Appiko/sense_snap_hw/README.md

This repository contains all the KiCad based PCB design and related documentation for all the circuit boards developed at Appiko. 

All the design files are licensed using [CERN Open Hardware Licence v1.2](https://ohwr.org/project/licenses/wikis/cern-ohl-v1.2).
