Appiko/sense_snap_hw/SenseCam_XHP70.2_rev1/README.md

# SenseCam_XHP70.2_rev1

This repo contains the Kicad PCB design of the first revision of SenseCam LED Flash with XHP70.2 high power LEDs. This board is designed to be driven by SenseCam_STCS2A_rev1 LED driver board, and work with SenseCam_rev1 to make night photography in pitch dark possible without motion blur.

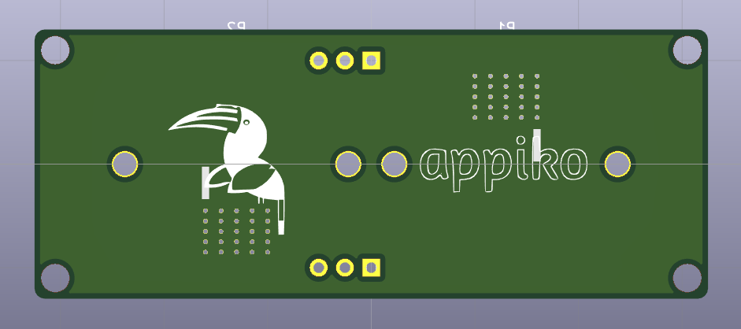
[picture p1: SenseCam_XHP70.2_rev1/Images/SenseCam_XHP70.2_rev1_back.png]
SenseCam_XHP70.2_rev1 back

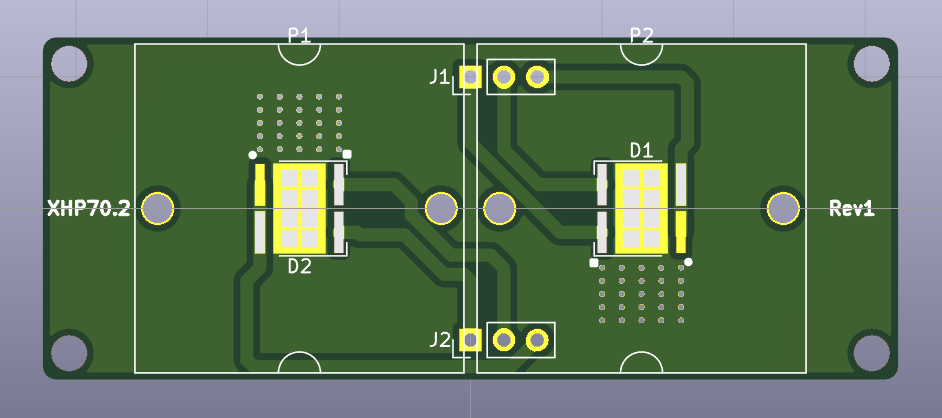
[picture p2: SenseCam_XHP70.2_rev1/Images/SenseCam_XHP70.2_rev1_front.png]
SenseCam_XHP70.2_rev1 front
