Appiko/sense_snap_hw/SenseCam_STCS2A_rev1/README.md

# SenseCam_STCS2A_rev1

This repo contains the Kicad PCB design of the first revision of SenseCam LED Flash driver board containing the STCS2A constant current LED driver IC. This board is designed to be driven by SenseCam_rev1 to provide enough current to drive the LEDs for a powerful flash.

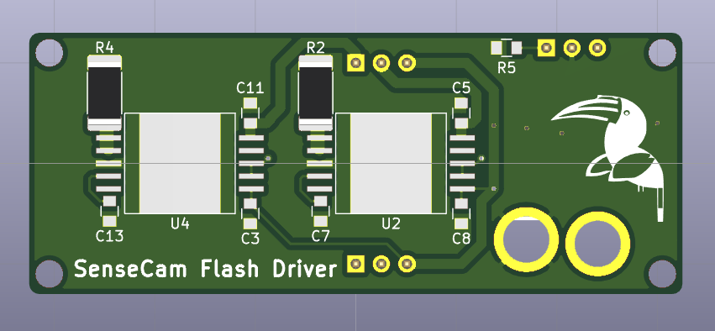
[picture p3: SenseCam_STCS2A_rev1/Images/SenseCam_STCS2A_rev1_back.png]
SenseCam_STCS2A_rev1 back

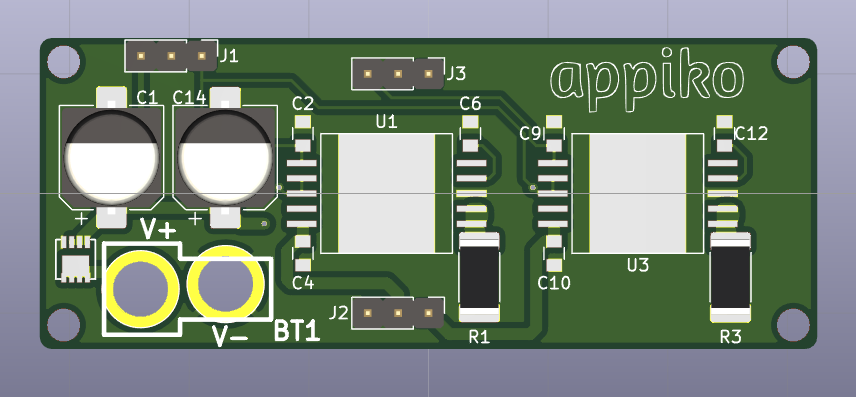
[picture p4: SenseCam_STCS2A_rev1/Images/SenseCam_STCS2A_rev1_front.png]
SenseCam_STCS2A_rev1 front
