Appiko/sense_snap_hw/detect_rev1/output/detect_rev1_back3D.png

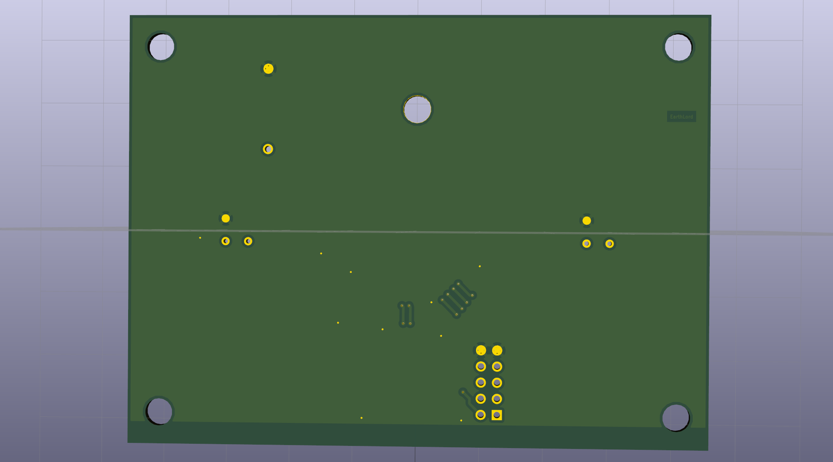
detect_rev1/output/detect_rev1_back3D.png
