Appiko/sense_snap_hw/detect_rev1/output/detect_rev1_front3D.png

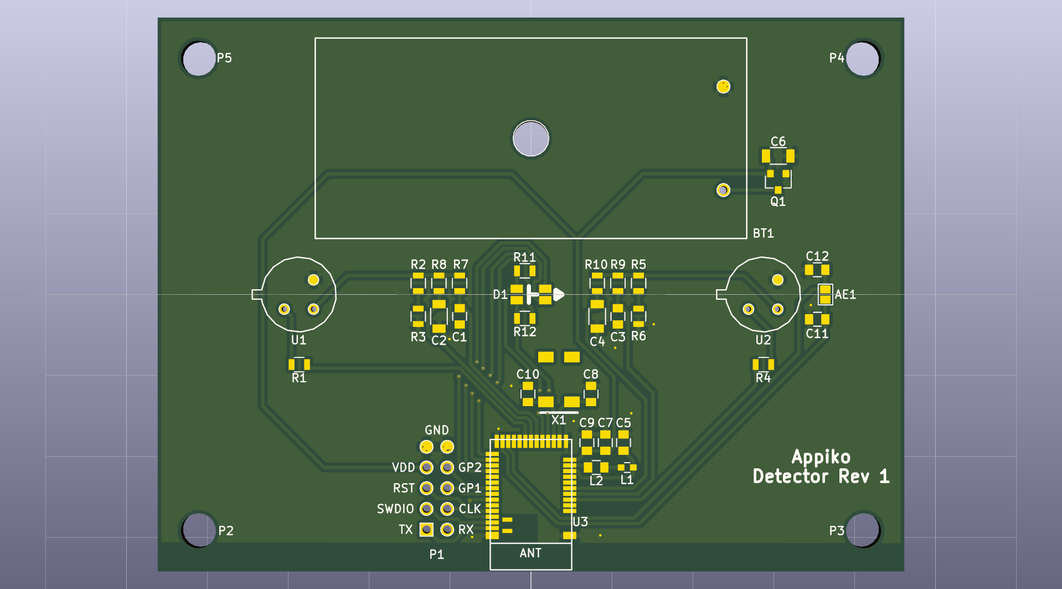
detect_rev1/output/detect_rev1_front3D.png
