Appiko/sense_snap_hw/senseBeRx_rev3/Images/SenseBeRx_rev3_2.png

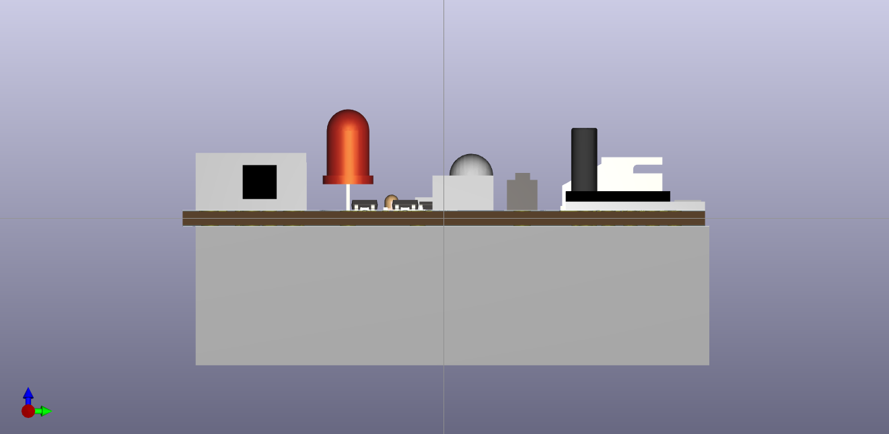
senseBeRx_rev3/Images/SenseBeRx_rev3_2.png
