Appiko/sense_snap_hw/snap_rev3/datasheets/LED_5mm_dimensions.jpg

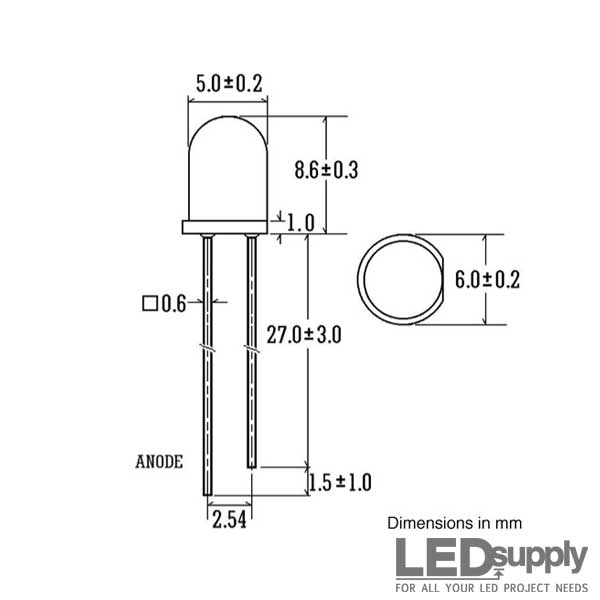
snap_rev3/datasheets/LED_5mm_dimensions.jpg
