Appiko/sense_snap_hw/snap_rev3/images/snap_rev3_02.png

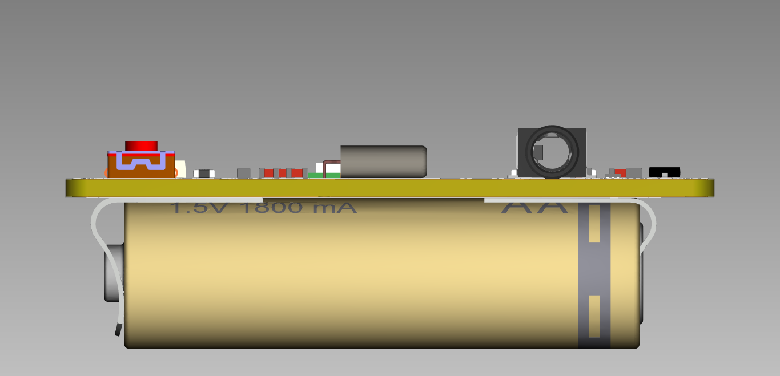
snap_rev3/images/snap_rev3_02.png
