Appiko/sense_snap_hw/AR0135_OpenMV_adapter_rev1/AR0135_OpenMV_adapter_rev1_3D Files/DF12(3.5)-36DP-0.5V.stp

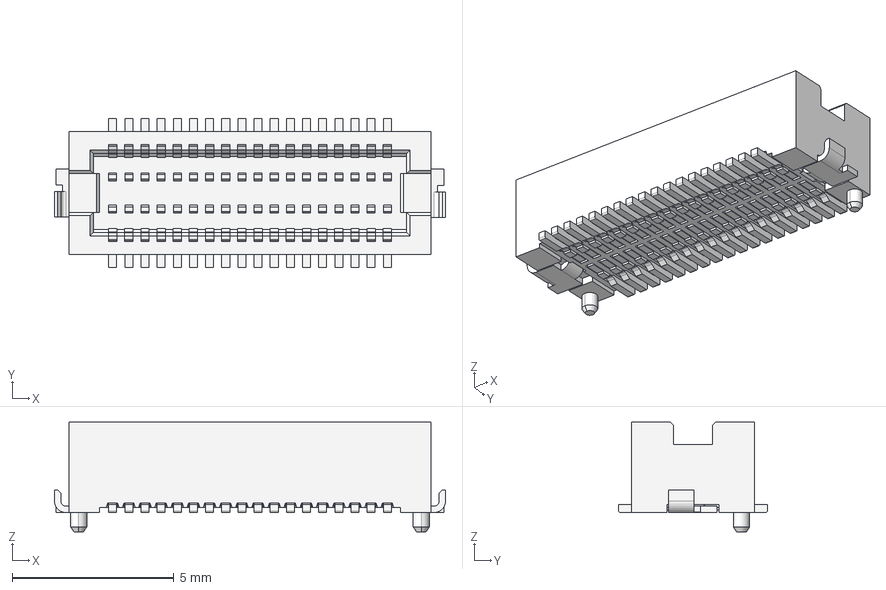
[picture p26: CAD file, 2019-07-17]
AR0135_OpenMV_adapter_rev1/AR0135_OpenMV_adapter_rev1_3D Files/DF12(3.5)-36DP-0.5V.stp
12.1 x 4.60 x 3.40 mm
