Appiko/sense_snap_hw/sense_rev5/SensePi_rev5_main/Datasheets/MDBT42Q_MDBT42Q-P Footprint_Design Guide-20171016/2D & 3D Drawing/MDBT42Q-P/MDBT42Q-P 2D Drawing-20170503.dxf

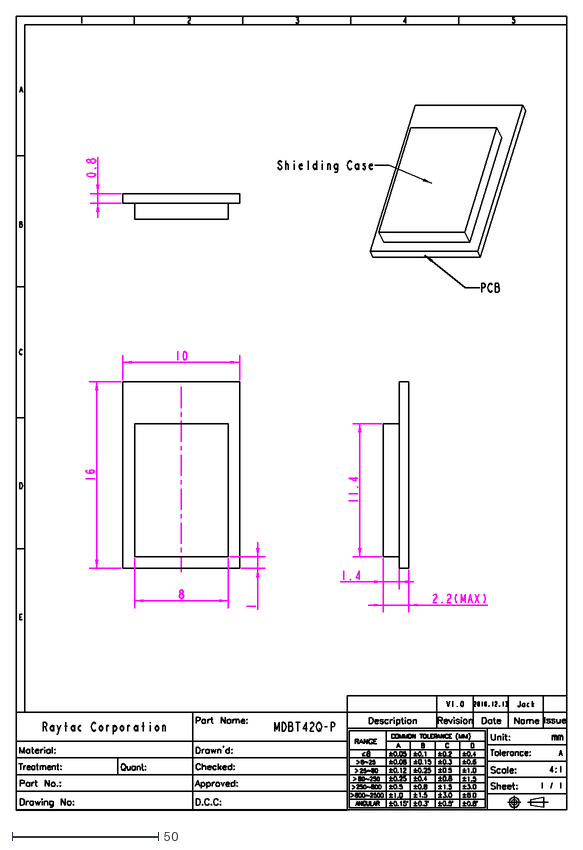
[picture p27: CAD file, 2018-01-06]
sense_rev5/SensePi_rev5_main/Datasheets/MDBT42Q_MDBT42Q-P Footprint_Design Guide-20171016/2D & 3D Drawing/MDBT42Q-P/MDBT42Q-P 2D Drawing-20170503.dxf
188.5 x 271.9
