Appiko/sense_snap_hw/senseBeRx_rev3/senseBeRx_rev3_3D_Files/SenseBeRx_3DModel.fcstd

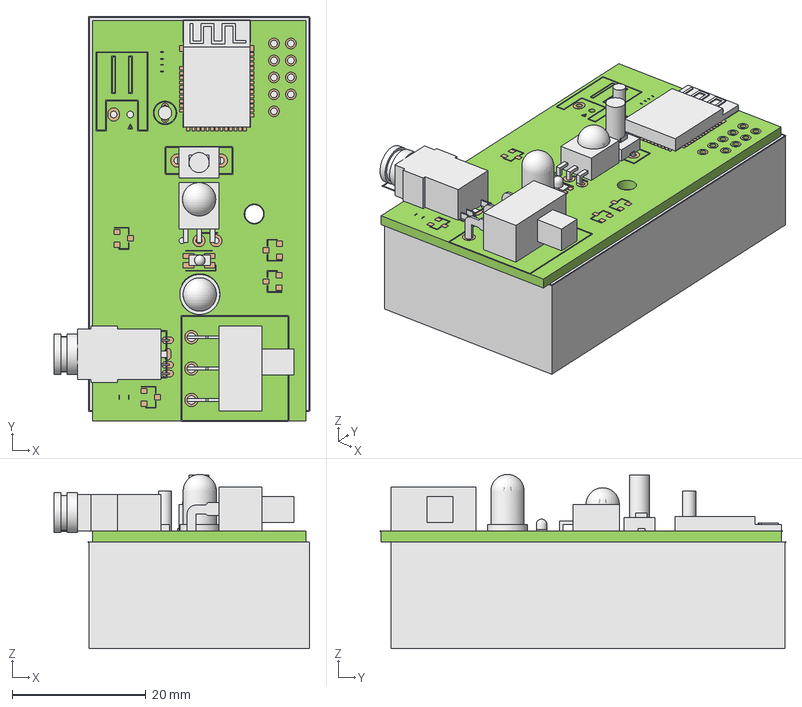
[picture p29: CAD file, 2019-01-24]
senseBeRx_rev3/senseBeRx_rev3_3D_Files/SenseBeRx_3DModel.fcstd
38.3 x 60.6 x 26.1 mm
PJ-32434_3-5mm_AudioJack
C5404_AAx2_Battery_Holder
Button_TC-1101T-C-A-B
nRF-MDBT42Q
RX_TSSP4056
LED
Crystal_THP001
Light_Sensor
Board
bPad_
tPad_
B_SilkS_
F_SilkS_
SlideSwitch_1P2T_RightAngle
Button
