Appiko/sense_snap_hw/snap_rev2_anool/fabricate/snap_rev2.fcstd

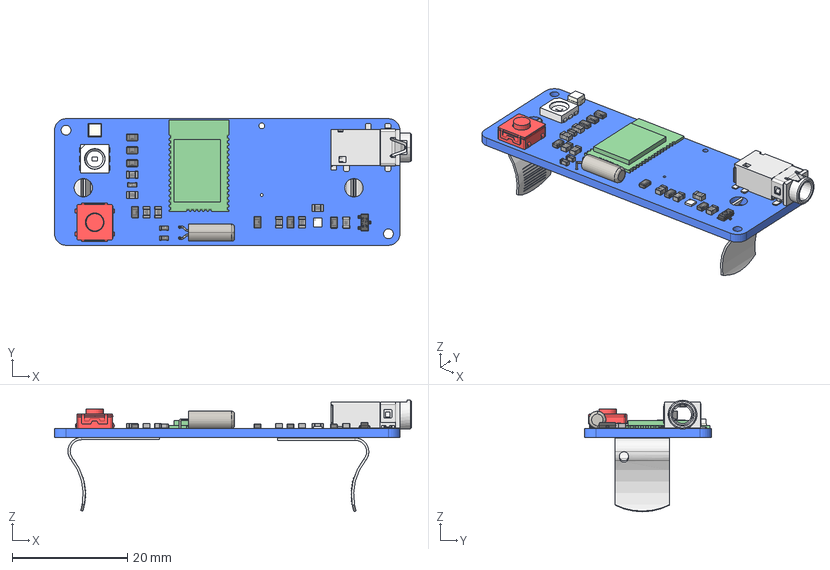
[picture p30: CAD file, 2017-11-04]
snap_rev2_anool/fabricate/snap_rev2.fcstd
62.0 x 22.0 x 19.4 mm
Pcb
TL3304_
IR26_
SW3dPS-0805_SMD_Resistor_
MDBT42Q_
WSON6_
SW3dPS-0805_SMD_Resistor_001
SW3dPS-0805_SMD_Resistor_002
SW3dPS-0805_SMD_Resistor_003
SW3dPS-0805_SMD_Resistor_004
SW3dPS-0805_SMD_Resistor_005
SW3dPS-0805_SMD_Resistor_006
Tr_SOT23_
CapCeramic_080_
CapCeramic_080_001
CapCeramic_0603_
CapCeramic_080_002
CapCeramic_0603_001
CapCeramic_080_003
CapCeramic_0603_002
CapCeramic_080_004
CapCeramic_080_005
CapCeramic_080_006
CapCeramic_080_007
sj2-35894b-smt-tr002_
xtal-AB308_
keystone_208_
