Appiko/sense_snap_hw/snap_rev3/3d_modules/keystone_206.step

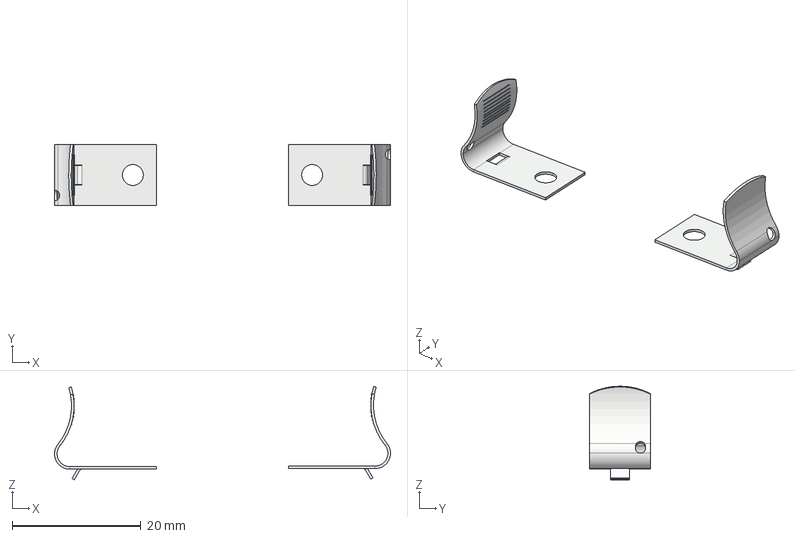
[picture p31: CAD file, 2017-11-07]
snap_rev3/3d_modules/keystone_206.step
52.3 x 9.53 x 14.6 mm
