Appiko/sense_snap_hw/snap_rev3/fabricate/case_rev1/case_bot.stl

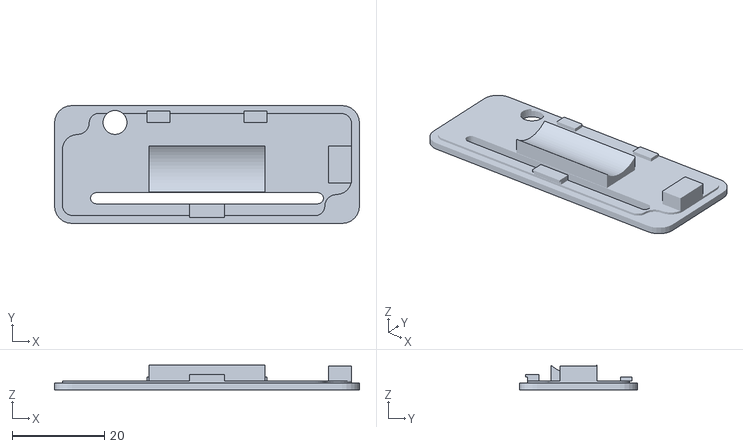
[picture p32: CAD file, 2017-11-12]
snap_rev3/fabricate/case_rev1/case_bot.stl
66.0 x 25.5 x 5.41
