Appiko/sense_snap_hw/snap_rev3/fabricate/snap_case_rev2_mid.stl

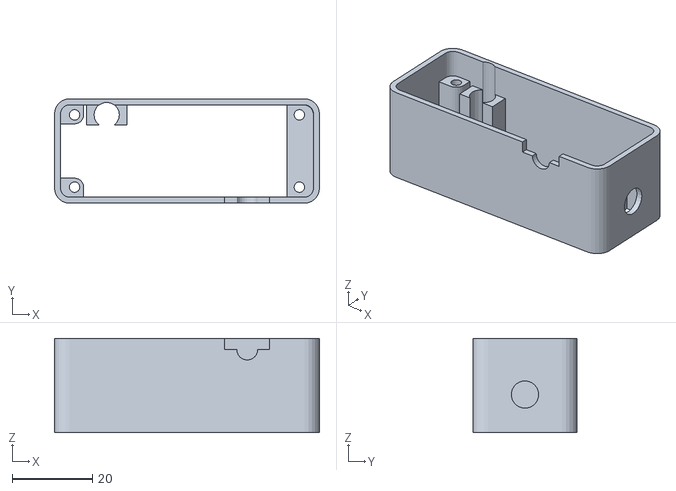
[picture p33: CAD file, 2018-01-18]
snap_rev3/fabricate/snap_case_rev2_mid.stl
66.0 x 26.0 x 23.5
