Appiko/sense_snap_hw/snap_rev3/3d_modules/LED-5-mm.step

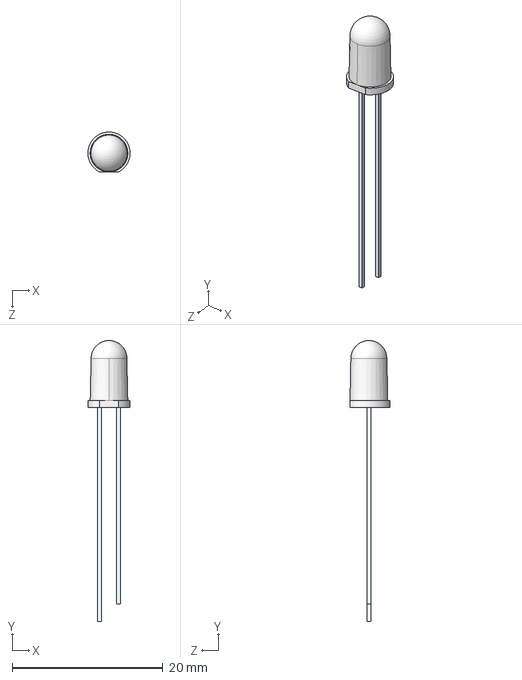
[picture p34: CAD file, 2017-11-06]
snap_rev3/3d_modules/LED-5-mm.step
5.60 x 37.2 x 5.30 mm
User Library-LED 5 mm Full_lED Leg
User Library-LED 5 mm Full_LED F
