Appiko/sense_snap_hw/snap_rev3/fabricate/case_rev1/case_button.stl

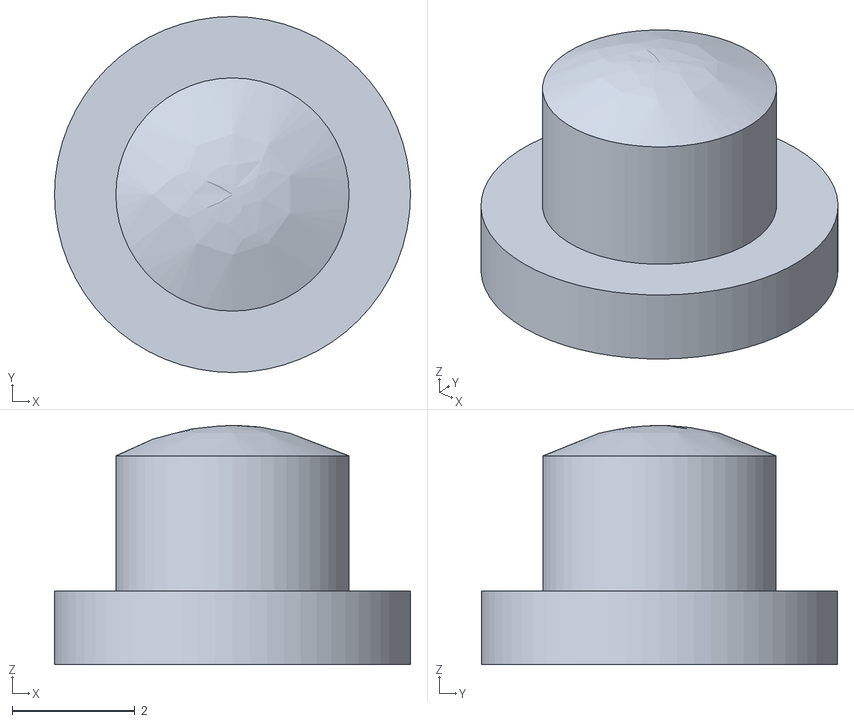
[picture p35: CAD file, 2017-11-12]
snap_rev3/fabricate/case_rev1/case_button.stl
5.80 x 5.80 x 3.89
