Appiko/sense_snap_hw/snap_rev3/3d_modules/sw_TL3304AFxxxQJ.stp

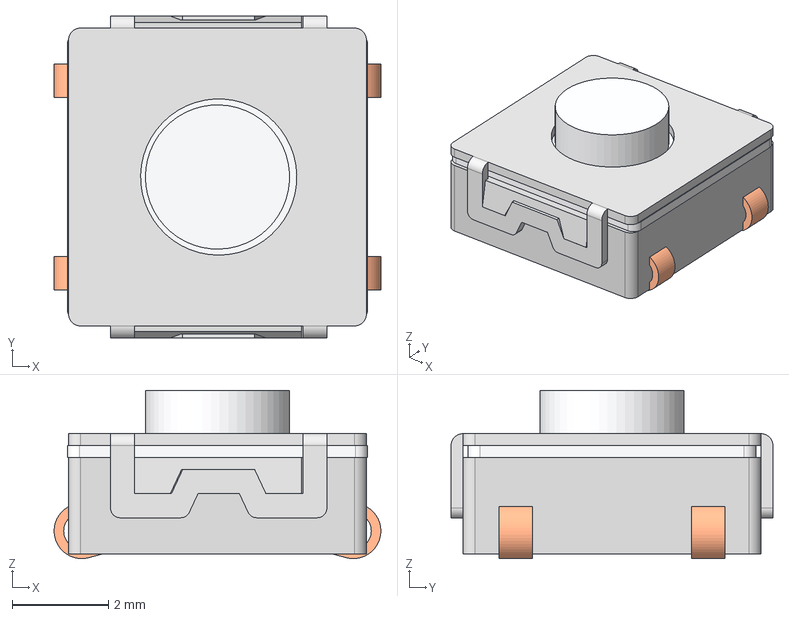
[picture p36: CAD file, 2017-11-04]
snap_rev3/3d_modules/sw_TL3304AFxxxQJ.stp
6.80 x 6.70 x 3.50 mm
TL3304BODY
TL3304 BRACKET
TL3304ASEAL
TL3304-Terminals J-LEAD
