Appiko/sense_snap_hw/snap_rev3/fabricate/snap_case_rev2_top.stl

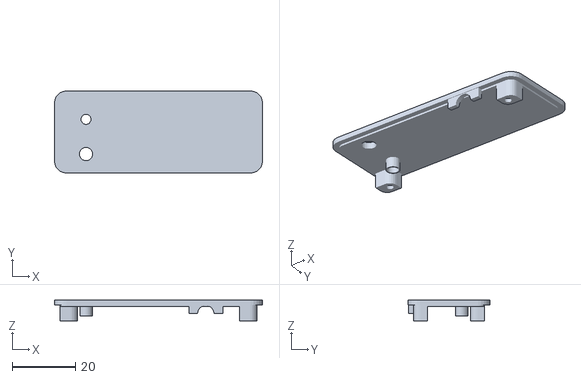
[picture p37: CAD file, 2018-01-18]
snap_rev3/fabricate/snap_case_rev2_top.stl
66.0 x 26.0 x 6.60
