Appiko/sense_snap_hw/snap_rev3/3d_modules/TL3304.step

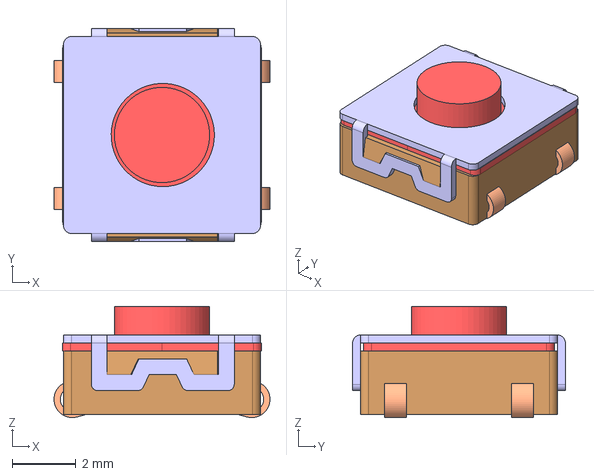
[picture p38: CAD file, 2017-11-04]
snap_rev3/3d_modules/TL3304.step
6.80 x 6.70 x 3.50 mm
