Appiko/sense_snap_hw/snap_rev3/fabricate/snap_case_rev2_bot.stl

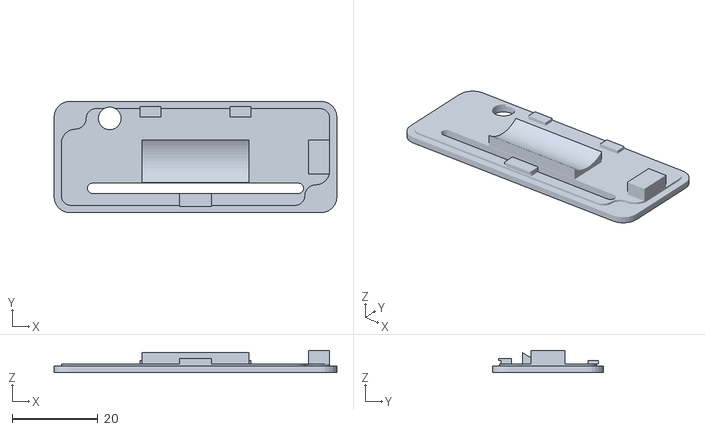
[picture p39: CAD file, 2018-01-18]
snap_rev3/fabricate/snap_case_rev2_bot.stl
66.0 x 26.0 x 5.20
