Appiko/sense_snap_hw/snap_rev3/3d_modules/sj2-35894b-smt.step

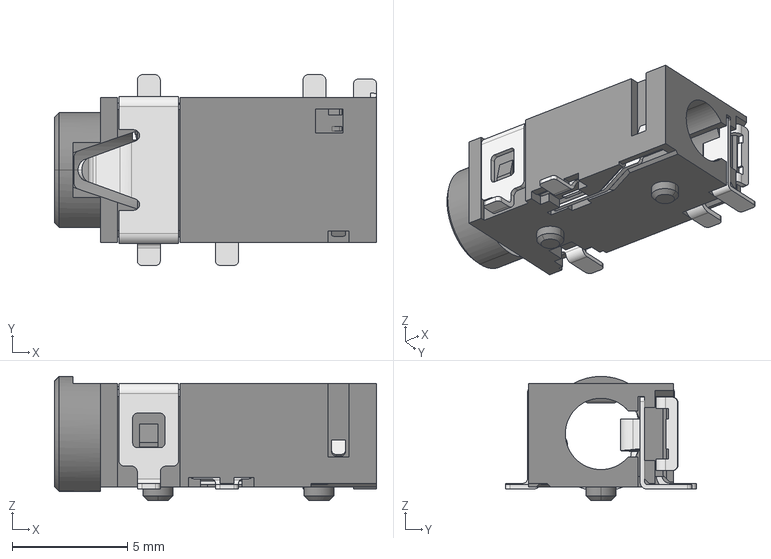
[picture p40: CAD file, 2017-11-03]
snap_rev3/3d_modules/sj2-35894b-smt.step
14.0 x 8.30 x 5.40 mm
