Appiko/sense_snap_hw/snap_rev3/fabricate/case_rev1/case_top.stl

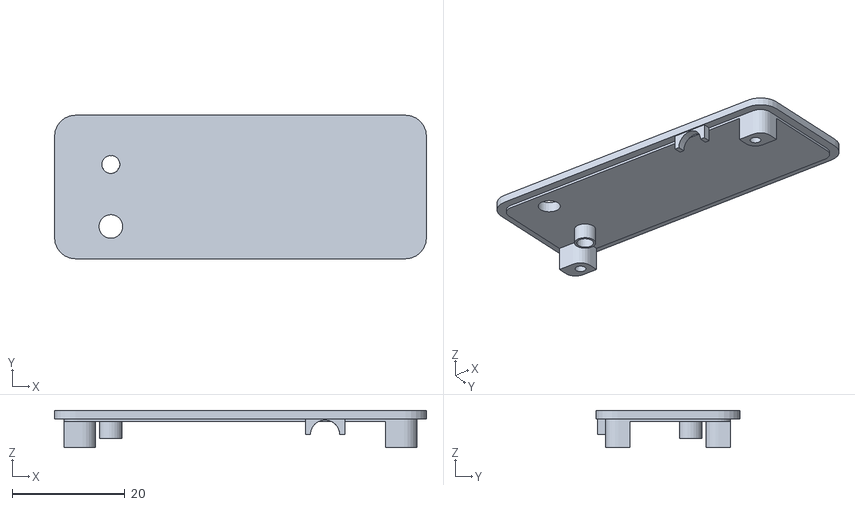
[picture p41: CAD file, 2017-11-12]
snap_rev3/fabricate/case_rev1/case_top.stl
66.0 x 25.5 x 6.60
