Appiko/sense_snap_hw/snap_rev3/3d_modules/IR26_VSMY2850RG.STEP

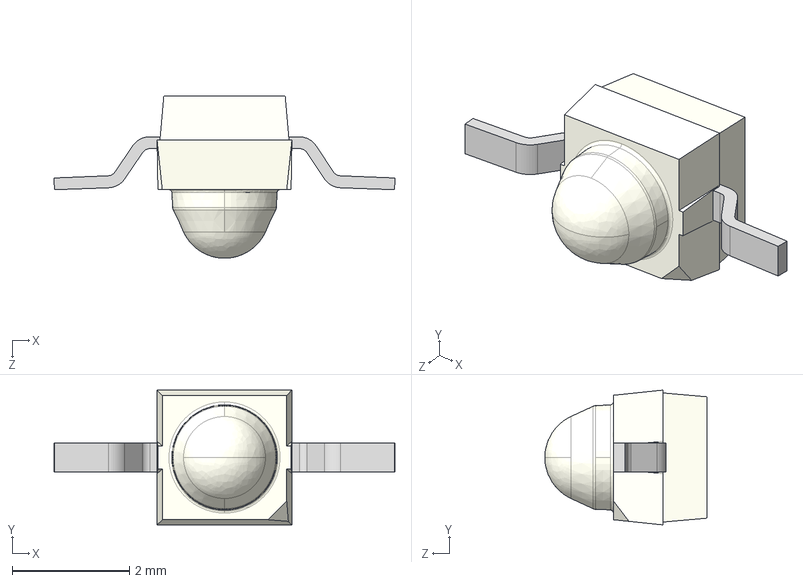
[picture p42: CAD file, 2017-11-03]
snap_rev3/3d_modules/IR26_VSMY2850RG.STEP
5.81 x 2.30 x 2.77 mm
User Library-VSMY2850RG_Free-Models
User Library-VSMY2850RG_Fillet001
