Appiko/sense_snap_hw/snap_rev3/fabricate/BATTERY_AA.step

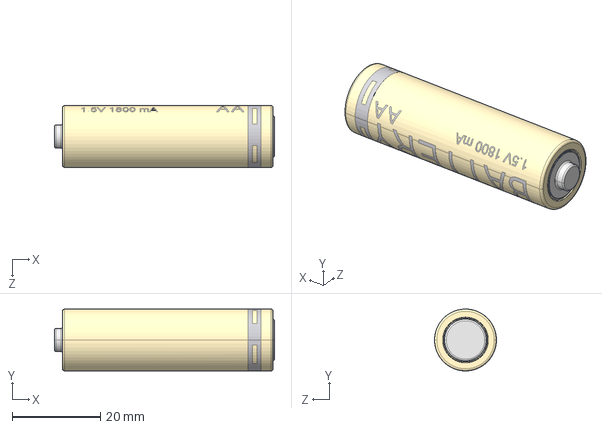
[picture p43: CAD file, 2017-11-04]
snap_rev3/fabricate/BATTERY_AA.step
49.8 x 14.0 x 14.0 mm
