Appiko/sense_snap_hw/snap_rev3/fabricate/case_rev1/snap_rev3.FCStd

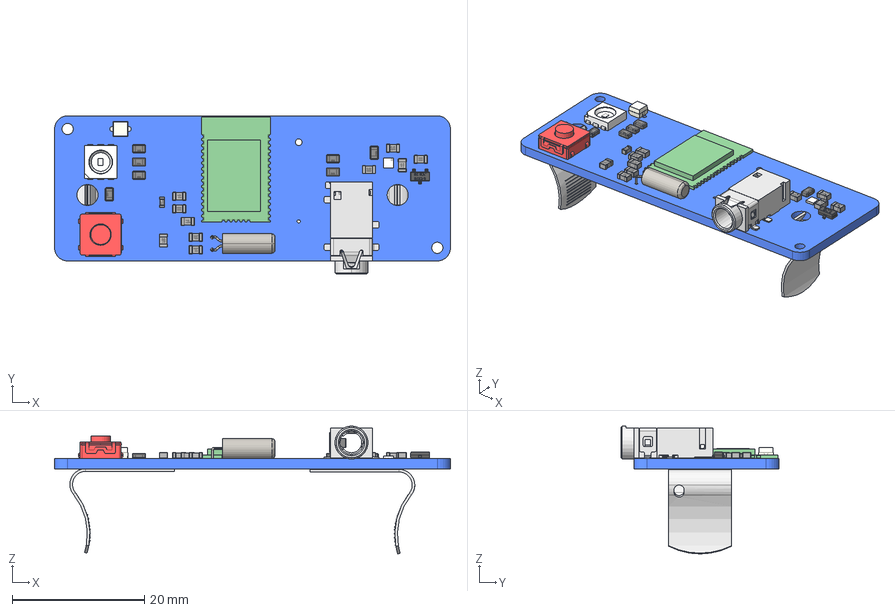
[picture p44: CAD file, 2017-11-07]
snap_rev3/fabricate/case_rev1/snap_rev3.FCStd
60.0 x 24.0 x 19.4 mm
Pcb
xtal-AB308_
CapCeramic_080_
CapCeramic_080_001
IR26_
keystone_208_
TL3304_
SW3dPS-0805_SMD_Resistor_
MDBT42Q_
WSON6_
SW3dPS-0805_SMD_Resistor_001
SW3dPS-0805_SMD_Resistor_002
SW3dPS-0805_SMD_Resistor_003
SW3dPS-0805_SMD_Resistor_004
SW3dPS-0805_SMD_Resistor_005
SW3dPS-0805_SMD_Resistor_006
Tr_SOT23_
CapCeramic_080_002
CapCeramic_080_003
CapCeramic_0603_
CapCeramic_080_004
CapCeramic_080_005
CapCeramic_080_006
CapCeramic_080_007
CapCeramic_080_008
CapCeramic_080_009
sj2-35894b-smt-tr002_
