Appiko/sense_snap_hw/snap_rev3/3d_modules/nrf52.step

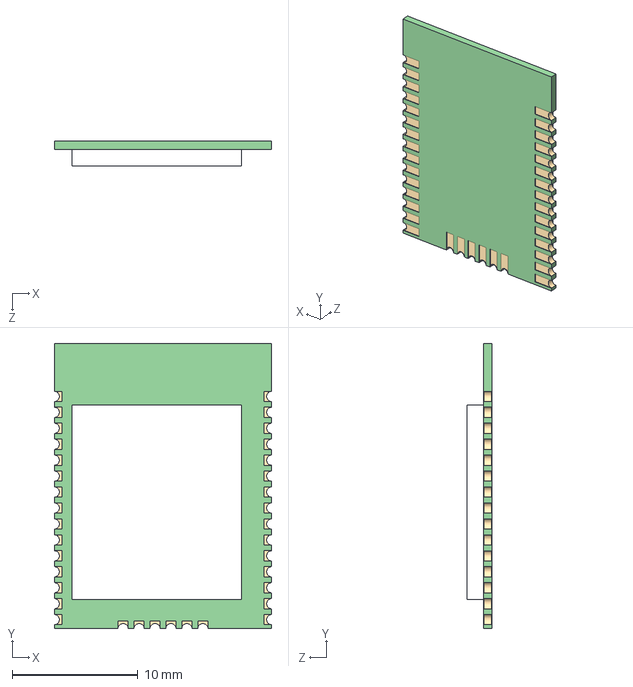
[picture p45: CAD file, 2017-11-03]
snap_rev3/3d_modules/nrf52.step
17.3 x 22.7 x 2.00 mm
