Appiko/sense_snap_hw/snap_rev3/3d_modules/IR26.step

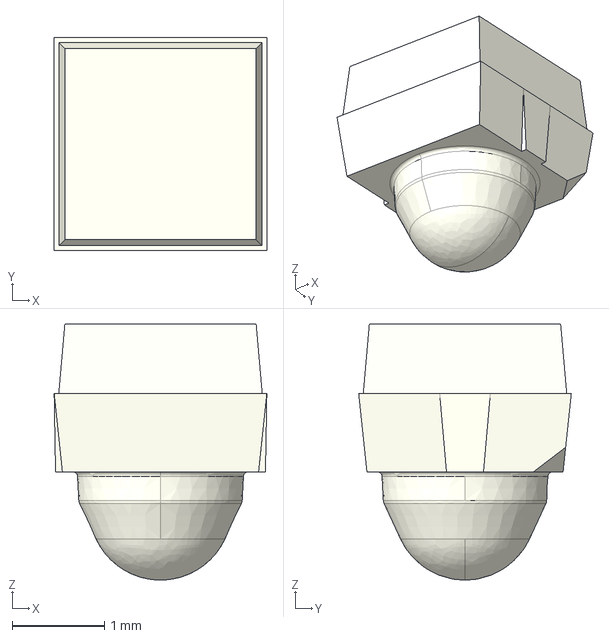
[picture p46: CAD file, 2017-11-03]
snap_rev3/3d_modules/IR26.step
2.30 x 2.30 x 2.77 mm
