Appiko/sense_snap_hw/snap_rev3/3d_modules/WSON6.step

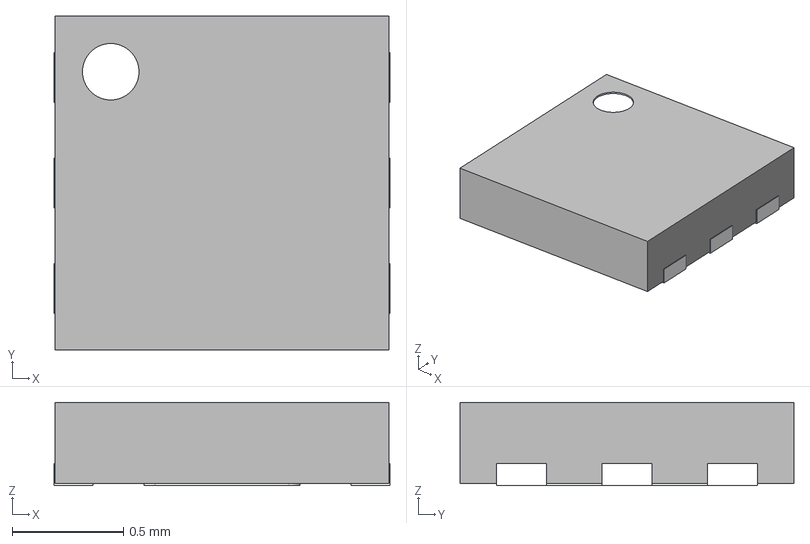
[picture p47: CAD file, 2017-11-03]
snap_rev3/3d_modules/WSON6.step
1.51 x 1.50 x 0.375 mm
