Appiko/sense_snap_hw/snap_rev3/3d_modules/xtal-AB308.step

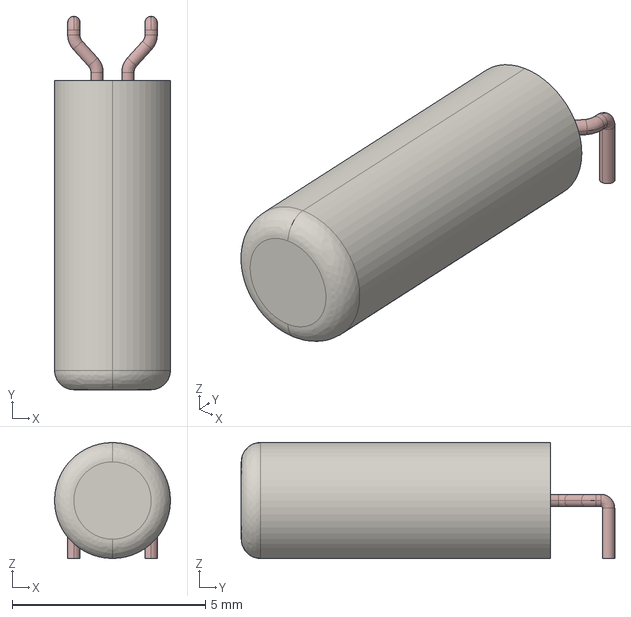
[picture p48: CAD file, 2017-11-03]
snap_rev3/3d_modules/xtal-AB308.step
3.00 x 9.66 x 3.00 mm
