Appiko/sense_snap_hw/snap_rev3/3d_modules/SW_smd.step

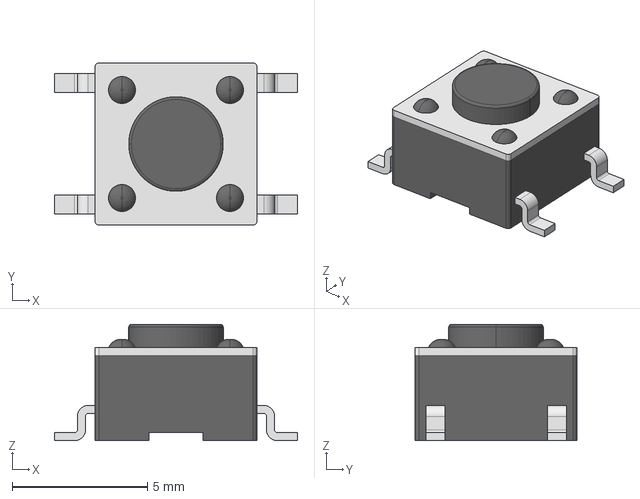
[picture p49: CAD file, 2017-11-03]
snap_rev3/3d_modules/SW_smd.step
9.00 x 6.00 x 4.30 mm
