Appiko/sense_snap_hw/snap_rev3/3d_modules/LED_SMD_APA102.step

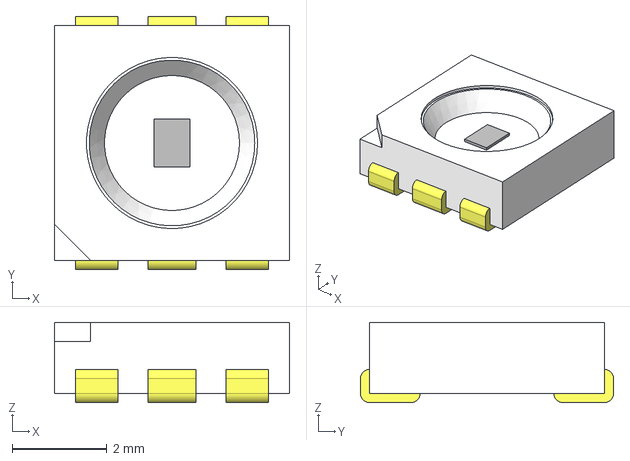
[picture p50: CAD file, 2017-11-03]
snap_rev3/3d_modules/LED_SMD_APA102.step
4.95 x 5.33 x 1.69 mm
