Appiko/sense_snap_hw/snap_rev3/3d_modules/MDBT42Q.step

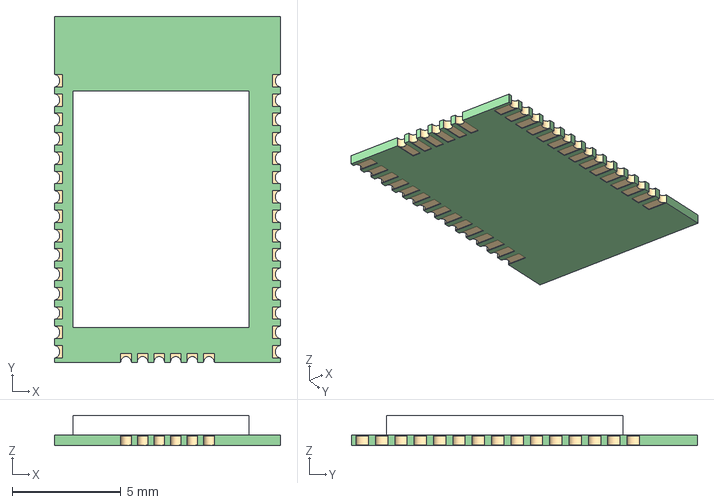
[picture p51: CAD file, 2017-11-03]
snap_rev3/3d_modules/MDBT42Q.step
10.4 x 15.9 x 1.40 mm
