Appiko/sense_snap_hw/snap_rev3/3d_modules/IR26_VSMB2020X01.step

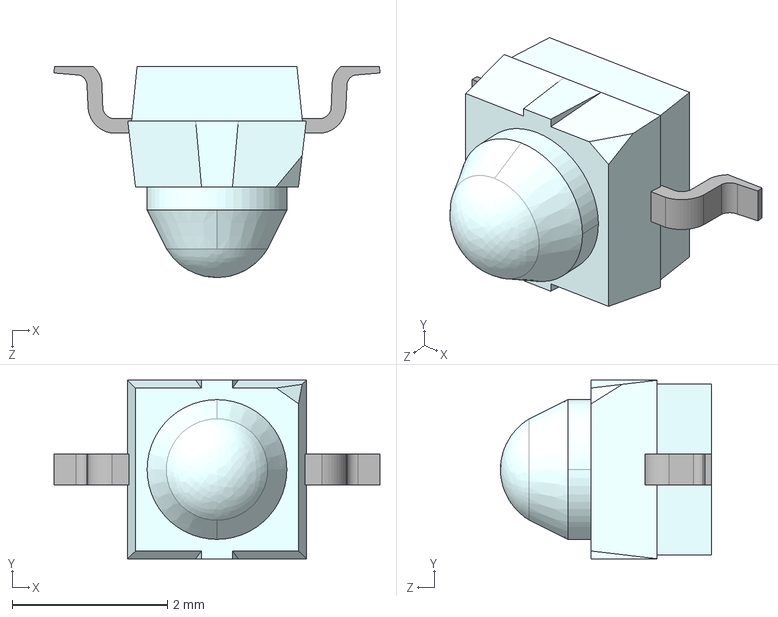
[picture p52: CAD file, 2017-11-03]
snap_rev3/3d_modules/IR26_VSMB2020X01.step
4.20 x 2.30 x 2.72 mm
