Appiko/sense_snap_hw/snap_rev3/3d_modules/PLCC_6_LED.step

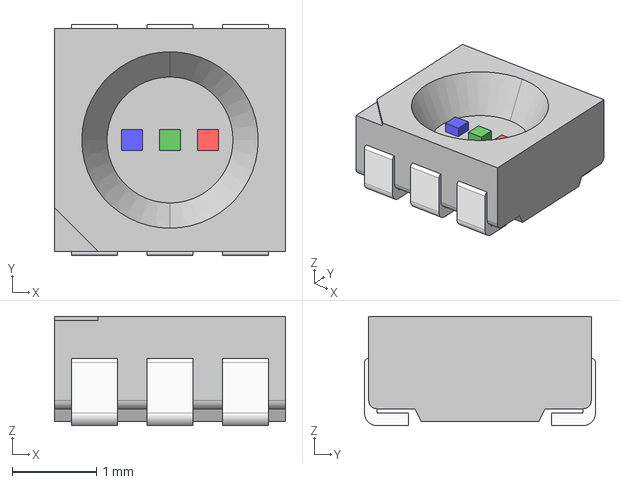
[picture p53: CAD file, 2017-11-03]
snap_rev3/3d_modules/PLCC_6_LED.step
2.75 x 2.75 x 1.30 mm
