Appiko/sense_snap_hw/snap_rev3/3d_modules/SMD_Resistor_0805.step

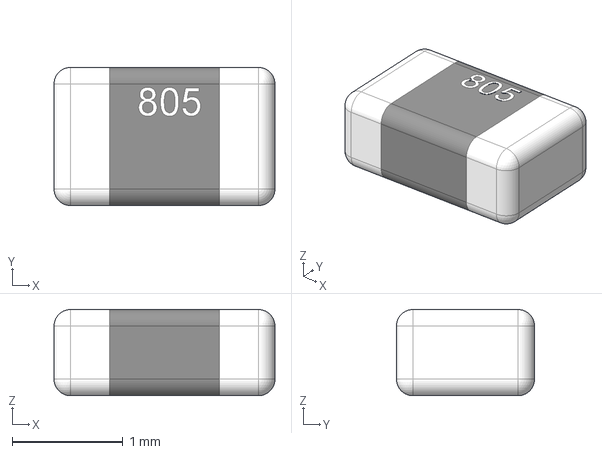
[picture p54: CAD file, 2017-11-03]
snap_rev3/3d_modules/SMD_Resistor_0805.step
2.00 x 1.25 x 0.782 mm
