Appiko/sense_snap_hw/snap_rev3/3d_modules/CapCeramic_0603.step

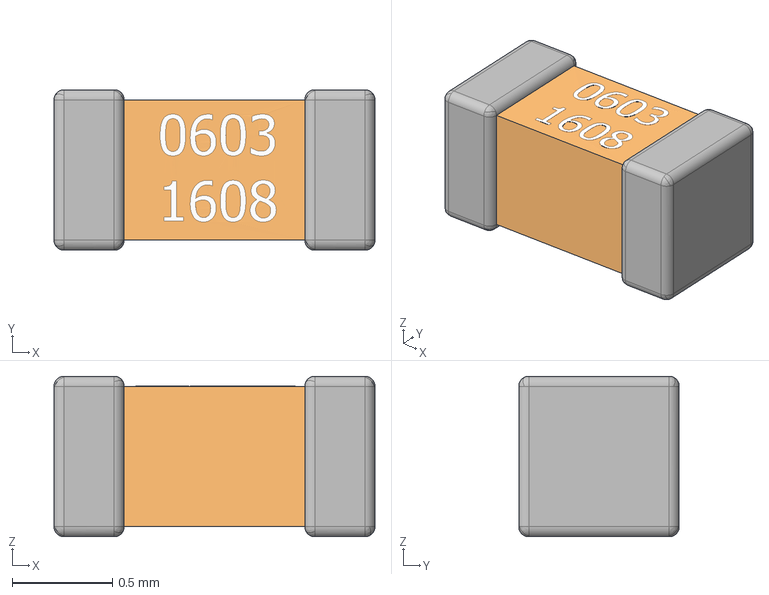
[picture p55: CAD file, 2017-11-03]
snap_rev3/3d_modules/CapCeramic_0603.step
1.60 x 0.8 x 0.8 mm
