Appiko/sense_snap_hw/snap_rev3/3d_modules/keystone-PN206.step

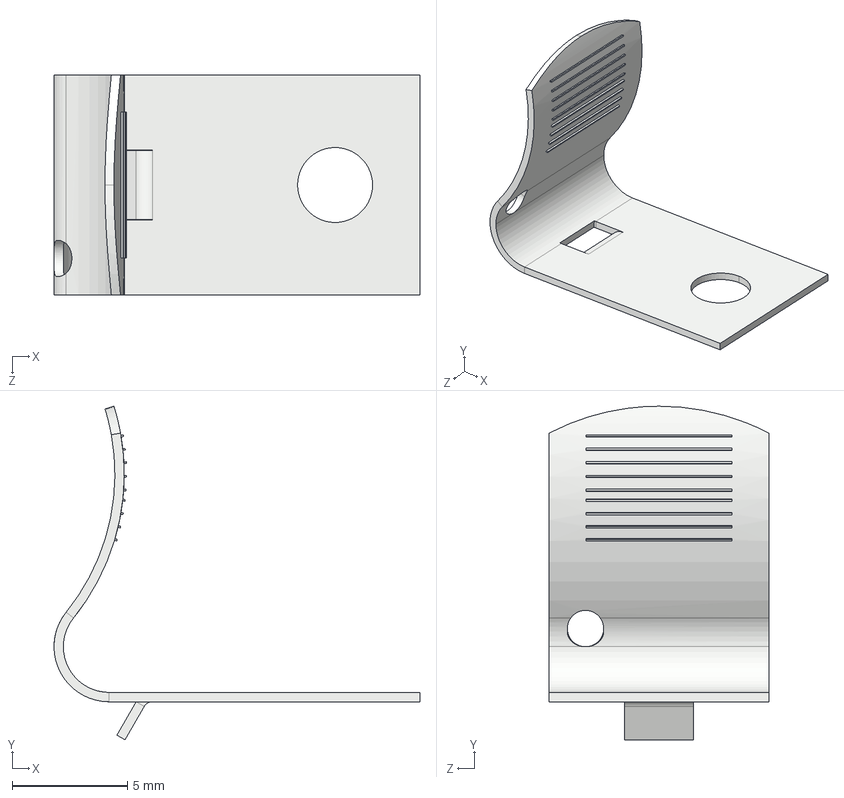
[picture p56: CAD file, 2017-11-03]
snap_rev3/3d_modules/keystone-PN206.step
15.9 x 14.5 x 9.53 mm
