Appiko/sense_snap_hw/snap_rev3/3d_modules/Tr_SOT23.step

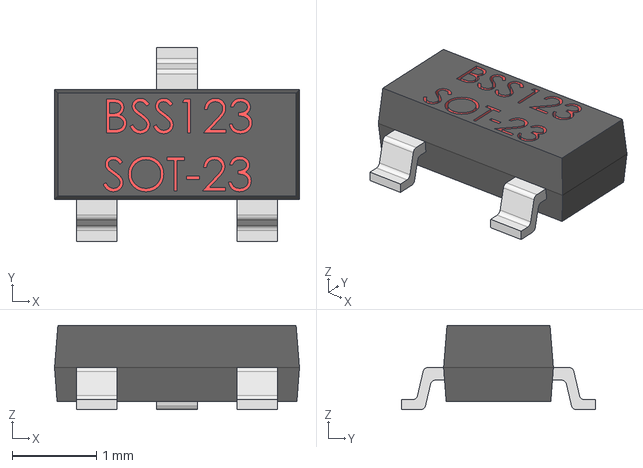
[picture p57: CAD file, 2017-11-03]
snap_rev3/3d_modules/Tr_SOT23.step
2.90 x 2.30 x 1.00 mm
