Appiko/sense_snap_hw/(list of files, cad)

Other CAD files:
snap_rev3/fabricate/snap_case_rev2.fcstd
snap_rev3/fabricate/case_rev1/case_mid.stl
snap_rev3/fabricate/case_rev1/snap_case.fcstd
snap_rev3/3d_modules/sj2-35894b-smt-tr.step
snap_rev3/3d_modules/r_0805.step
AR0135_OpenMV_adapter_rev1/AR0135_OpenMV_adapter_rev1_3D Files/541323062.stp
senseBe_rev1/senseBe_rev1_3D_Files/KPTBD-3216SURKCGKC.step
senseBe_rev2/senseBe_rev2_3D_Files/PJ-32434_3-5mmAudioJack.step
senseBe_rev3/senseBe_rev3_daughter/senseBe_rev3_daughter_3D_Files/Button_TC-1101T-C-A-B.step
senseBe_rev3/senseBe_rev3_daughter/senseBe_rev3_daughter_3D_Files/C5404_AAx2_Battery_Holder.step
senseBe_rev3/senseBe_rev3_daughter/senseBe_rev3_daughter_3D_Files/JTAG Conn 2x5.step
senseBe_rev3/senseBe_rev3_daughter/senseBe_rev3_daughter_3D_Files/RIght Angle_Tactile_Push_Button.step
senseBe_rev3/senseBe_rev3_daughter/senseBe_rev3_daughter_3D_Files/SlideSwitch_1P2T_RightAngle.step
senseBe_rev3/senseBe_rev3_daughter/senseBe_rev3_daughter_3D_Files/Stereo Socket 3.5mm SMD.step
senseBe_rev3/senseBe_rev3_main/senseBe_rev3_main_3D_Files/18-225_R6G6C-A01_3T.step
senseBe_rev3/senseBe_rev3_main/senseBe_rev3_main_3D_Files/5mm_LED.step
senseBe_rev3/senseBe_rev3_main/senseBe_rev3_main_3D_Files/C5404_AAx2_Battery_Holder.step
senseBe_rev3/senseBe_rev3_main/senseBe_rev3_main_3D_Files/JTAG Conn 2x5 F.step
senseBe_rev3/senseBe_rev3_main/senseBe_rev3_main_3D_Files/RX_TSSP4056.step
senseBe_rev3/senseBe_rev3_main/senseBe_rev3_main_3D_Files/Slide Switch 1P2T High Current Right Angle.step
senseBe_rev3/senseBe_rev3_main/senseBe_rev3_main_3D_Files/nRF-MDBT42Q.step
sense_rev5/SensePi_rev5_main/Datasheets/MDBT42Q_MDBT42Q-P Footprint_Design Guide-20171016/2D & 3D Drawing/MDBT42Q-P/MDBT42Q-P 2D Drawing-20170503.dwg
sense_rev5/SensePi_rev5_main/Datasheets/MDBT42Q_MDBT42Q-P Footprint_Design Guide-20171016/2D & 3D Drawing/MDBT42Q/MDBT42Q 2D Drawing-20170503.dwg
snap_rev3/fabricate/nut_quarter_inch.stp
