Appiko/sense_snap_hw/sense_rev5/SensePi_rev5_main/Datasheets/MDBT42Q_MDBT42Q-P Footprint_Design Guide-20171016/Footprint2017-10-16/MDBT42Q_MDBT42Q-P Protel_171016/Read Me.txt

Files are compatible with Protel 99 or Altium Design
