Appiko/sense_snap_hw/sense_rev5/SensePi_rev5_main/Datasheets/MDBT42Q_MDBT42Q-P Footprint_Design Guide-20171016/Footprint2017-10-16/MDBT42Q_MDBT42Q-P Protel_171016/MDBT42Q Protel Library-171016.jpg

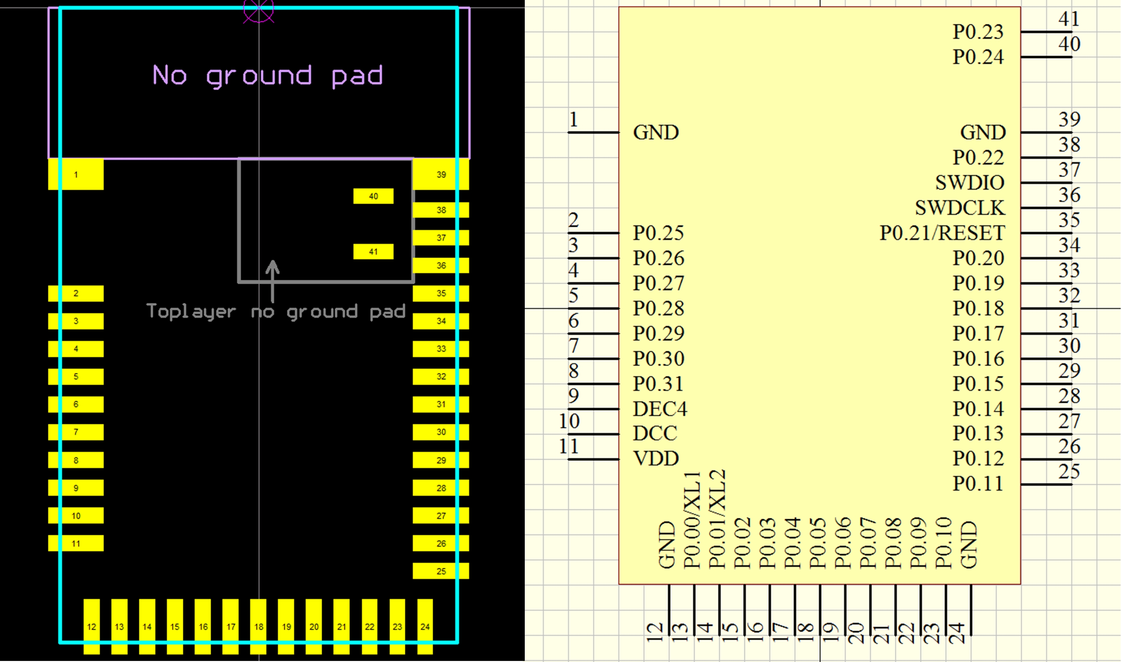
sense_rev5/SensePi_rev5_main/Datasheets/MDBT42Q_MDBT42Q-P Footprint_Design Guide-20171016/Footprint2017-10-16/MDBT42Q_MDBT42Q-P Protel_171016/MDBT42Q Protel Library-171016.jpg
