Appiko/sense_snap_hw/snap_rev3/fabricate/images/case_01.png

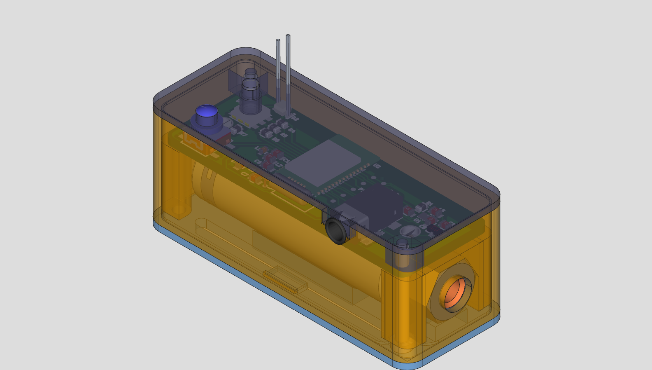
snap_rev3/fabricate/images/case_01.png
