Appiko/sense_snap_hw/snap_rev3/fabricate/images/case_05.png

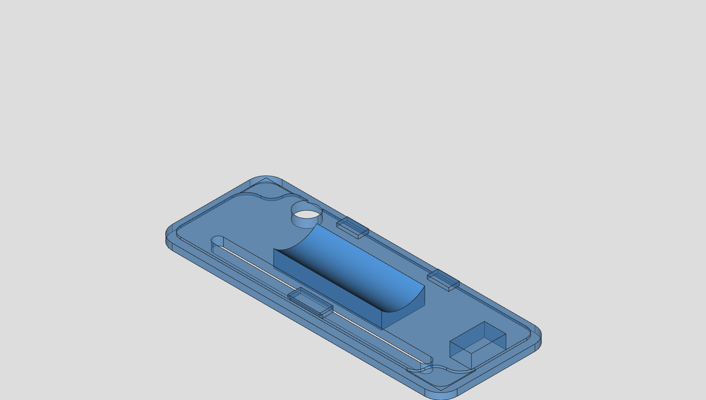
snap_rev3/fabricate/images/case_05.png
