Appiko/sense_snap_hw/snap_rev3/fabricate/images/case_07.png

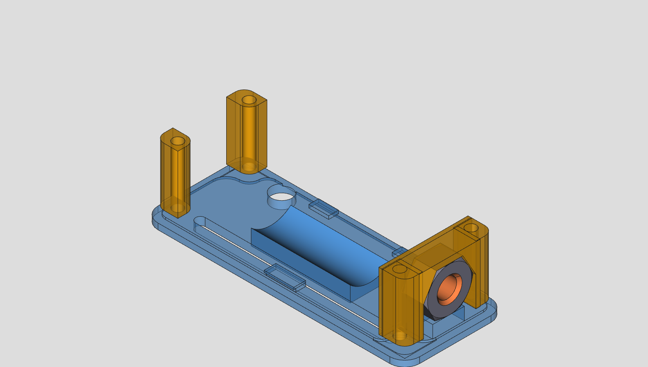
snap_rev3/fabricate/images/case_07.png
