Appiko/sense_snap_hw/snap_rev1/errata.md

# Errata of the first version of Snap revision 1

- Lack of pull down on the REG_MODE line which makes it floating, which is discouraged in the datasheet.
- Lack of any means to measure the battery voltage.
- The ground pad recommendations of the nRF52 modules aren't followed.
