Appiko/sense_snap_hw/L80_adapter/documents/L80_adapter.pdf

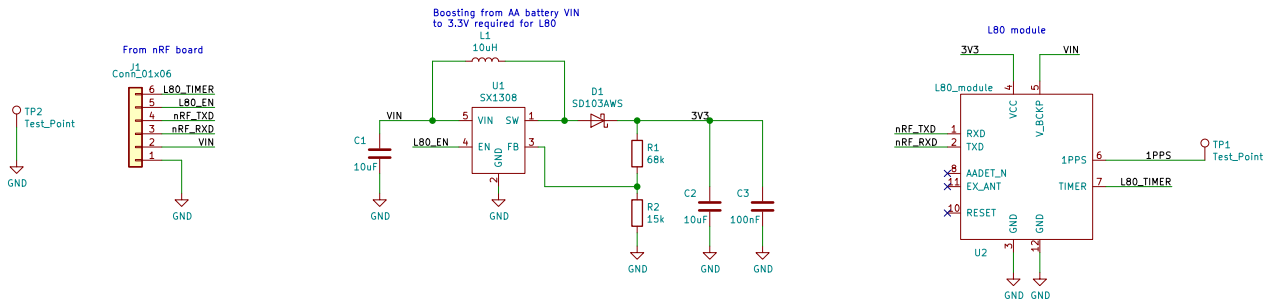
[picture p65: page 1]

Boosting from AA battery VIN
