Appiko/sense_snap_hw/senseRx_rev1/Documents/senseRx_rev1.pdf

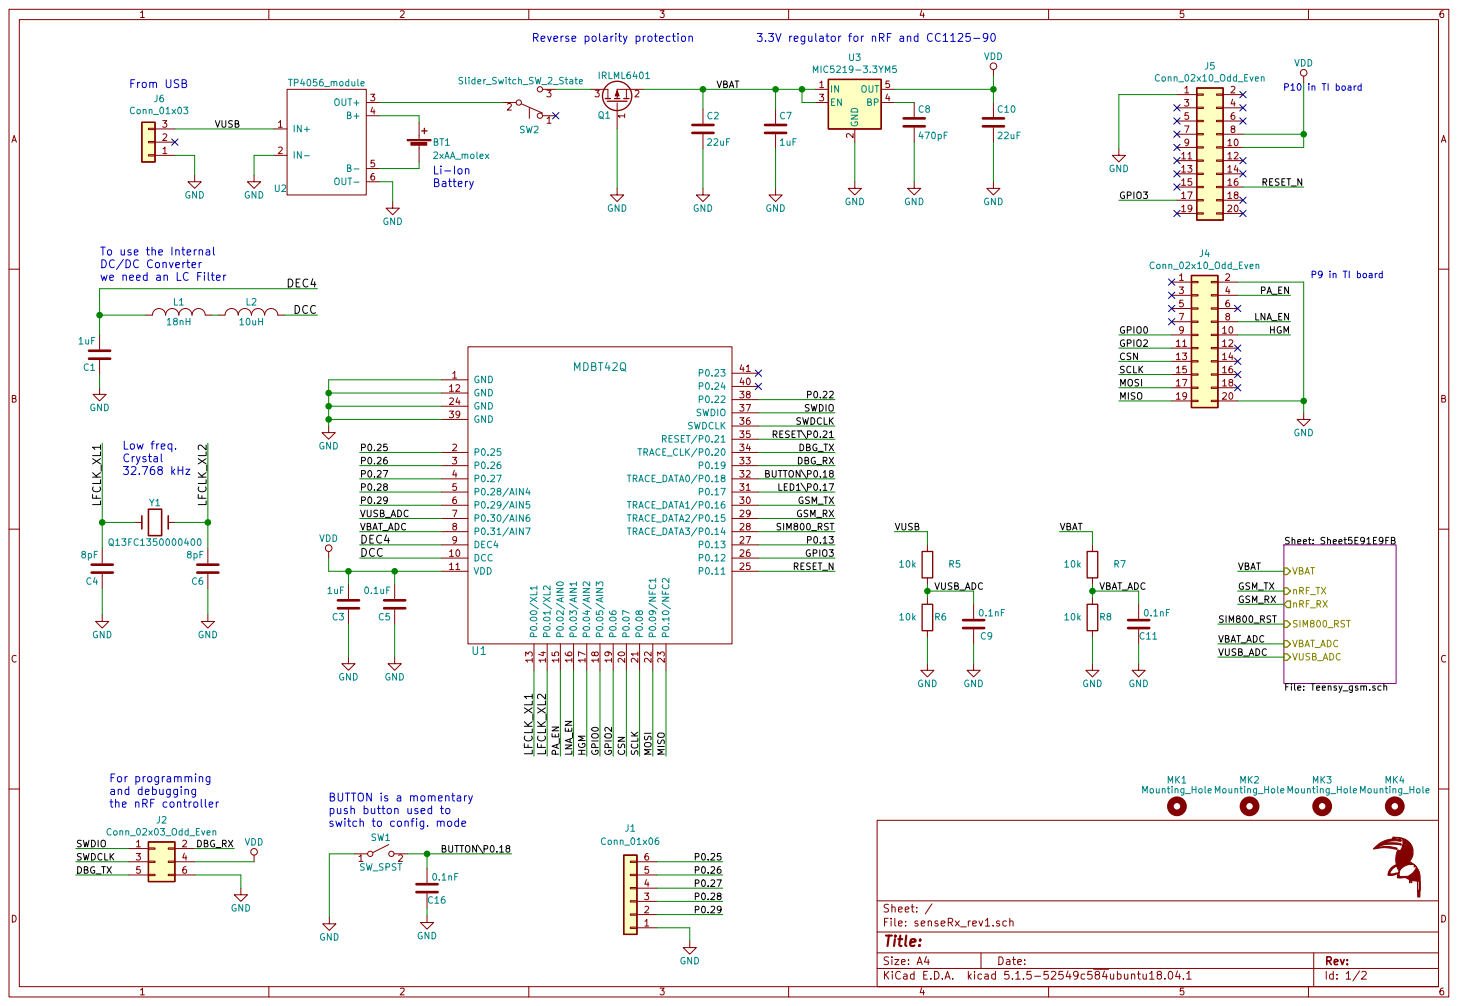
[picture p66: page 1]

SWDCLK 3.3V regulator for nRF and CC1125-90

From USB
P9 in TI board P10 in TI board Low freq.
J6 Conn_01x03

To use the Internal DC/DC Converter

BUTTON is a momentary
push button used to
switch to config. mode

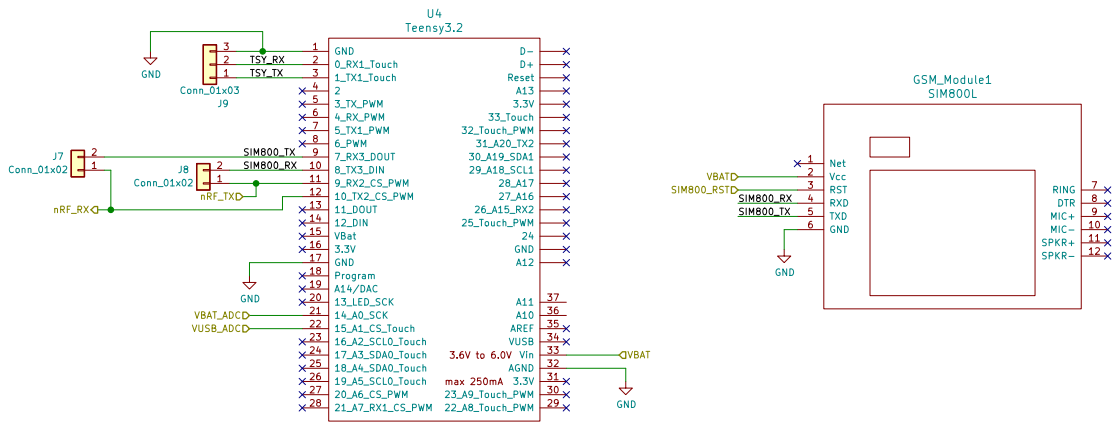
[picture p67: page 2]
