Appiko/sense_snap_hw/senseble_rev1/Documents/senseble_rev1.pdf

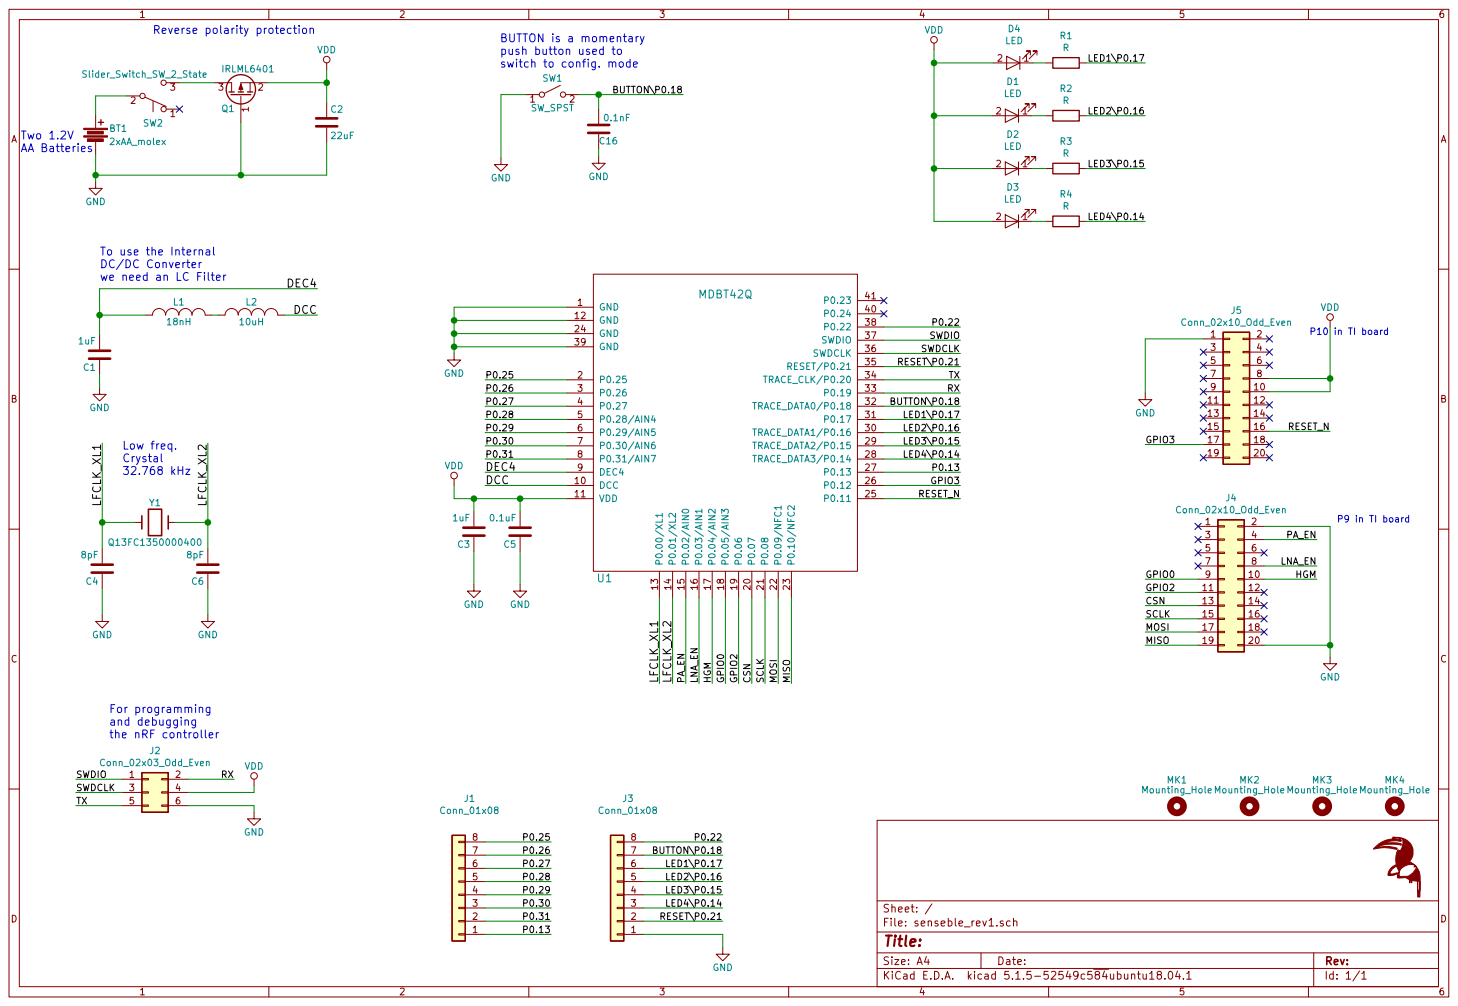
[picture p68: page 1]

VDD GND
switch to config. mode To use the Internal DC/DC Converter

push button used to

we need an LC Filter

DEC4
the nRF controller Low freq.
Crystal 32.768 kHz

MISO MOSI SCLK MISO
