Appiko/sense_snap_hw/senseEle_PCB_Antenna_rev2/Documents/senseEle_PCB_Antenna_rev2.pdf

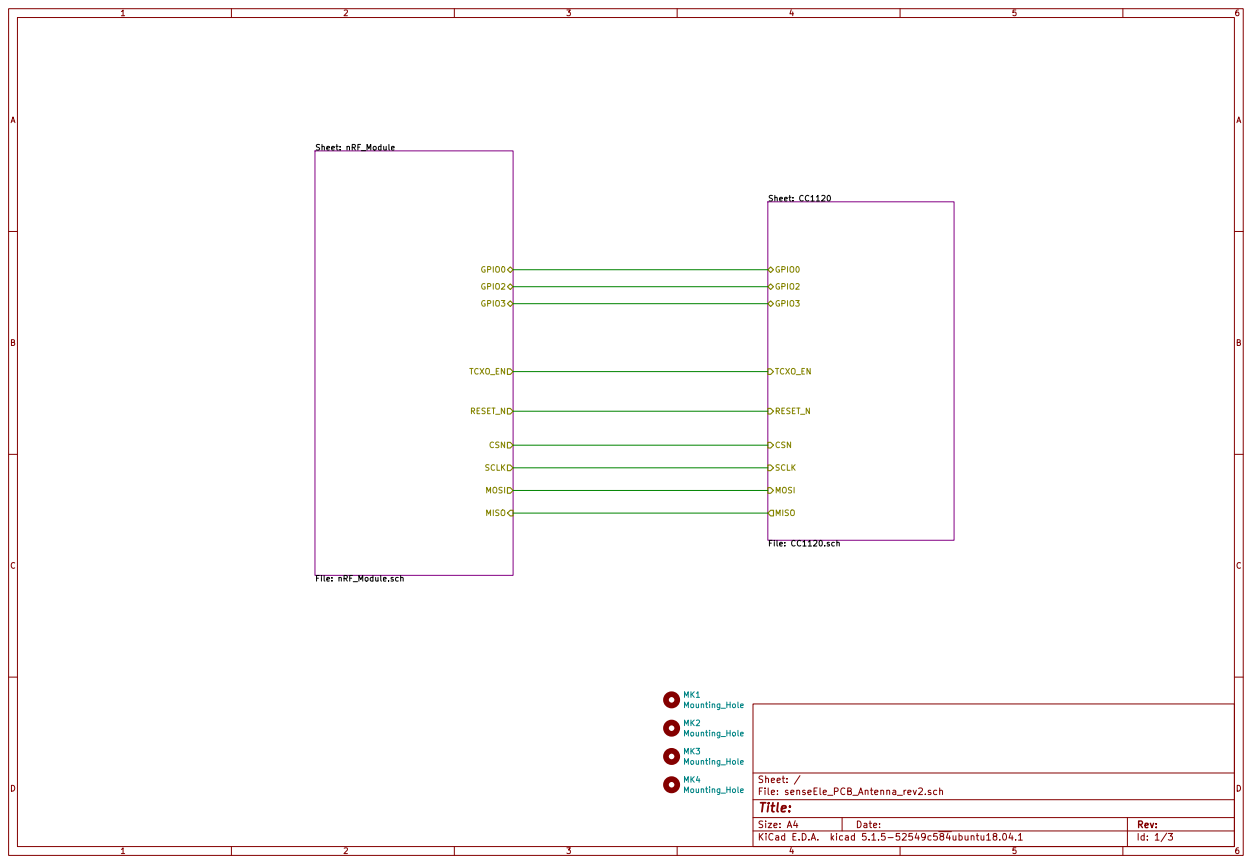
[picture p69: page 1]

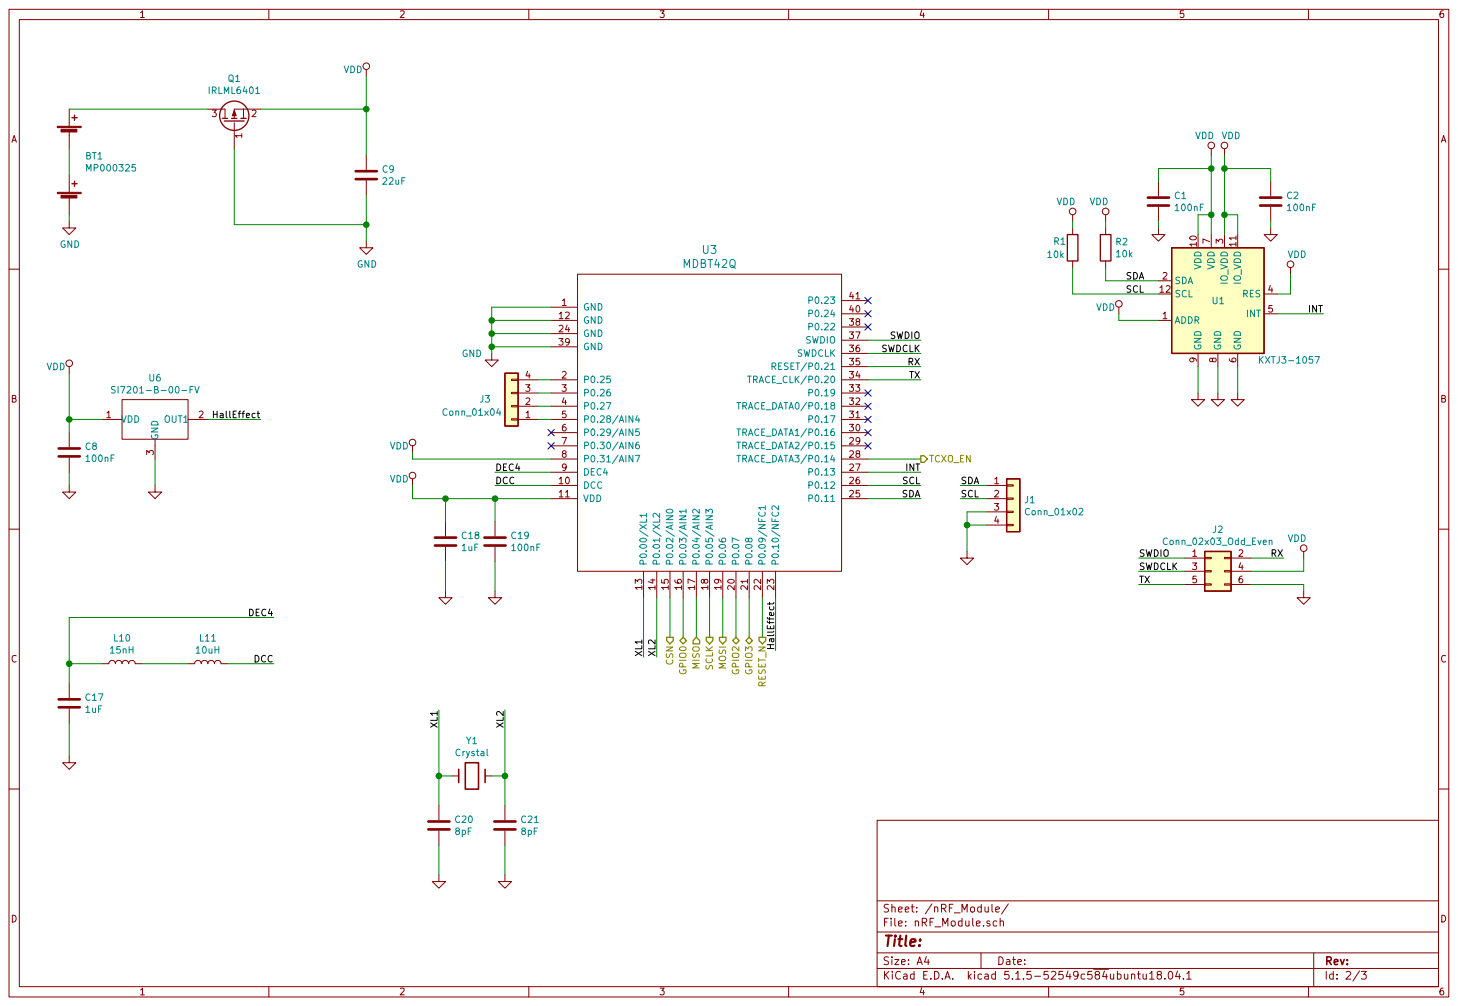
[picture p70: page 2]

3 U6 SI7201-B-00-FV GND 1 DCC 10 VDD 11 GND 12 P0.00/XL1 13 P0.01/XL2 14 P0.02/AIN0 15 P0.03/AIN1 16 P0.04/AIN2 17 P0.05/AIN3 18 P0.06 19 P0.25 2 P0.07 20 P0.08 21 P0.09/NFC1 22 P0.10/NFC2 23 GND 24 P0.11 25 P0.12 26 P0.13 27 TRACE_DATA3/P0.14 28 TRACE_DATA2/P0.15 29 P0.26 3 TRACE_DATA1/P0.16 30 P0.17 31 TRACE_DATA0/P0.18 32 P0.19 33 TRACE_CLK/P0.20 34 RESET/P0.21 35 SWDCLK 36 SWDIO 37 P0.22 38 GND 39 P0.27 4 P0.24 40 P0.23 41 P0.28/AIN4 5 P0.29/AIN5 6 P0.30/AIN6 7 P0.31/AIN7 8 DEC4 9 U3 MDBT42Q

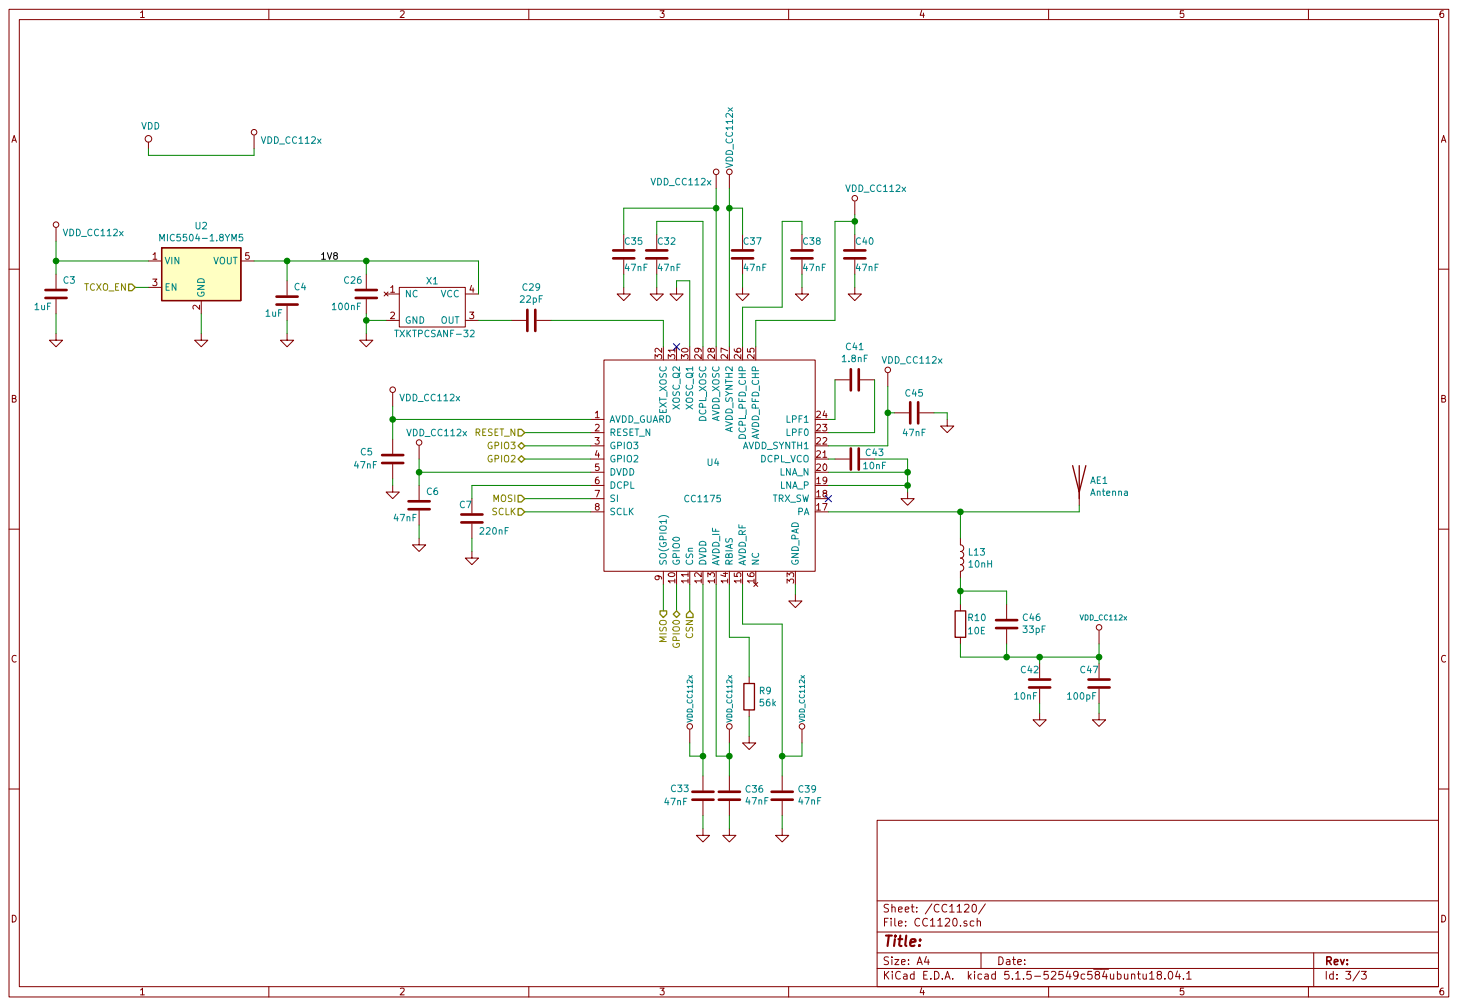
[picture p71: page 3]

2 EN 3 VOUT 5 U2 MIC5504-1.8YM5 AE1 Antenna VDD_CC112x VDD

Id: 3/3 Title: File: CC1120.sch Sheet: /CC1120/ VDD_CC112x C7
