Appiko/sense_snap_hw/SenseCam_rev1/Documents/SenseCam_rev1.pdf

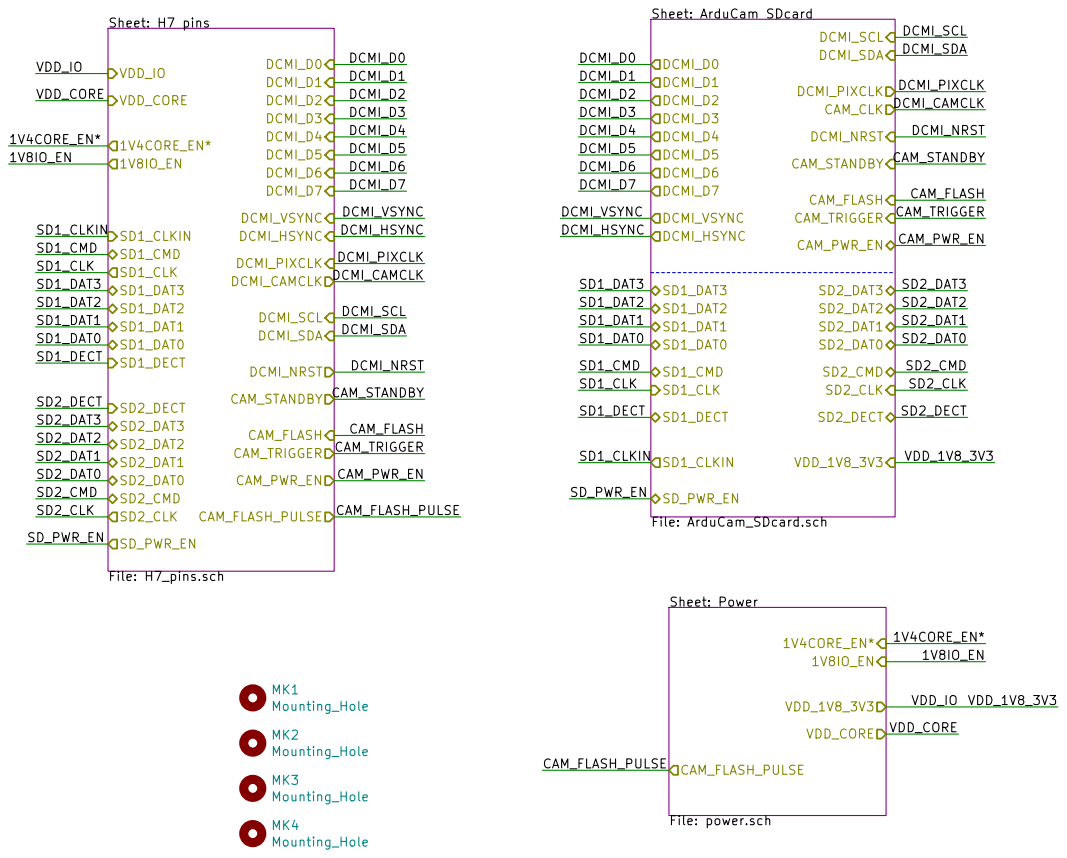
[picture p72: page 1]

SD1_CLKIN
Sheet: Power File: power.sch

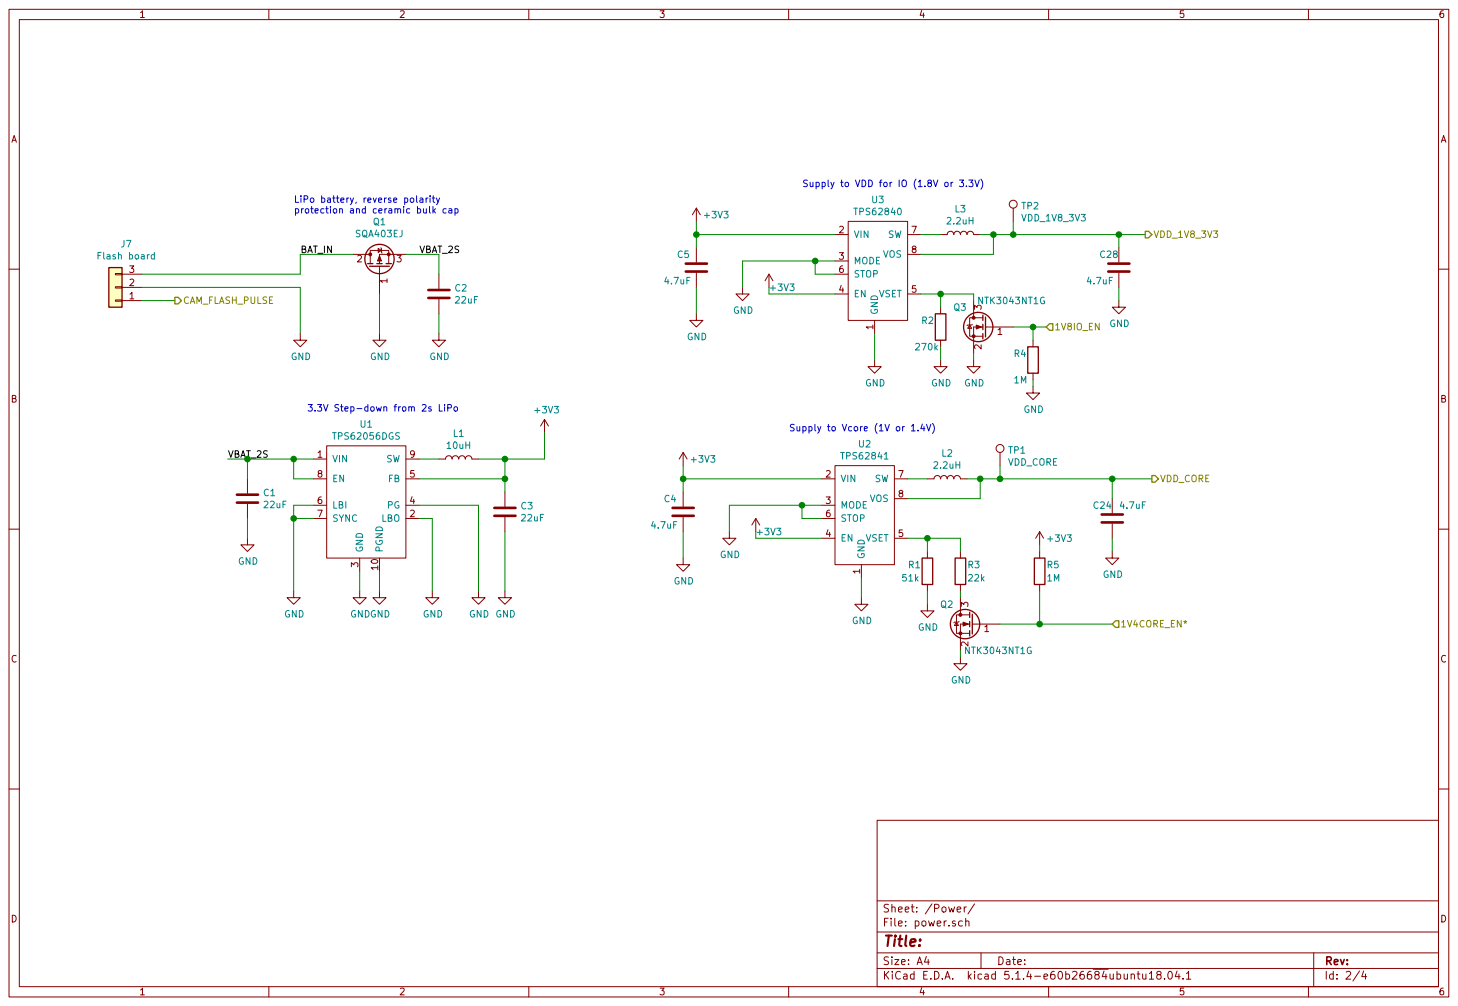
[picture p73: page 2]

Supply to VDD for IO (1.8V or 3.3V)

LiPo battery, reverse polarity
protection and ceramic bulk cap

1 VIN 2 MODE 3 EN 4 VSET 5 STOP 6 SW 7 VOS 8 U3 TPS62840 L3

1 VIN 2 MODE 3 EN 4 VSET 5 STOP 6 SW 7 VOS 8 U2 TPS62841 +3V3 GND

3.3V Step-down from 2s LiPo

Supply to Vcore (1V or 1.4V)

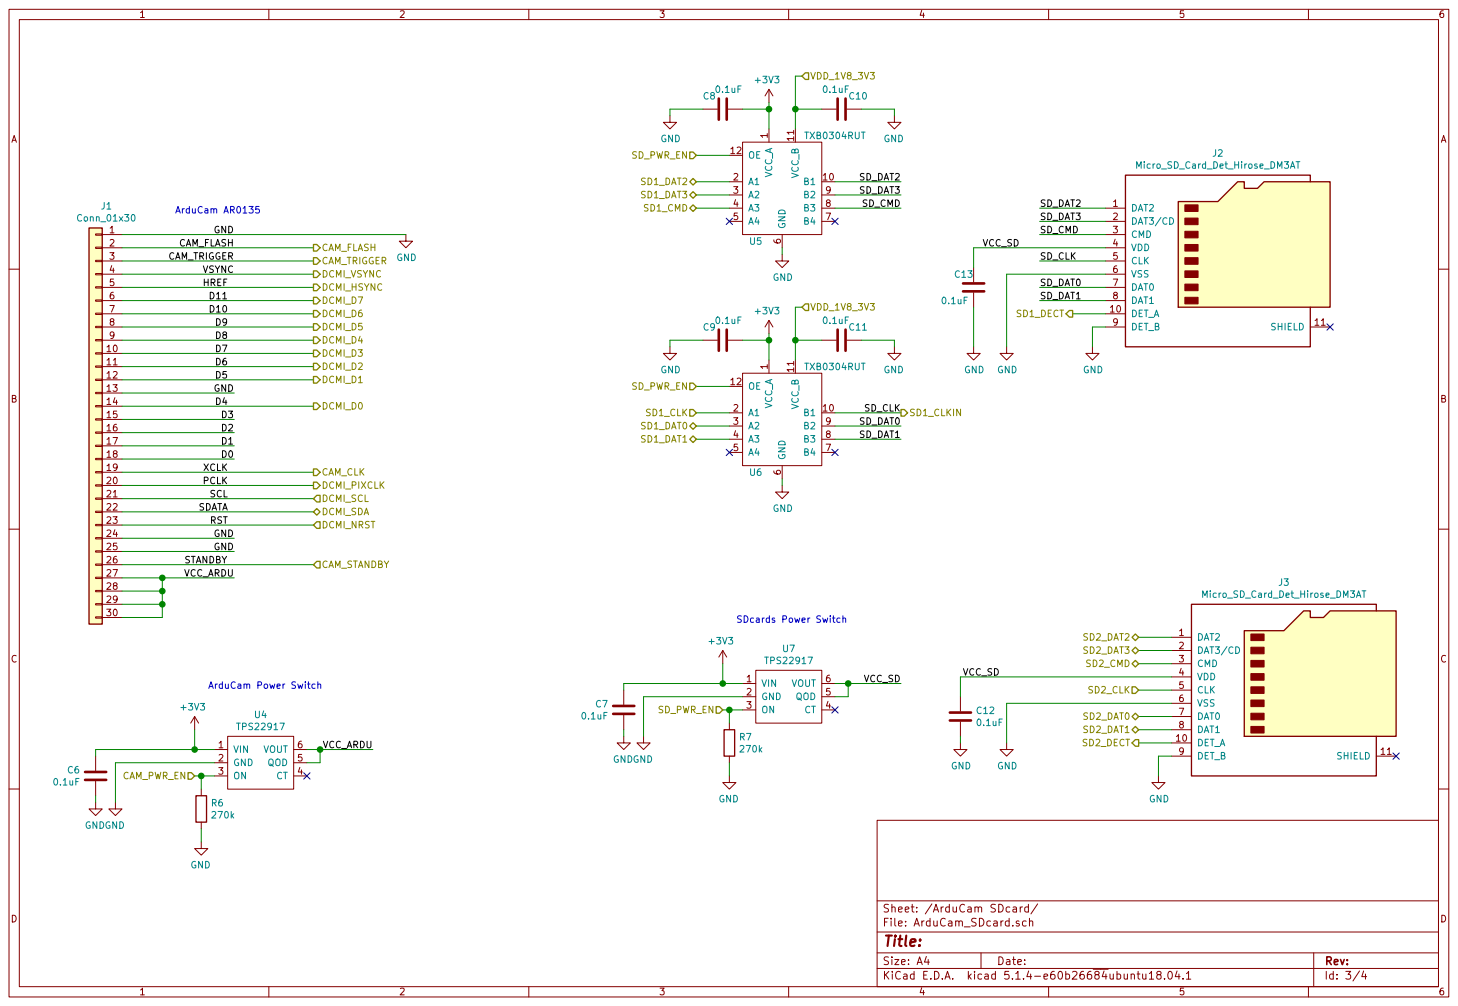
[picture p74: page 3]

1 A2 3 A3 4 B1 VCC_B 10 11 OE 12 A4 5 B4 7 B3 8 B2 9 U5 TXB0304RUT GND
D6 CAM_FLASH
VSYNC
HREF D11 D10 SCL SDATA RST GND GND

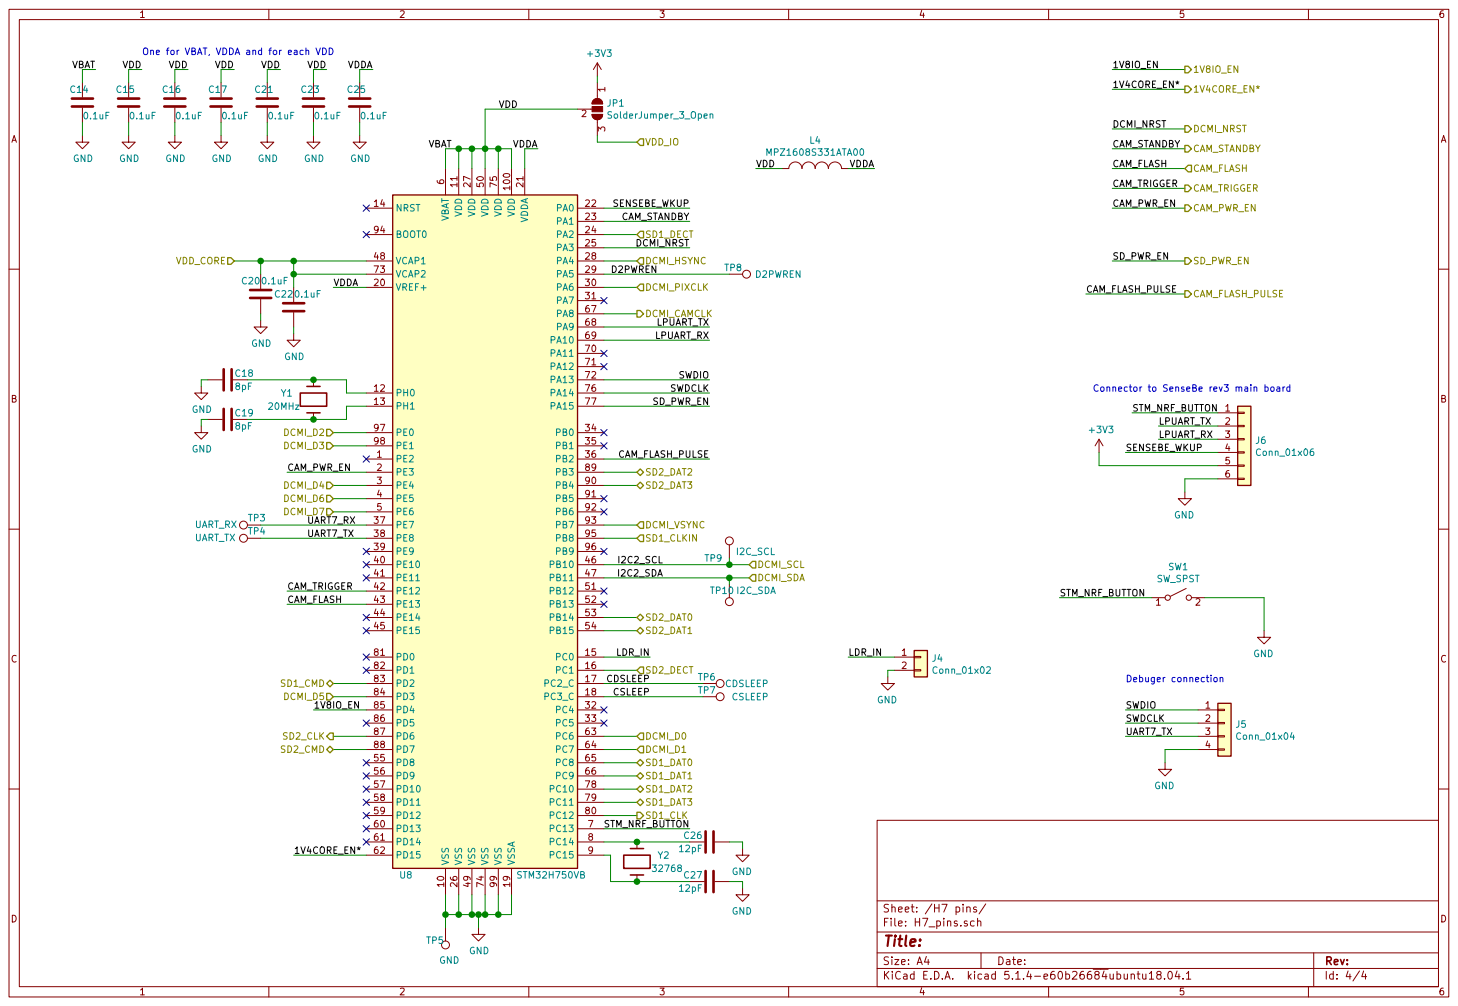
[picture p75: page 4]
