Appiko/sense_snap_hw/senseCam_Adapter_rev1/Documents/senseCam_Adapter_rev1.pdf

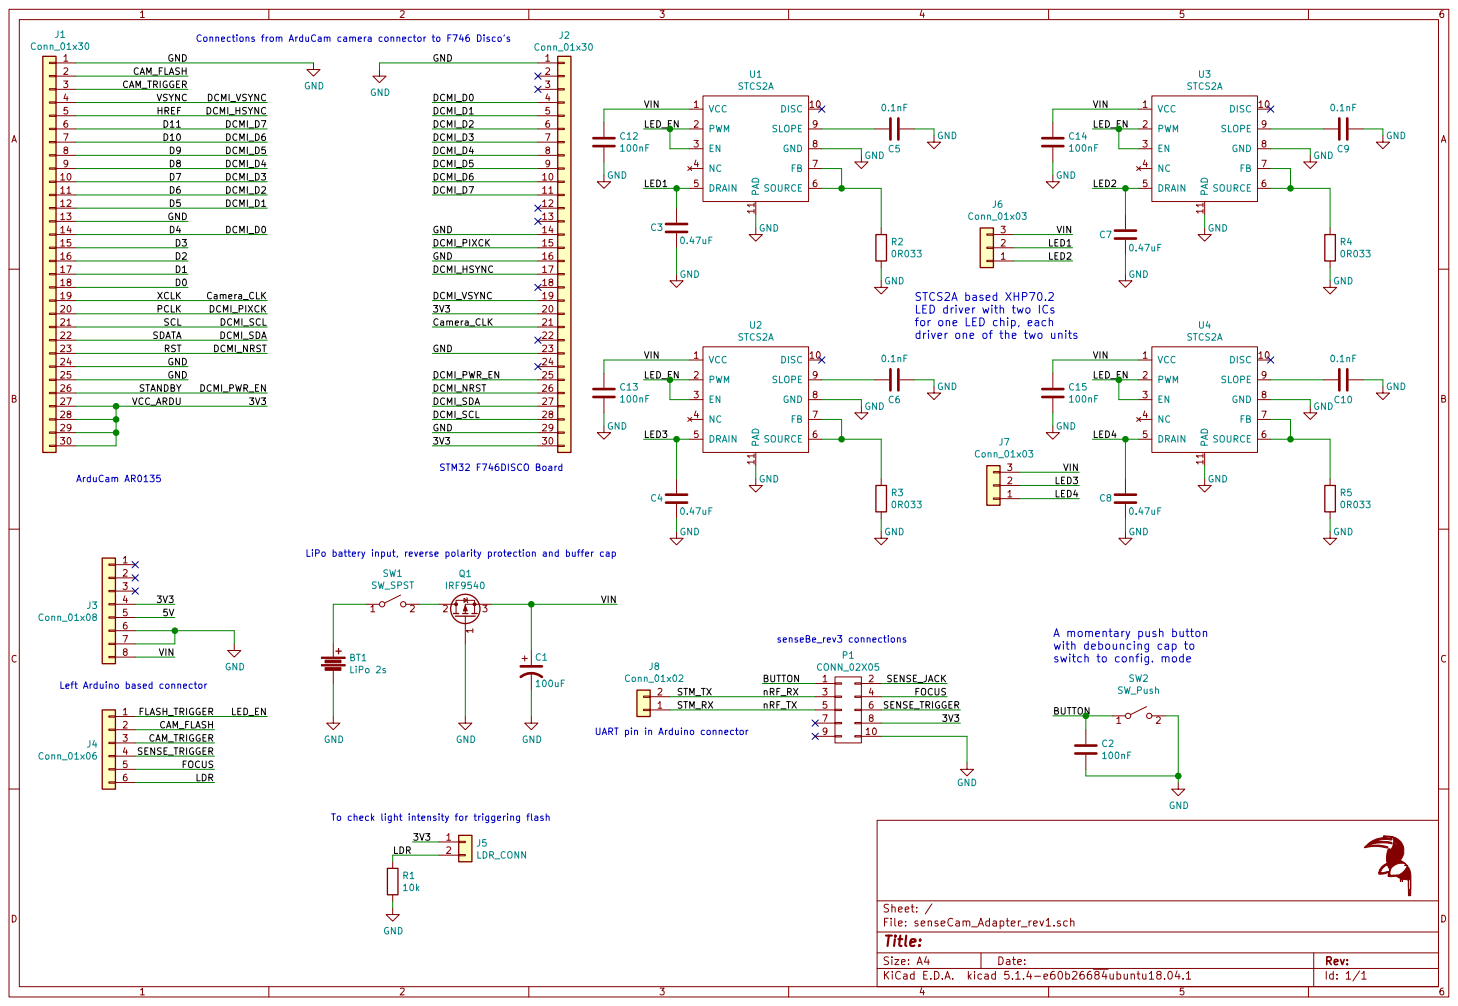
[picture p76: page 1]

Connections from ArduCam camera connector to F746 Disco's
DCMI_PIXCK DCMI_D7 DCMI_D6 DCMI_D5 DCMI_D4 DCMI_D3 DCMI_D2 DCMI_D1 DCMI_D0

STCS2A based XHP70.2
LED driver with two ICs
for one LED chip, each

XCLK
PCLK
SCL SDATA RST GND GND

LiPo battery input, reverse polarity protection and buffer cap

with debouncing cap to
switch to config. mode

UART pin in Arduino connector
