Appiko/sense_snap_hw/XHP70.2_breakout_rev2/Documents/XHP70.2_breakout_rev2.pdf

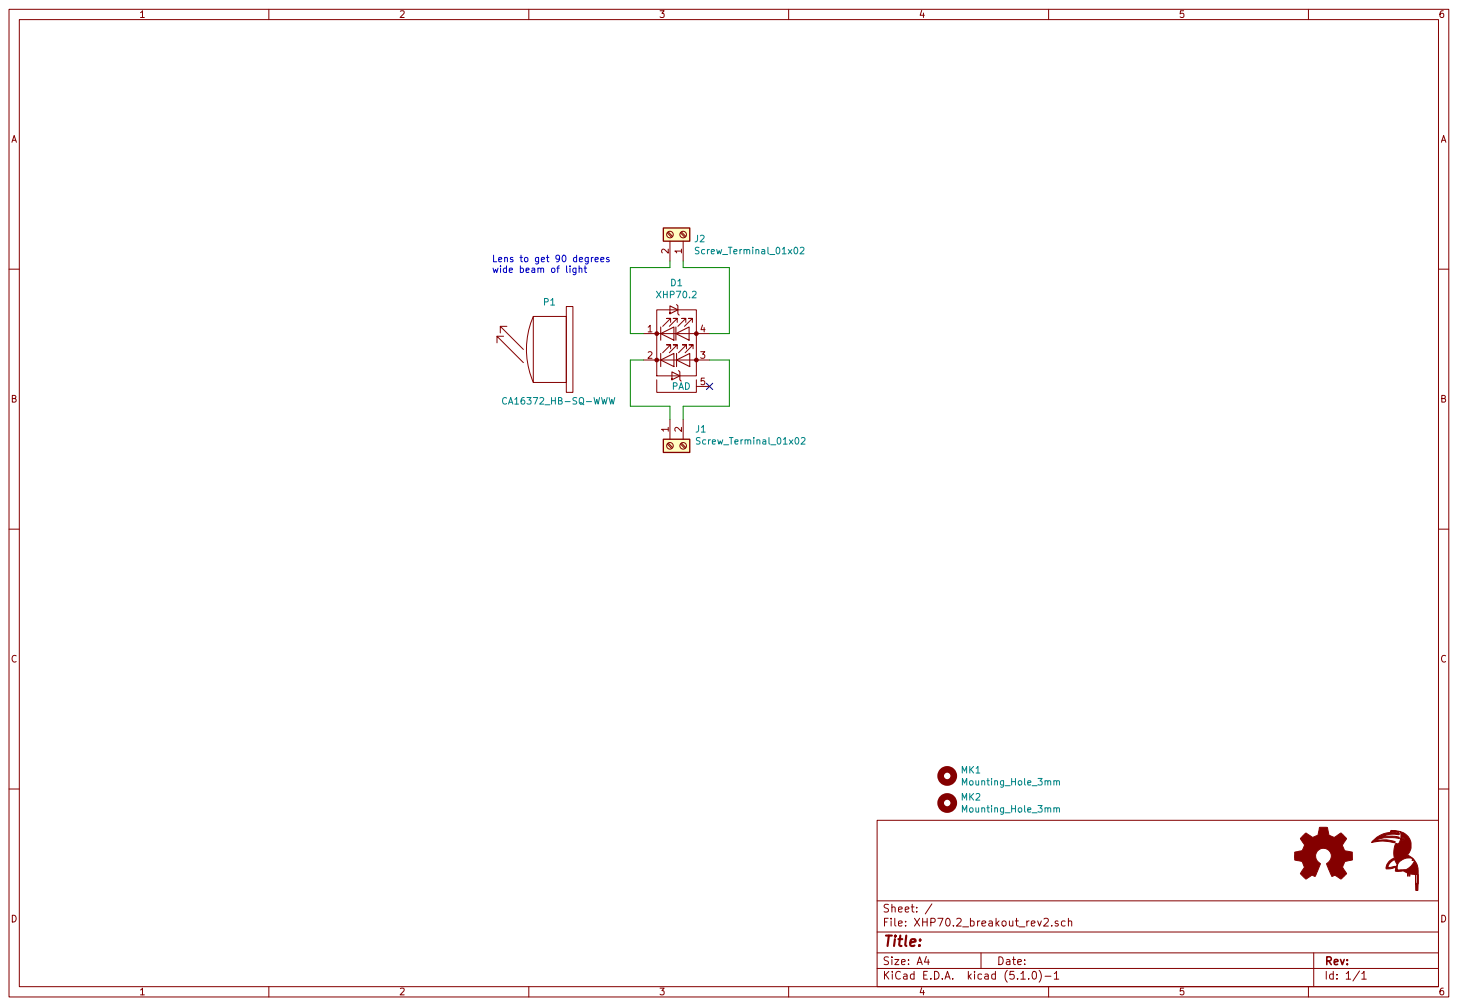
[picture p77: page 1]

Lens to get 90 degrees
wide beam of light
