Appiko/sense_snap_hw/AR0135_STM32F746G-DISCO_adapter_rev1/Documents/AR0135_STM32F746G-DISCO_adapter_rev1.pdf

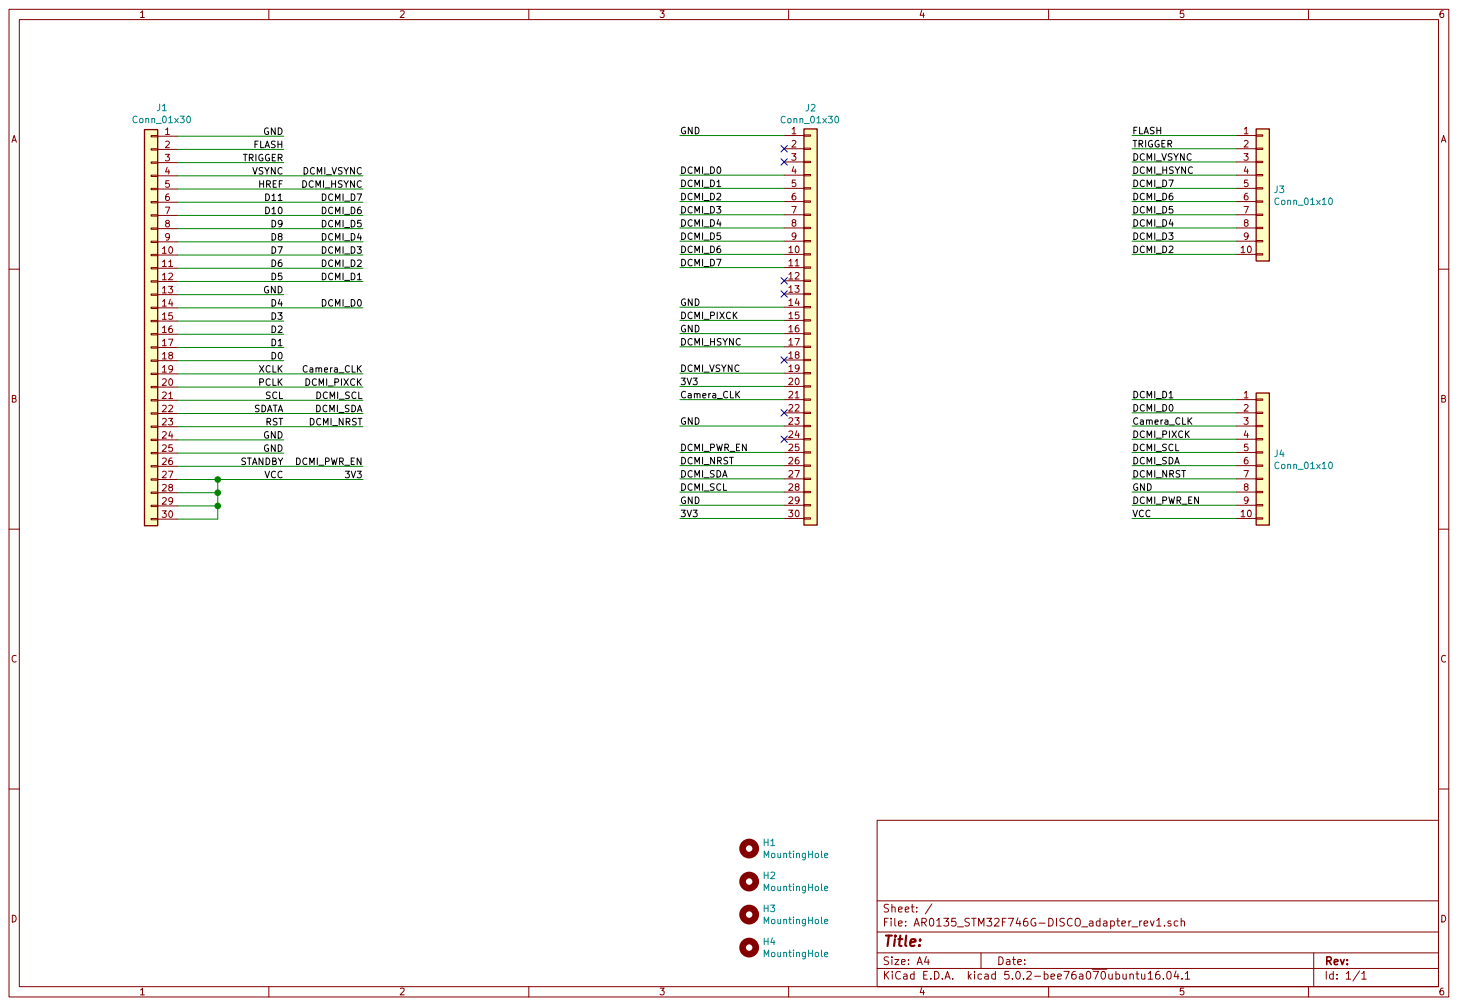
[picture p78: page 1]

PCLK
SCL SDATA RST GND GND
