Appiko/sense_snap_hw/senseBeTx_rev3/Documents/senseBeTx_rev3.pdf

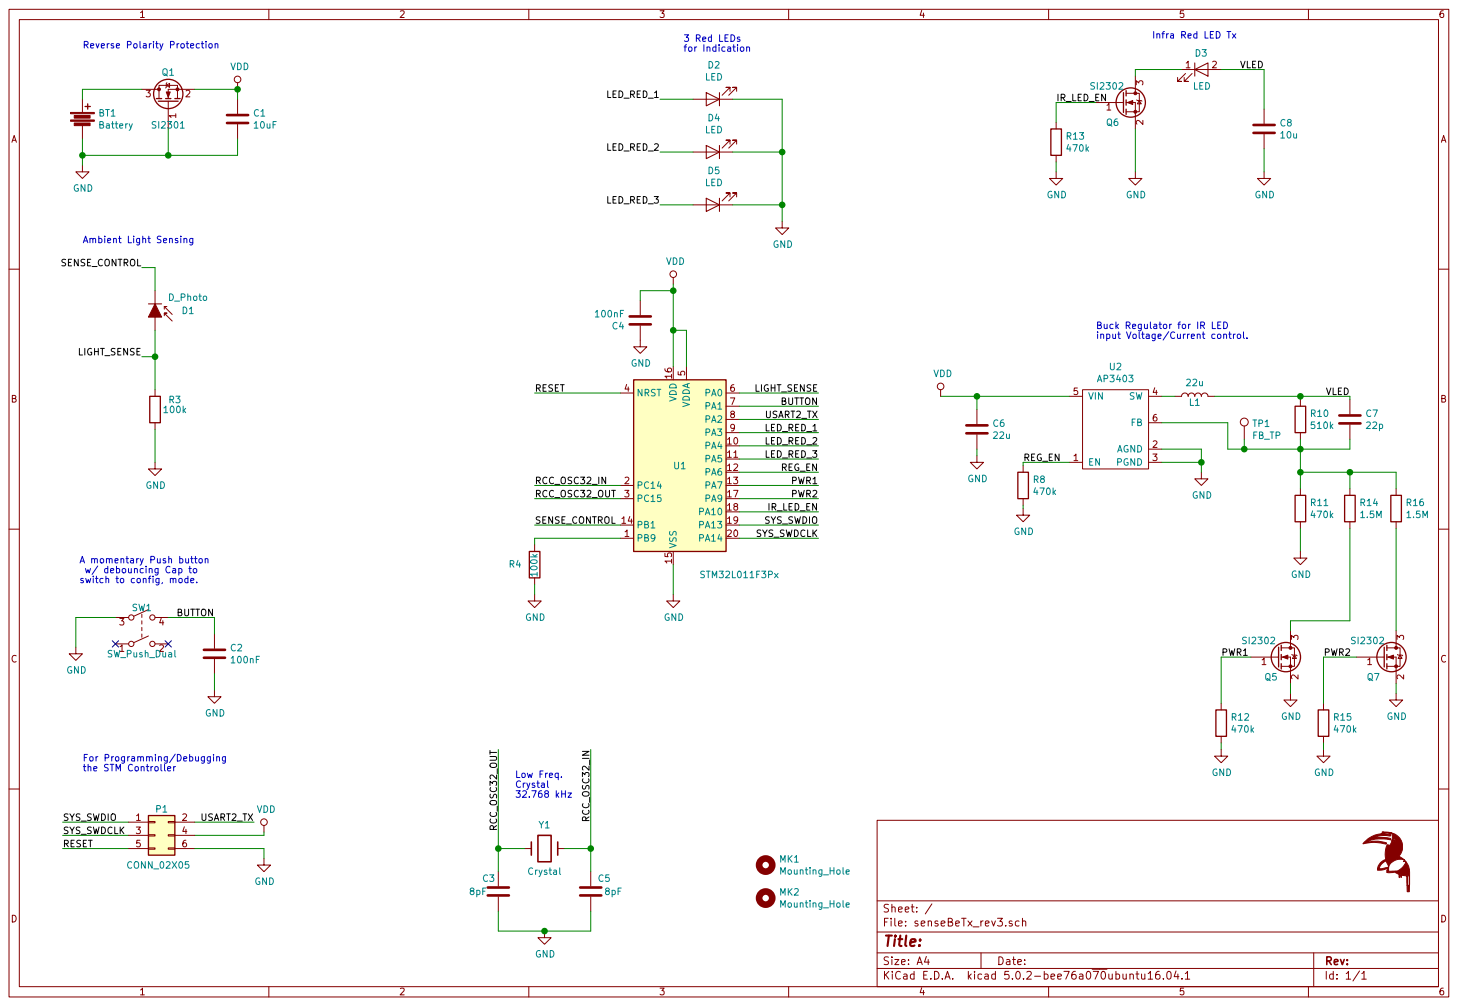
[picture p79: page 1]

Infra Red LED Tx BUTTON

Buck Regulator for IR LED
input Voltage/Current control.

A momentary Push button
w/ debouncing Cap to
switch to config, mode.
