Appiko/sense_snap_hw/snap_rev3/pdf/snap_rev3.pdf

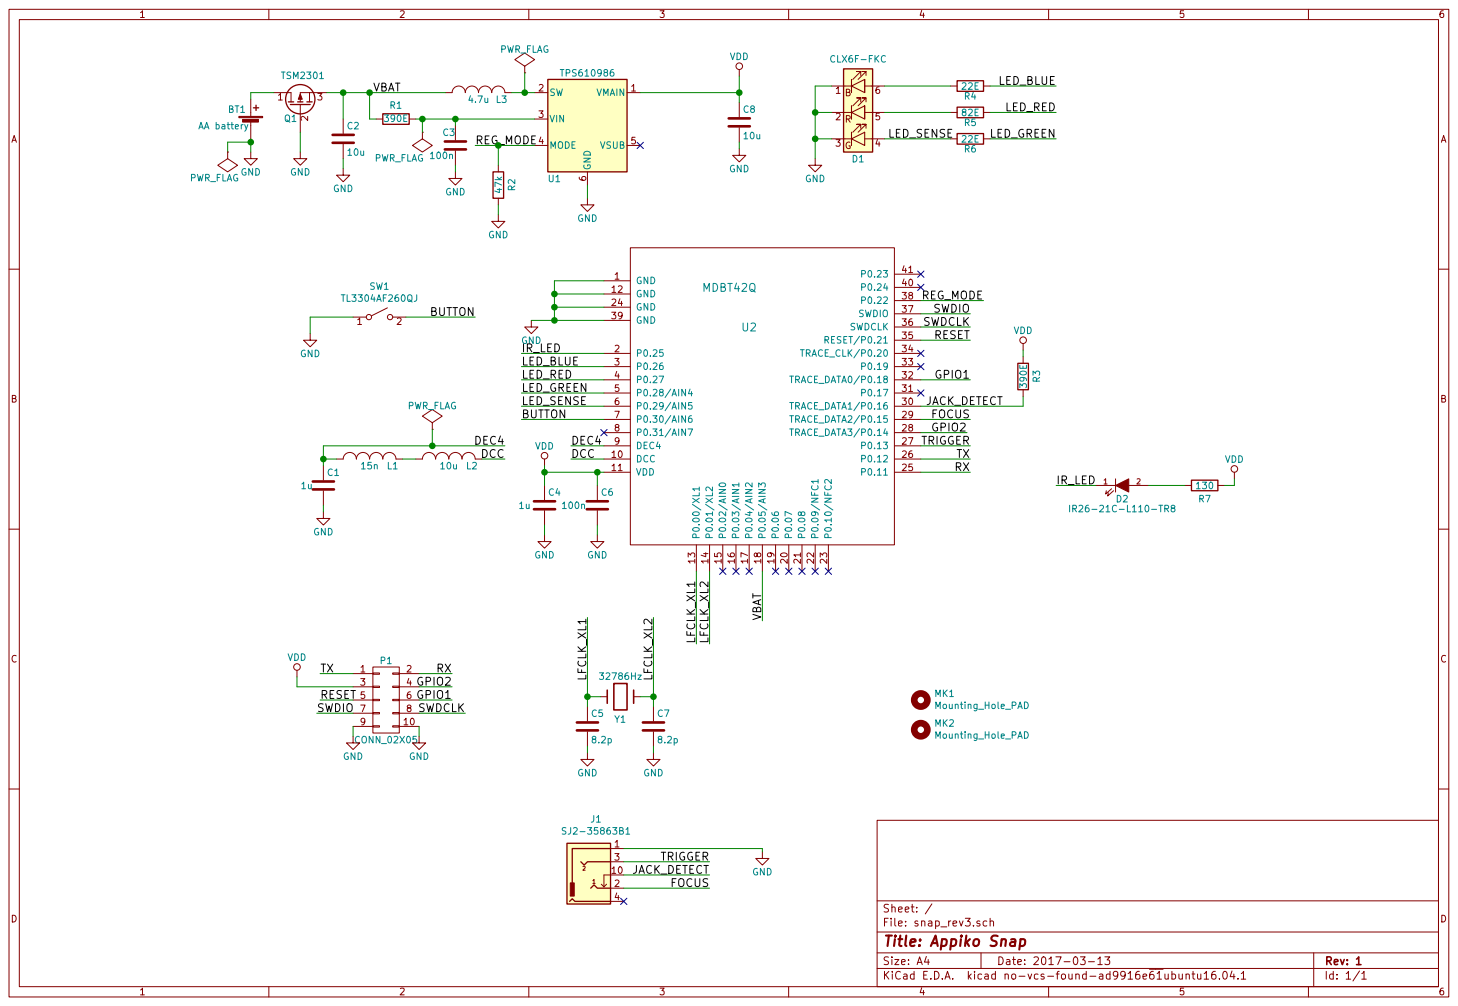
[picture p80: page 1]

LED_RED
LED_GREEN
LED_SENSE

TRIGGER
JACK_DETECT

File: snap_rev3.sch Sheet: /
Id: 1/1 Title: Appiko Snap
