Appiko/sense_snap_hw/detect_rev1/output/detect_rev1.pdf

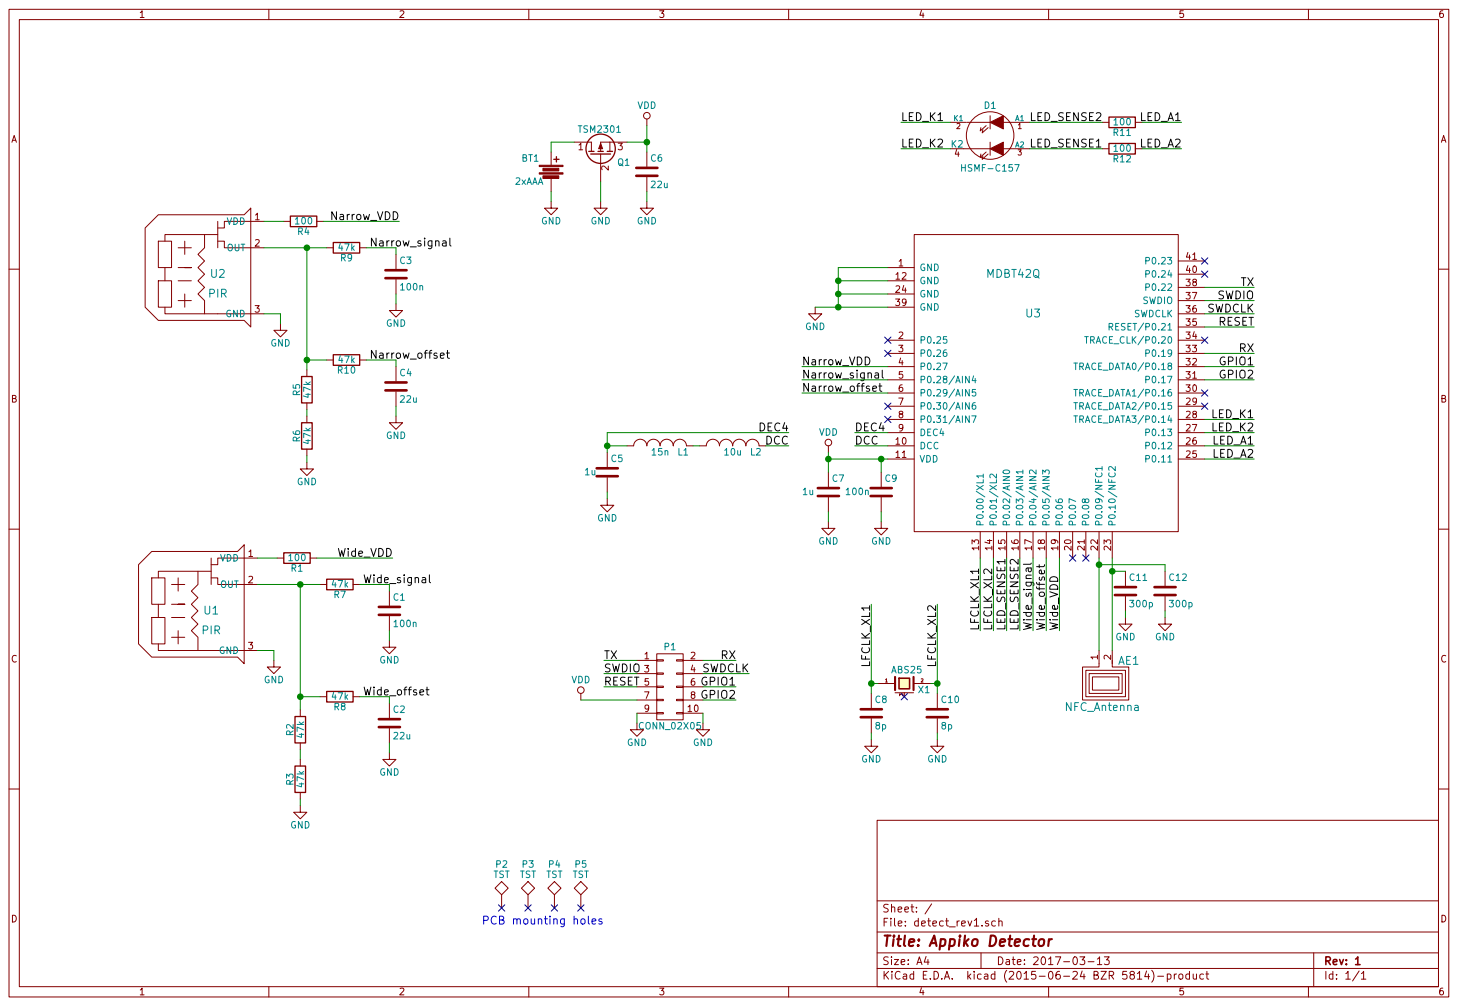
[picture p81: page 1]

3Q1 TSM2301 GND R5 47k GND R2 47k R6 47k GND R3 47k
VDD 1 OUT 2 GND 3 U2 PIR
22u GND Narrow_signal

3X1 ABS25 P2 TST P3 TST P4 TST P5 TST PCB mounting holes

File: detect_rev1.sch Sheet: /
Id: 1/1 Title: Appiko Detector
