Appiko/sense_snap_hw/senseBe_rev4/senseBe_rev4_main/Documents/senseBe_rev4_main.pdf

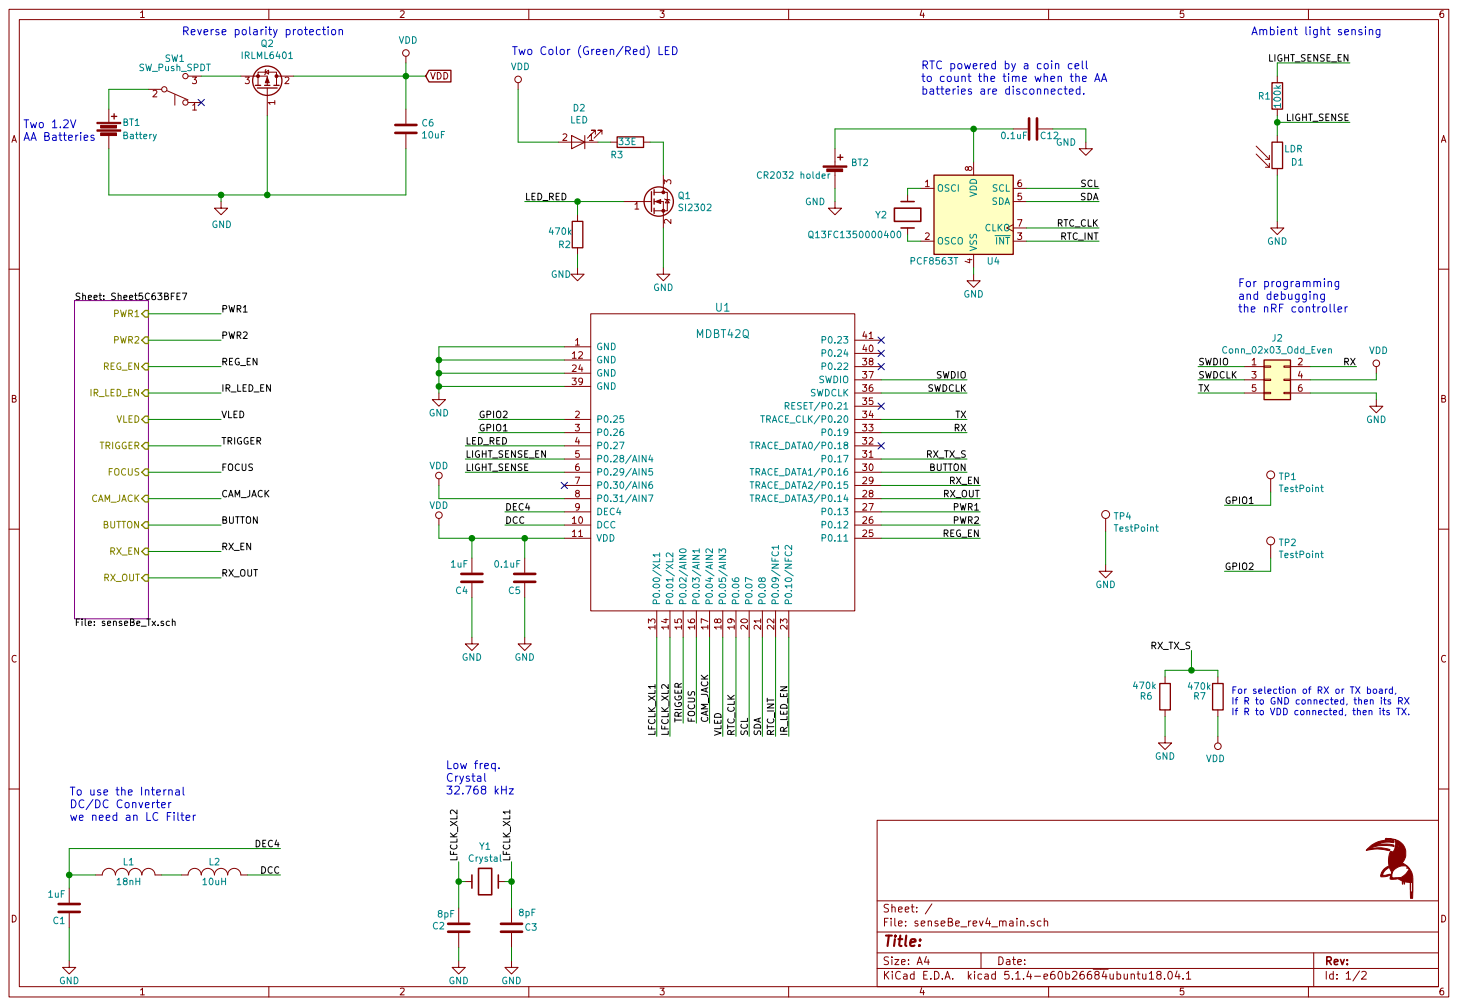
[picture p82: page 1]

Two Color (Green/Red) LED

RTC powered by a coin cell to count the time when the AA

Sheet: Sheet5C63BFE7 File: senseBe_Tx.sch PWR1 PWR2 REG_EN
the nRF controller To use the Internal DC/DC Converter

4 SDA 5 SCL 6 CLKO 7 VDD

If R to GND connected, then its RX
If R to VDD connected, then its TX.

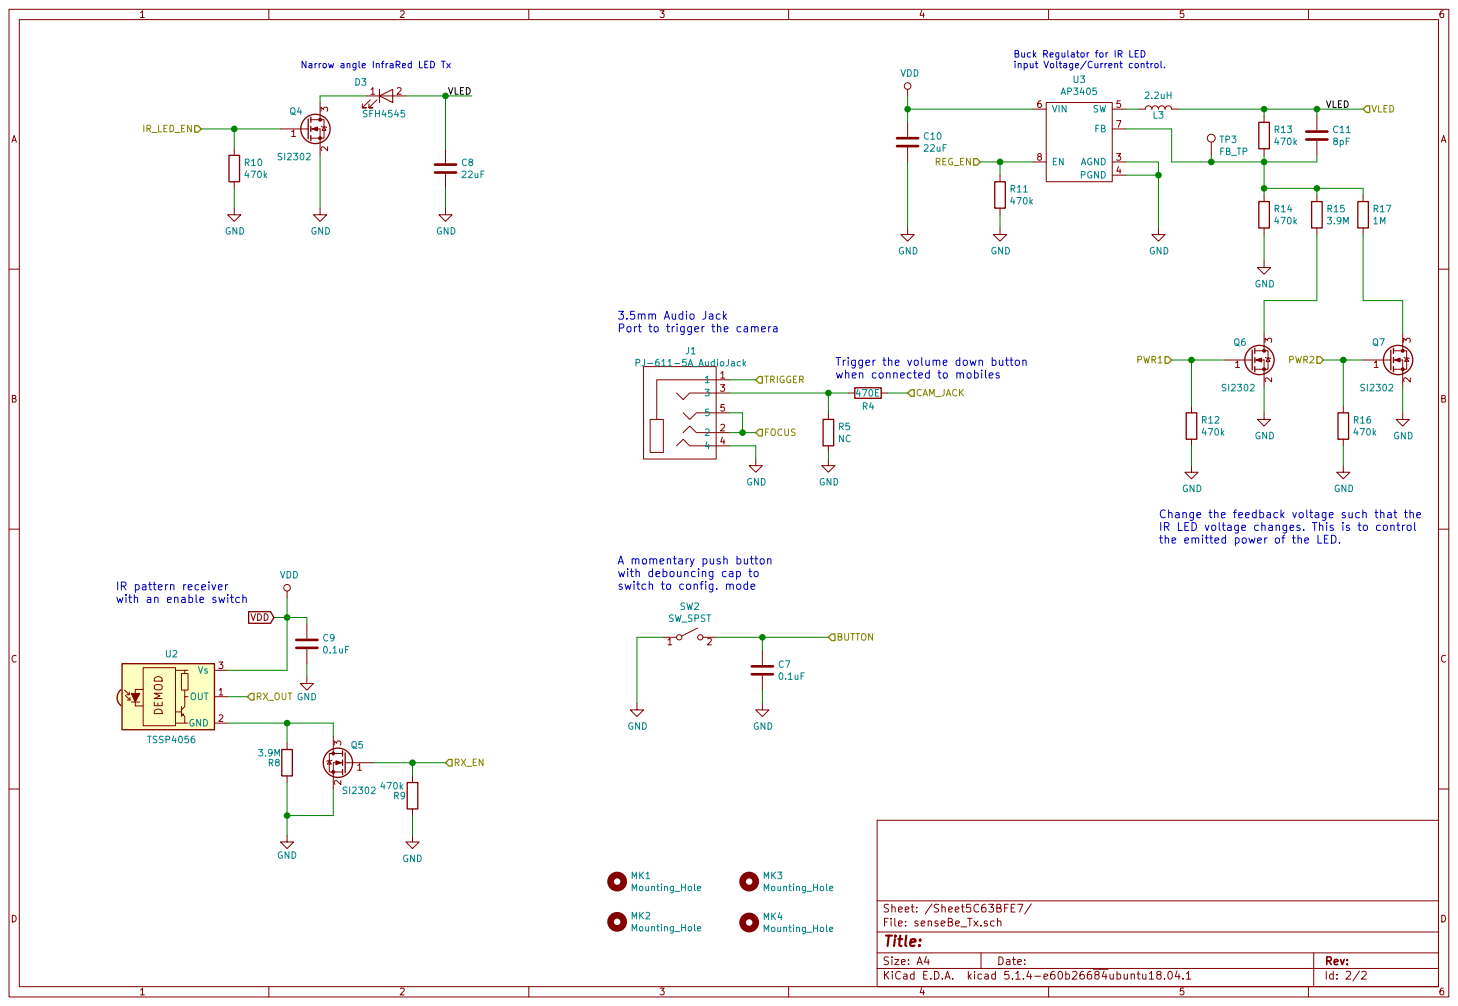
[picture p83: page 2]

Buck Regulator for IR LED
input Voltage/Current control.

Narrow angle InfraRed LED Tx

2 Q7 3 SI2302 AGND 3 PGND 4 SW 5 VIN 6 FB 7 EN 8 U3 AP3405 R11

Trigger the volume down button when connected to mobiles 3.5mm Audio Jack Port to trigger the camera

Change the feedback voltage such that the
IR LED voltage changes. This is to control
the emitted power of the LED.

with debouncing cap to
switch to config. mode
