Appiko/sense_snap_hw/sense_rev5/SensePi_rev5_main/Documents/SensePi_rev5_main.pdf

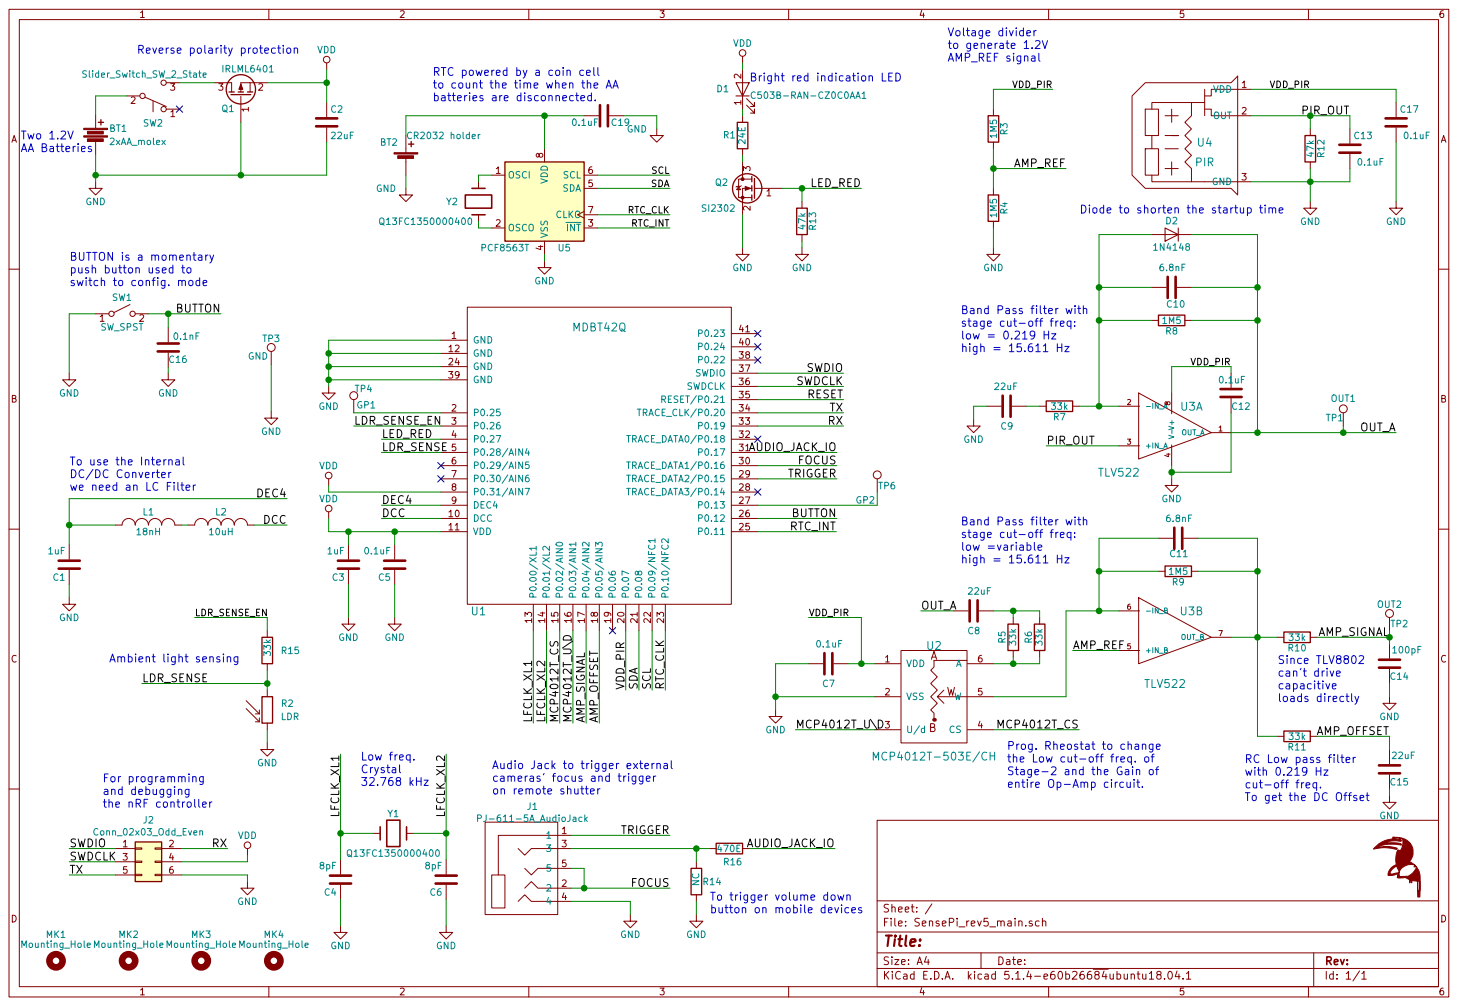
[picture p84: page 1]

RTC powered by a coin cell to count the time when the AA

Bright red indication LED
VDD_PIR AUDIO_JACK_IO

entire Op-Amp circuit. Band Pass filter with stage cut-off freq:

Two 1.2V AA BatteriesBUTTON is a momentary

4 SDA 5 SCL 6 CLKO 7 VDD

AMP_REF
low = 0.219 Hz high = 15.611 Hz Band Pass filter with stage cut-off freq:

Diode to shorten the startup time

push button used to
switch to config. mode

LDR_SENSE_EN
LED_RED
LDR_SENSE

we need an LC Filter

MCP4012T_CS
Prog. Rheostat to change
the Low cut-off freq. of
Stage-2 and the Gain of

RC Low pass filter with 0.219 Hz cut-off freq.

To trigger volume down button on mobile devices Audio Jack to trigger external
cameras' focus and trigger on remote shutter

To get the DC Offset
