Appiko/sense_snap_hw/Ap3403_LED_test/Documents/Ap3403_LED_test.pdf

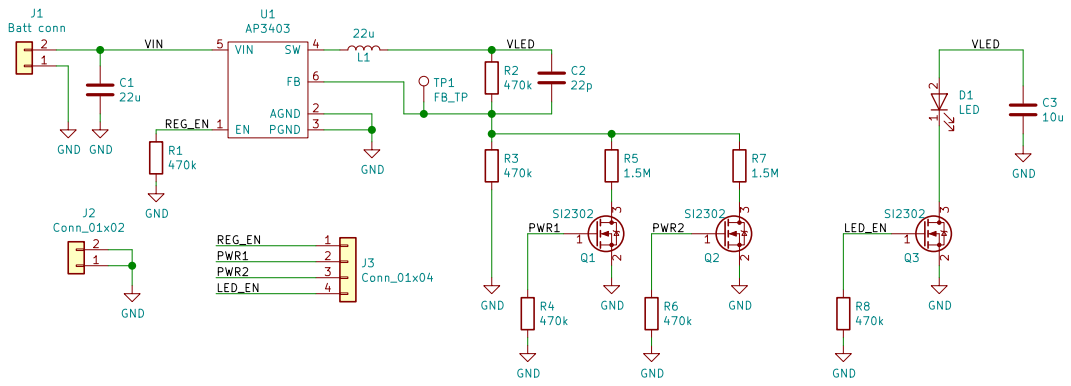
[picture p85: page 1]
