Appiko/sense_snap_hw/SenseEle_GPS_adapter/Documents/SenseEle_GPS_adapter.pdf

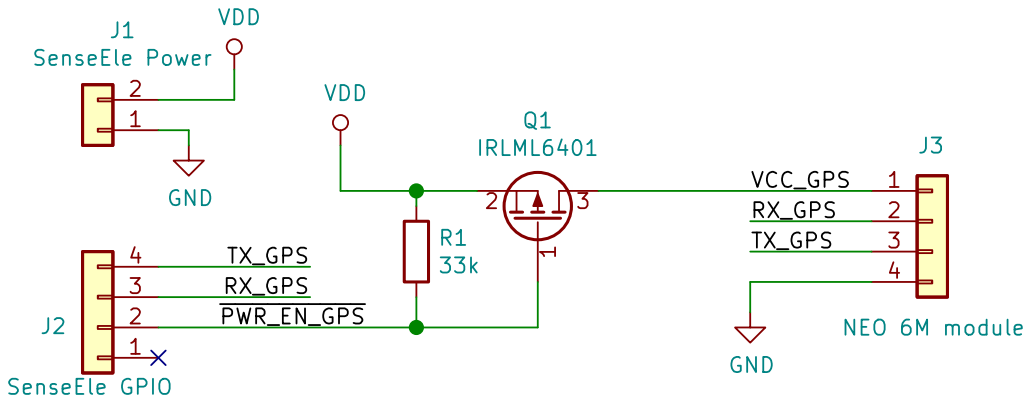
[picture p86: page 1]
