Appiko/sense_snap_hw/senseEle_SMA_rev1/Documents/senseEle_PCB_Antenna_rev1.pdf

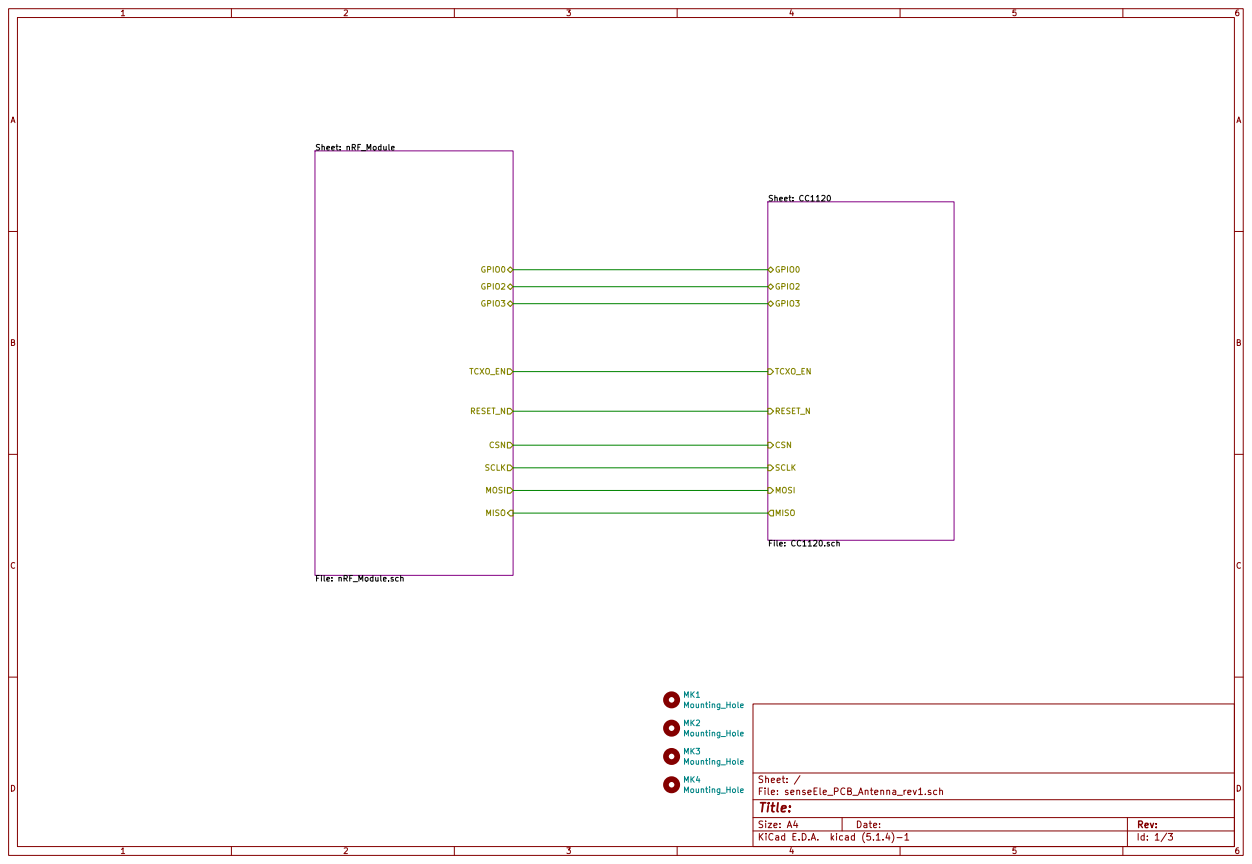
[picture p87: page 1]

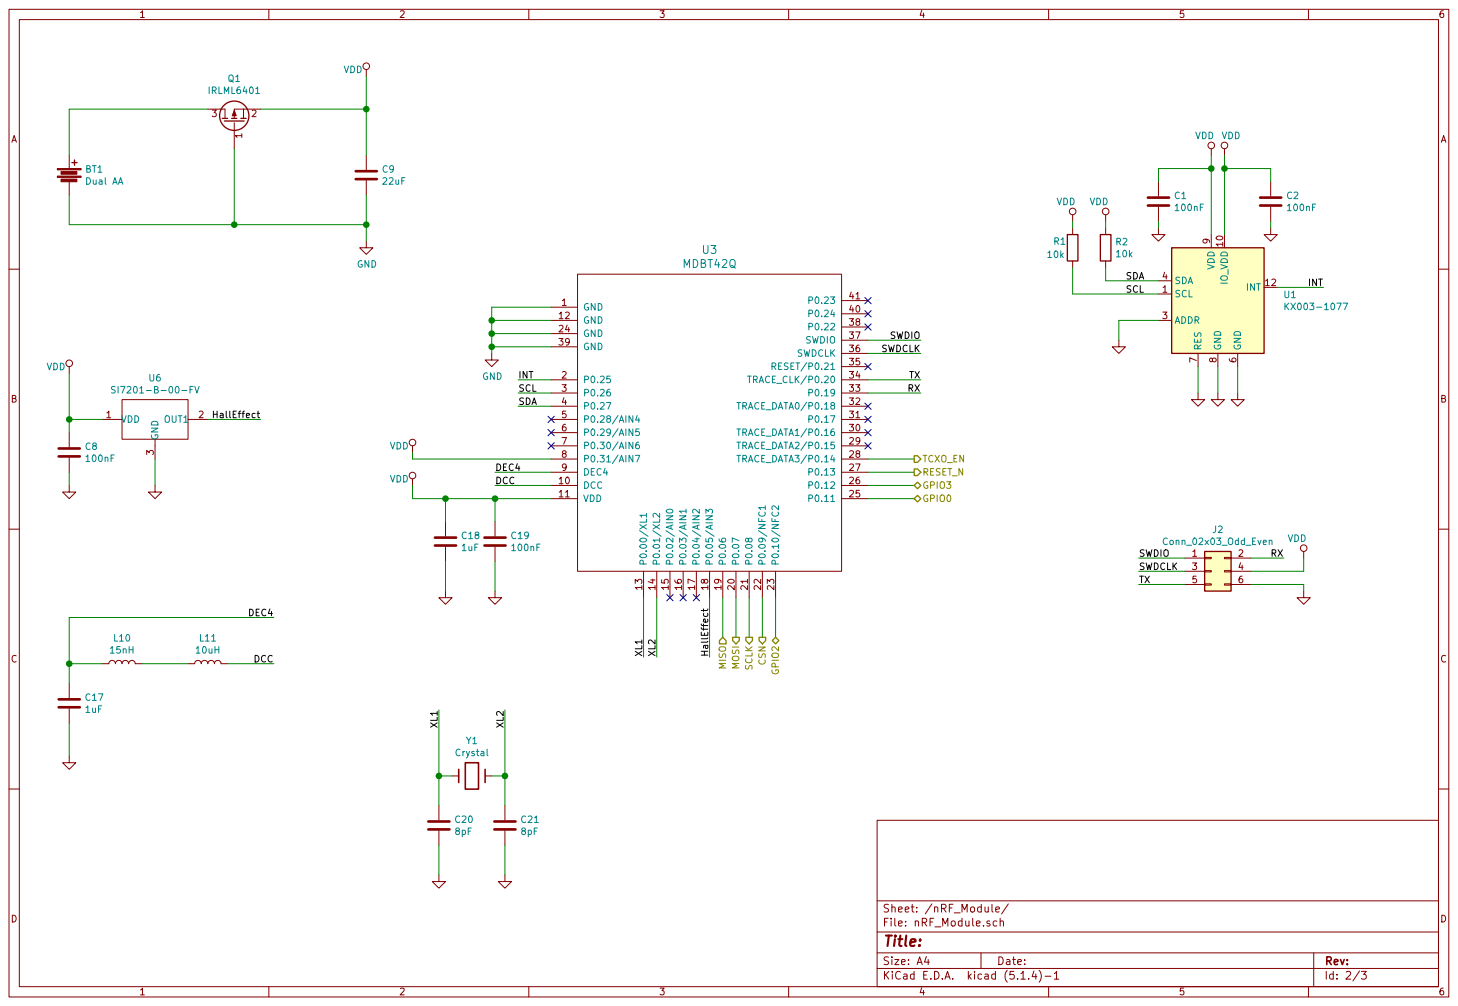
[picture p88: page 2]

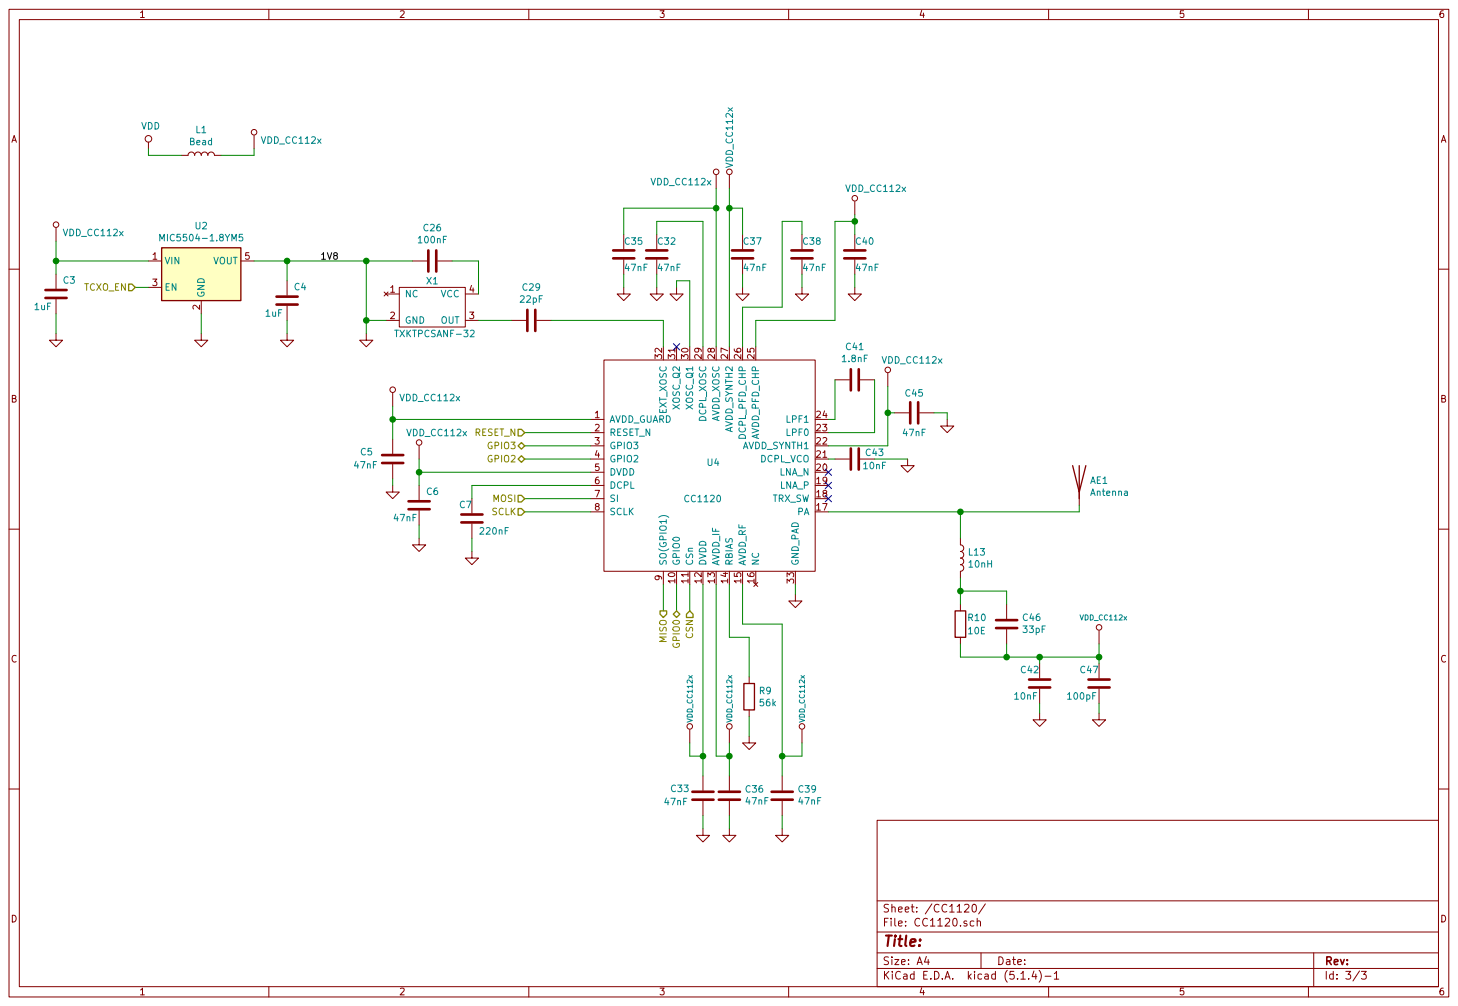
[picture p89: page 3]

Id: 3/3 Title: File: CC1120.sch Sheet: /CC1120/
