Appiko/sense_snap_hw/SenseCam_SFH4715AS_rev1/Documents/SenseCam_SFH4715AS_rev1.pdf

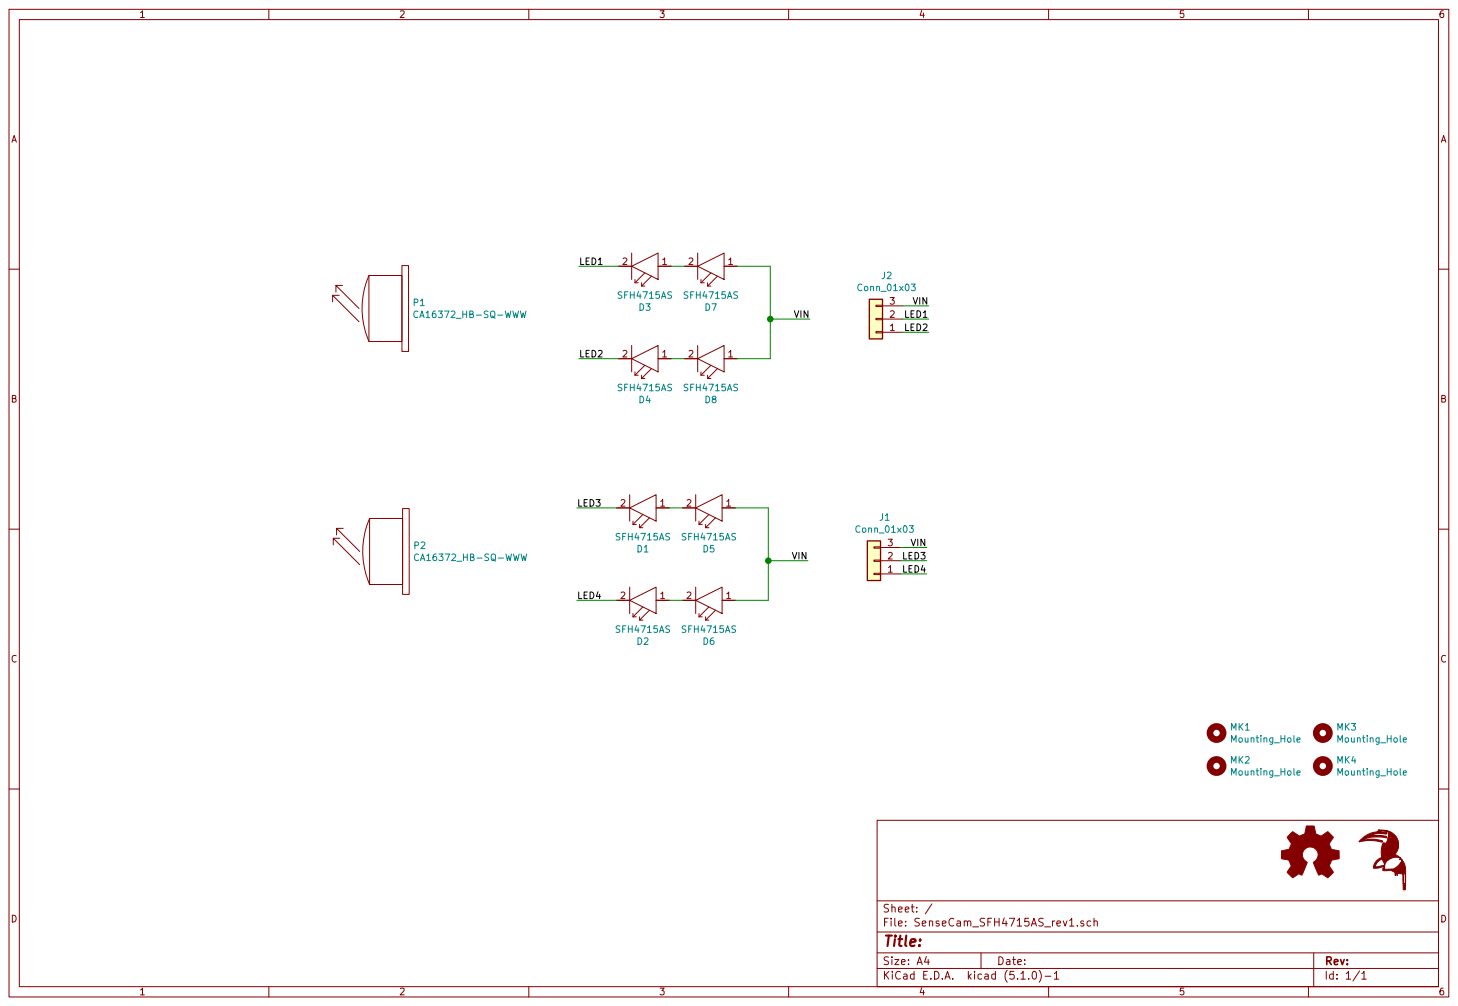
[picture p90: page 1]
