Appiko/sense_snap_hw/SFH4715AS_breakout/Documents/SFH4715AS_breakout.pdf

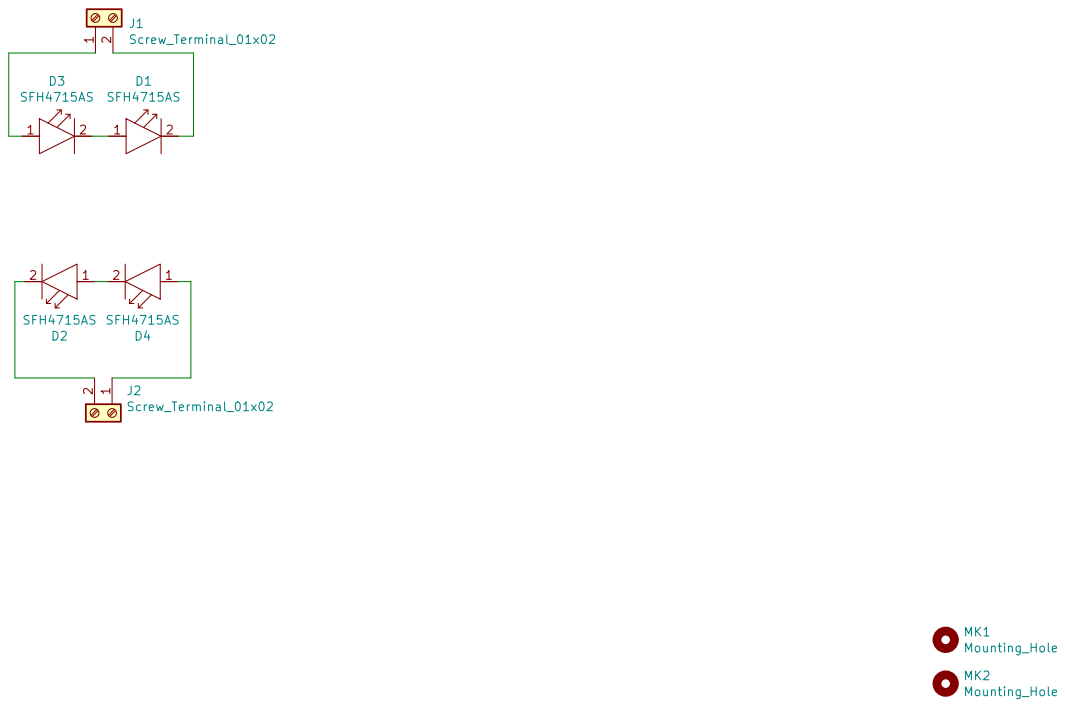
[picture p91: page 1]
