Appiko/sense_snap_hw/AR0135_OpenMV_adapter_rev1/Documents/AR0135_OpenMV_adapter_rev1.pdf

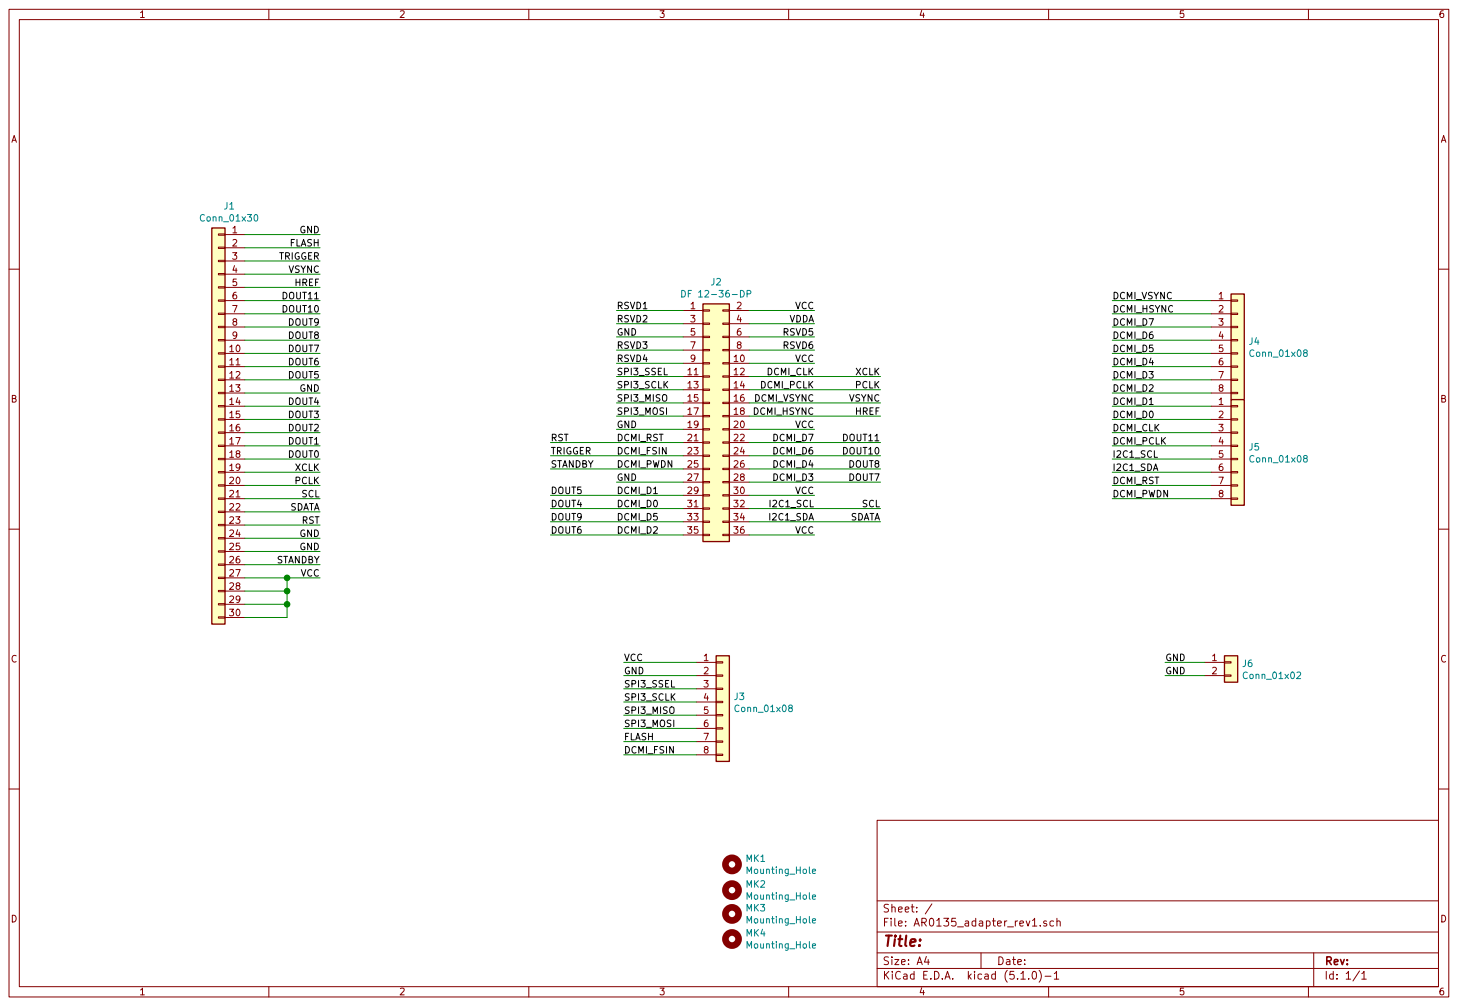
[picture p92: page 1]

RST SCL XCLK DOUT1 VCC
