Appiko/sense_snap_hw/snap_rev3/pdf/snap_rev3-B.Cu.pdf

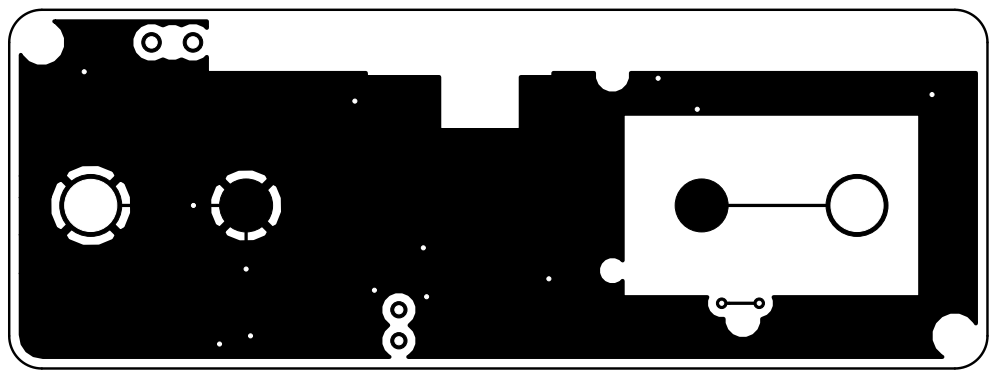
[picture p93: page 1]
