Appiko/sense_snap_hw/snap_rev3/pdf/snap_rev3-B.SilkS.pdf

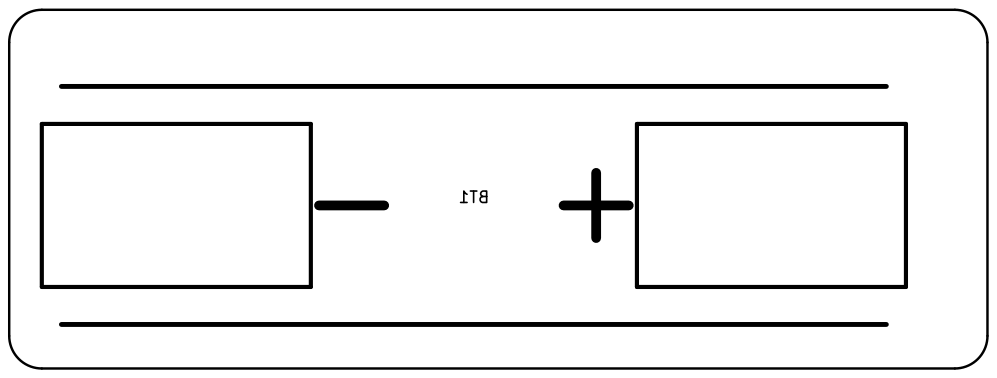
[picture p94: page 1]
