Appiko/sense_snap_hw/snap_rev3/pdf/snap_rev3-Dwgs.User.pdf

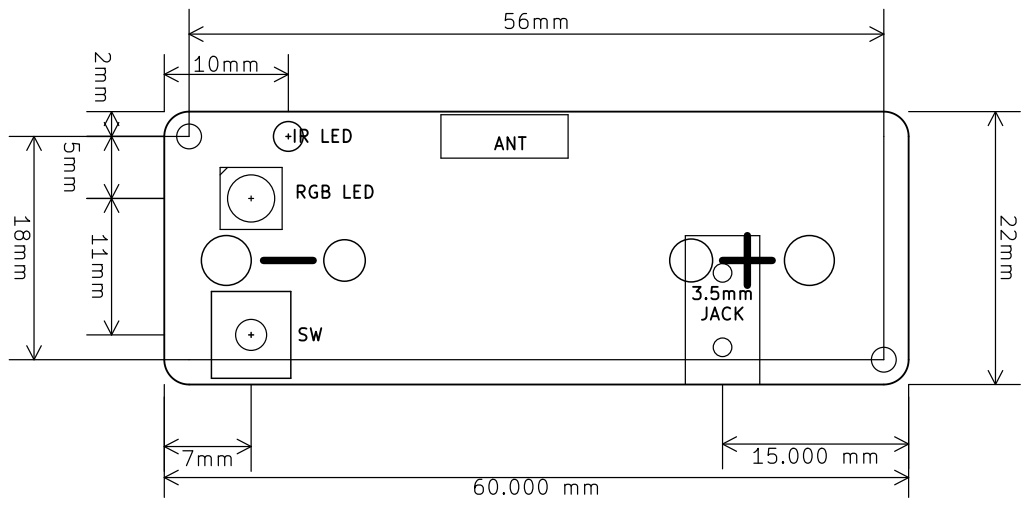
[picture p95: page 1]
