Appiko/sense_snap_hw/snap_rev3/pdf/snap_rev3-F.Cu.pdf

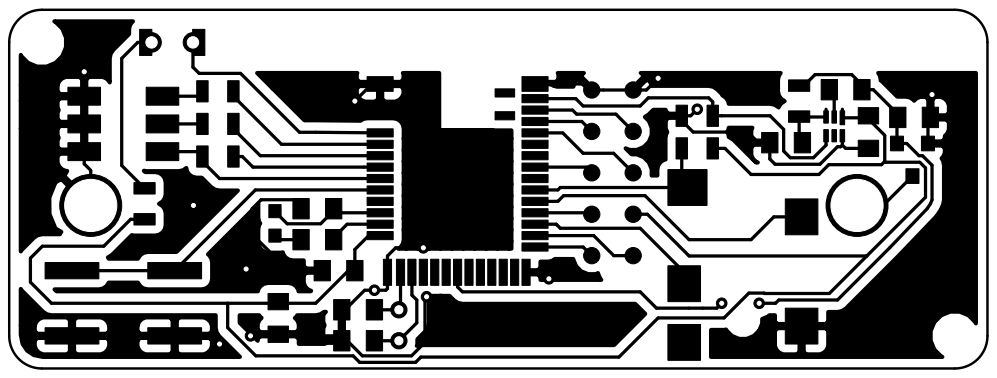
[picture p96: page 1]
