Appiko/sense_snap_hw/snap_rev3/pdf/snap_rev3-F.SilkS.pdf

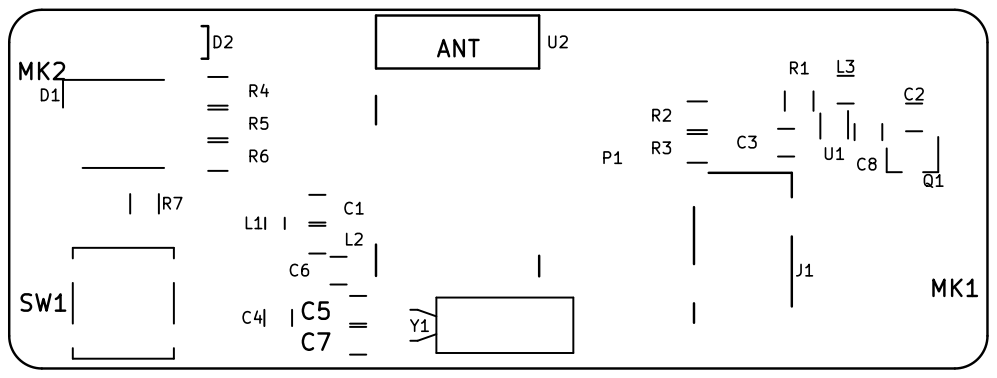
[picture p97: page 1]
