Appiko/sense_snap_hw/senseBe_rev2/Documents/senseBe_rev2.pdf

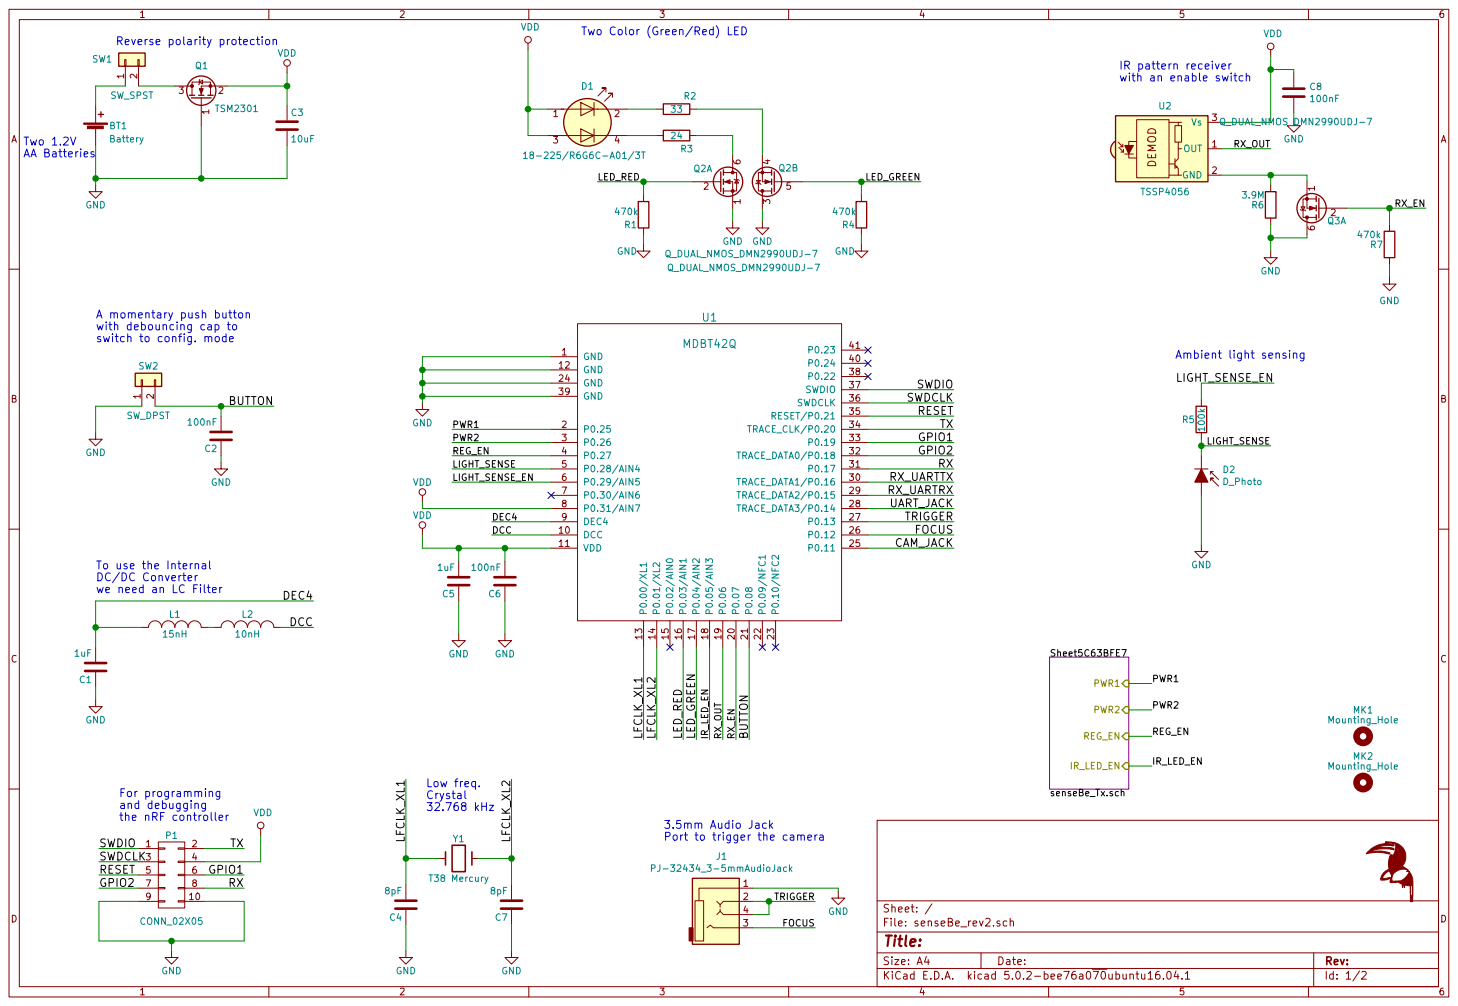
[picture p98: page 1]

IR pattern receiver with an enable switch Ambient light sensing

switch to config. mode To use the Internal DC/DC Converter

A momentary push button
with debouncing cap to

UART_JACK
TRIGGER

we need an LC Filter

3.5mm Audio Jack Port to trigger the camera

5 | | 6 GPIO1

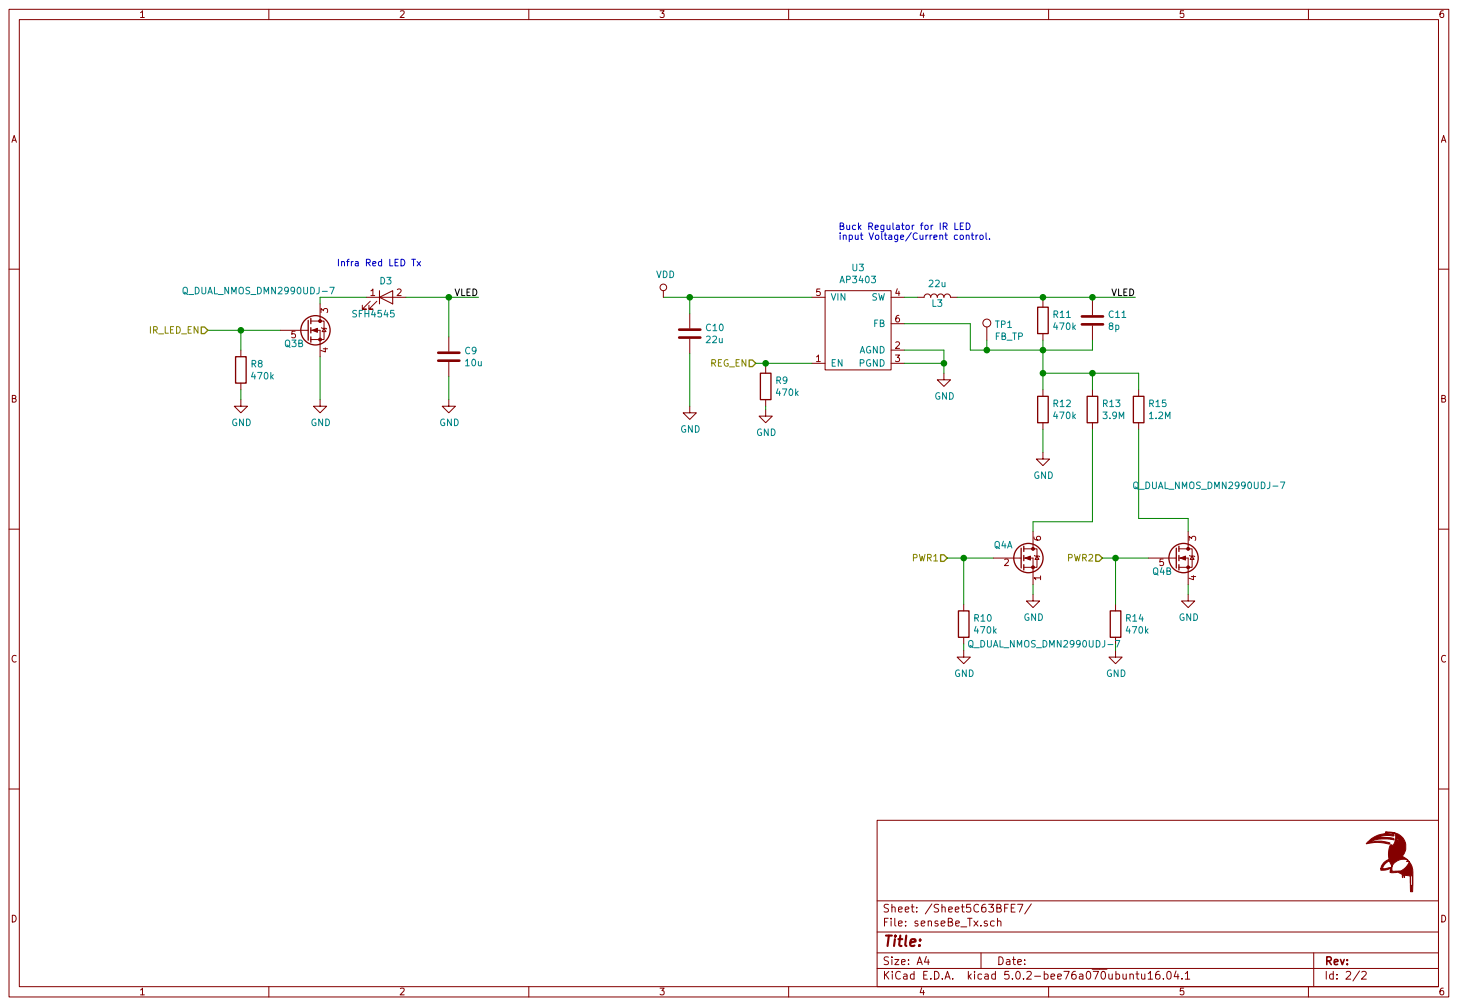
[picture p99: page 2]

Buck Regulator for IR LED
input Voltage/Current control.
