Appiko/sense_snap_hw/senseBe_rev1/Documents/senseBe_rev1.pdf

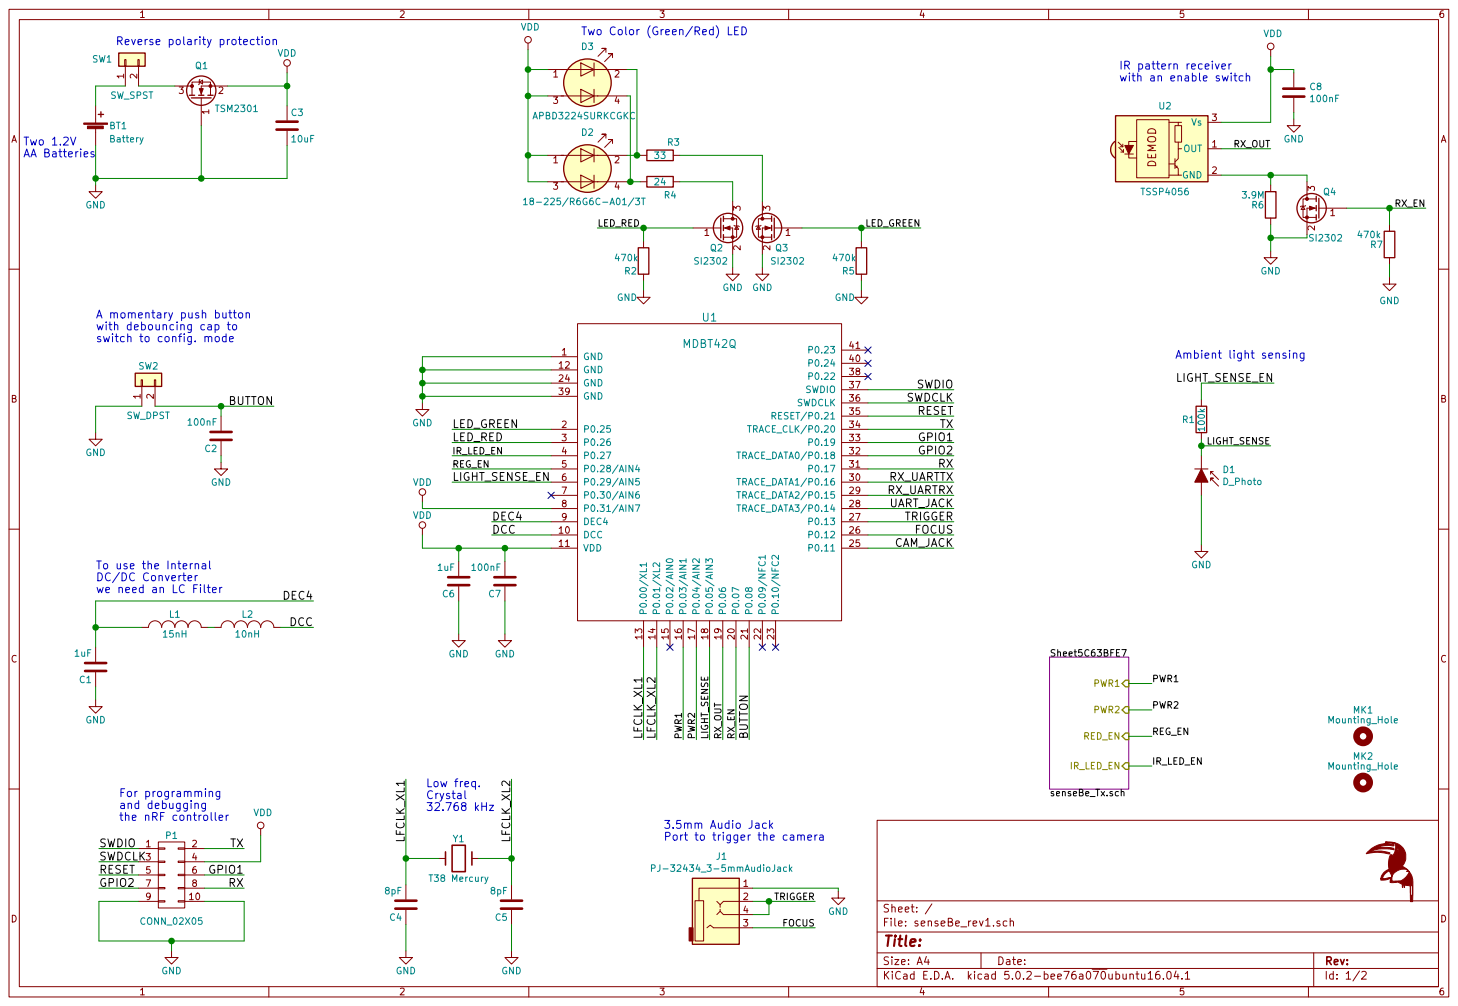
[picture p100: page 1]

switch to config. mode To use the Internal DC/DC Converter

A momentary push button
with debouncing cap to

UART_JACK
TRIGGER

we need an LC Filter

3.5mm Audio Jack Port to trigger the camera

5 | | 6 GPIO1

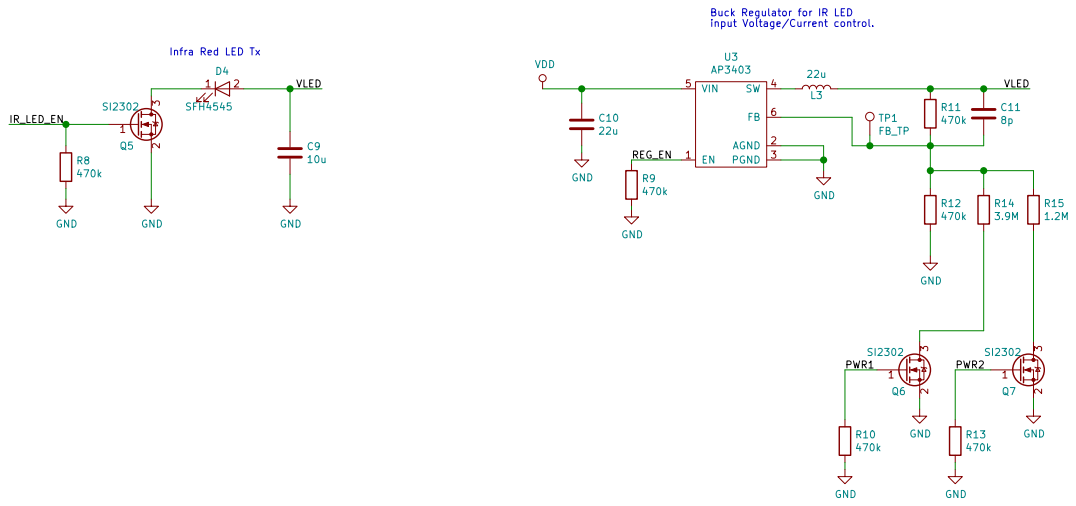
[picture p101: page 2]

Buck Regulator for IR LED
input Voltage/Current control.
