Appiko/sense_snap_hw/senseBeRx_rev2/Documents/senseBeRx_rev2.pdf

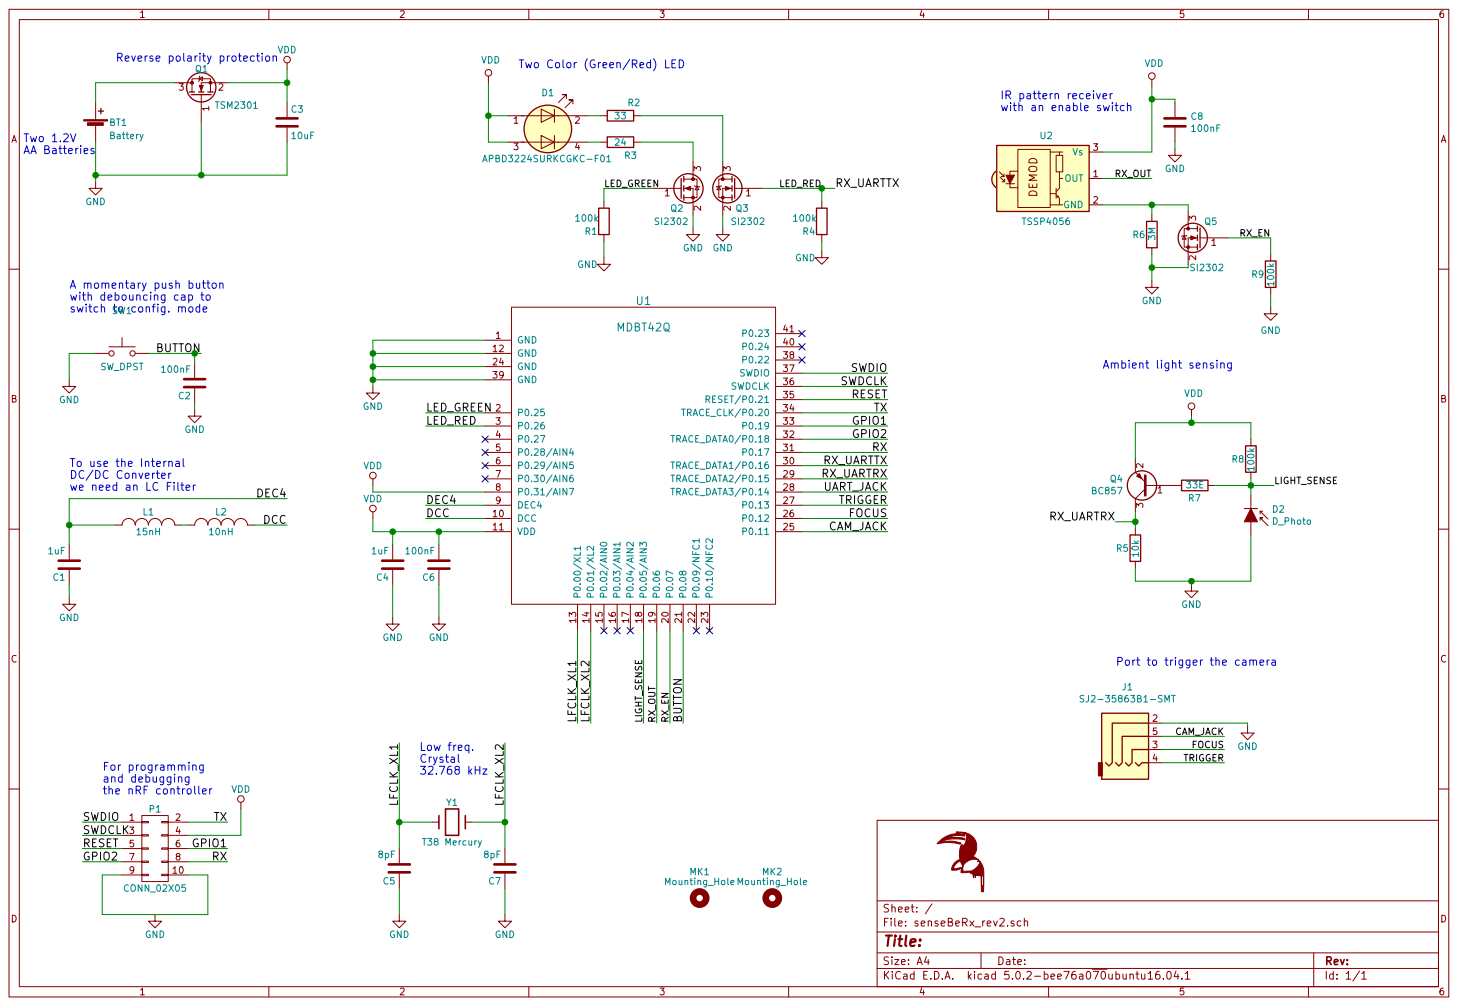
[picture p102: page 1]

IR pattern receiver with an enable switchAmbient light sensing

A momentary push button
with debouncing cap to
switch to config. mode To use the Internal DC/DC Converter

we need an LC Filter
