Appiko/sense_snap_hw/senseBeTx_rev2/Documents/senseBeTx_rev2.pdf

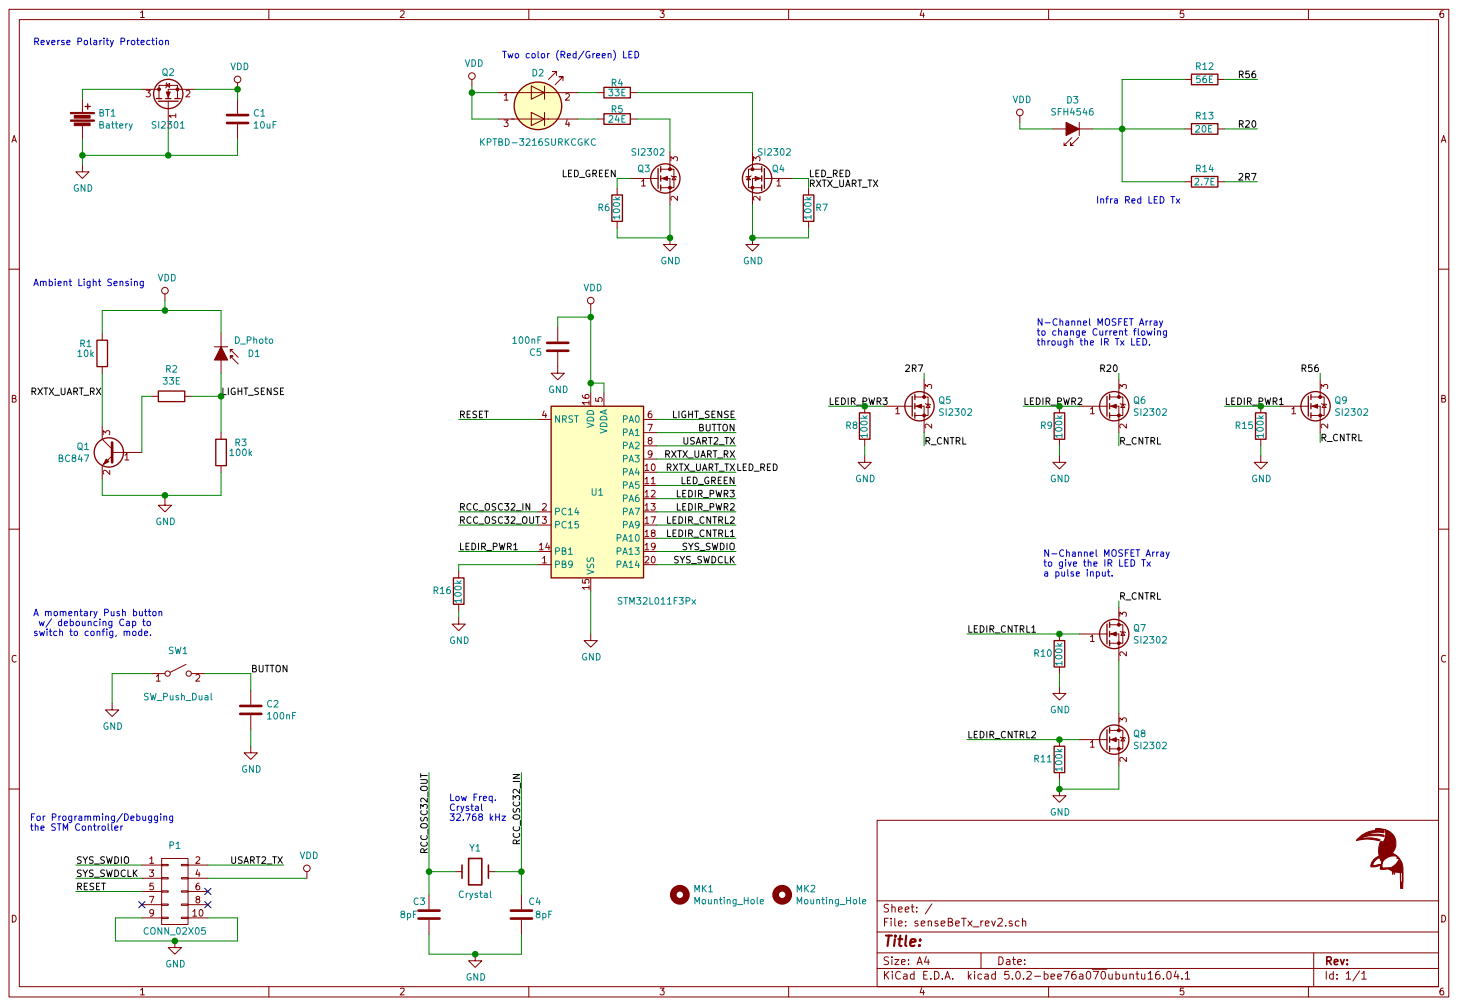
[picture p103: page 1]

Two color (Red/Green) LED

Infra Red LED Tx BUTTON

N-Channel MOSFET Array
to change Current flowing
through the IR Tx LED.

to give the IR LED Tx

A momentary Push button
w/ debouncing Cap to
switch to config, mode.
