Appiko/sense_snap_hw/senseBeTx_rev1/Documents/senseBeTx_rev1.pdf

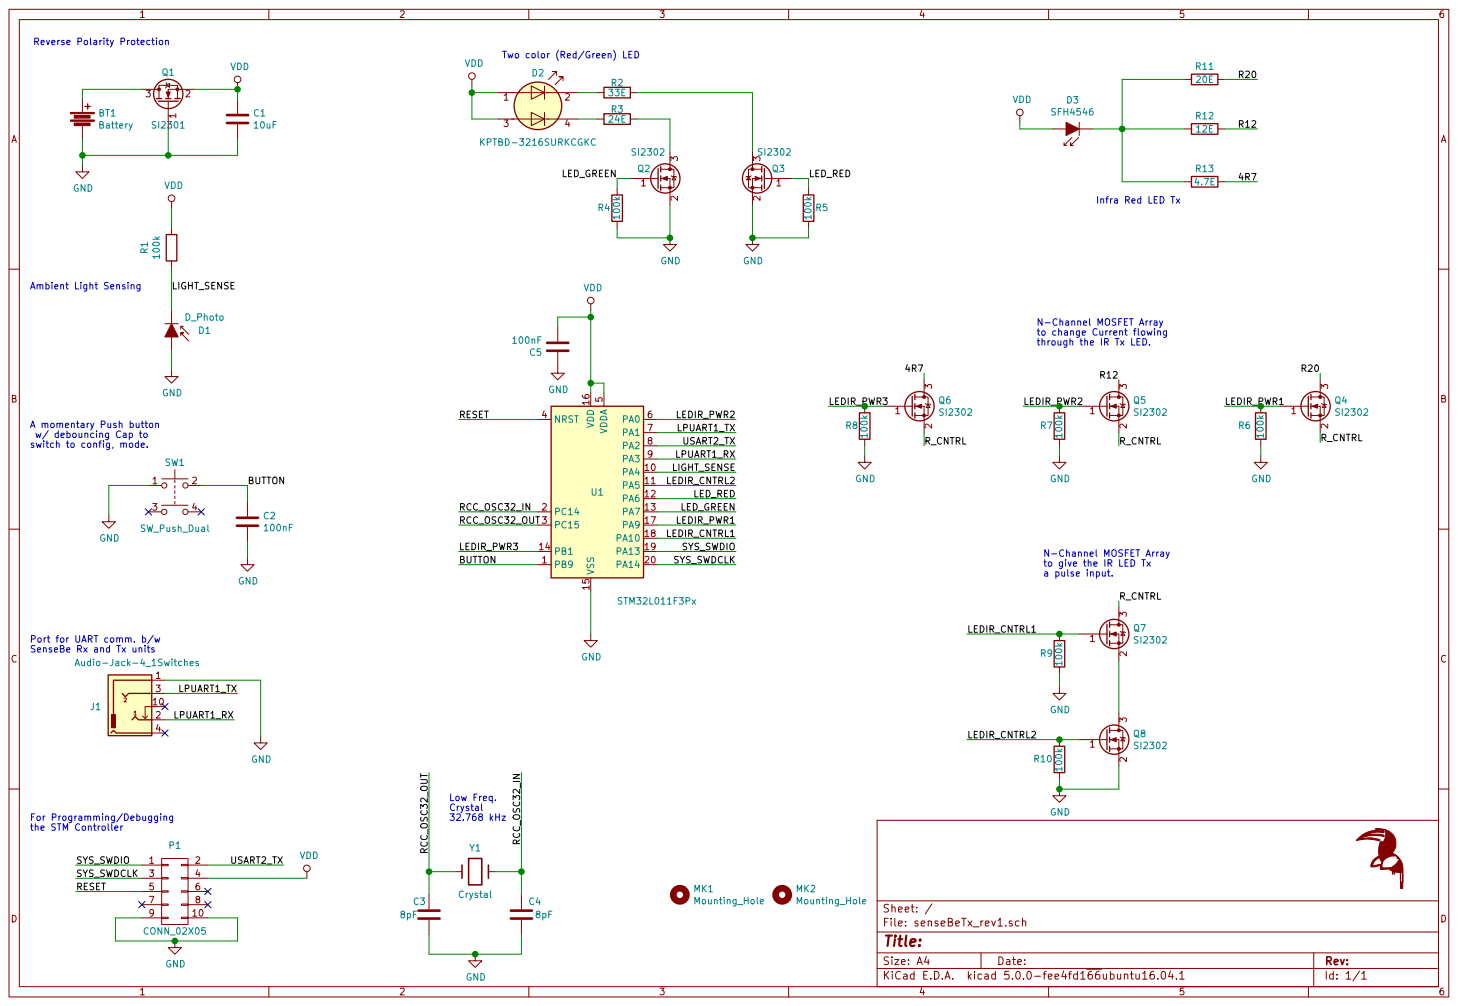
[picture p104: page 1]

Ambient Light Sensing Port for UART comm. b/w SenseBe Rx and Tx units For Programming/Debugging

Two color (Red/Green) LED

Infra Red LED Tx

N-Channel MOSFET Array
to change Current flowing
through the IR Tx LED.

A momentary Push button
w/ debouncing Cap to
switch to config, mode.

to give the IR LED Tx
