Appiko/sense_snap_hw/senseBeRx_rev1/Documents/senseBeRx_rev1.pdf

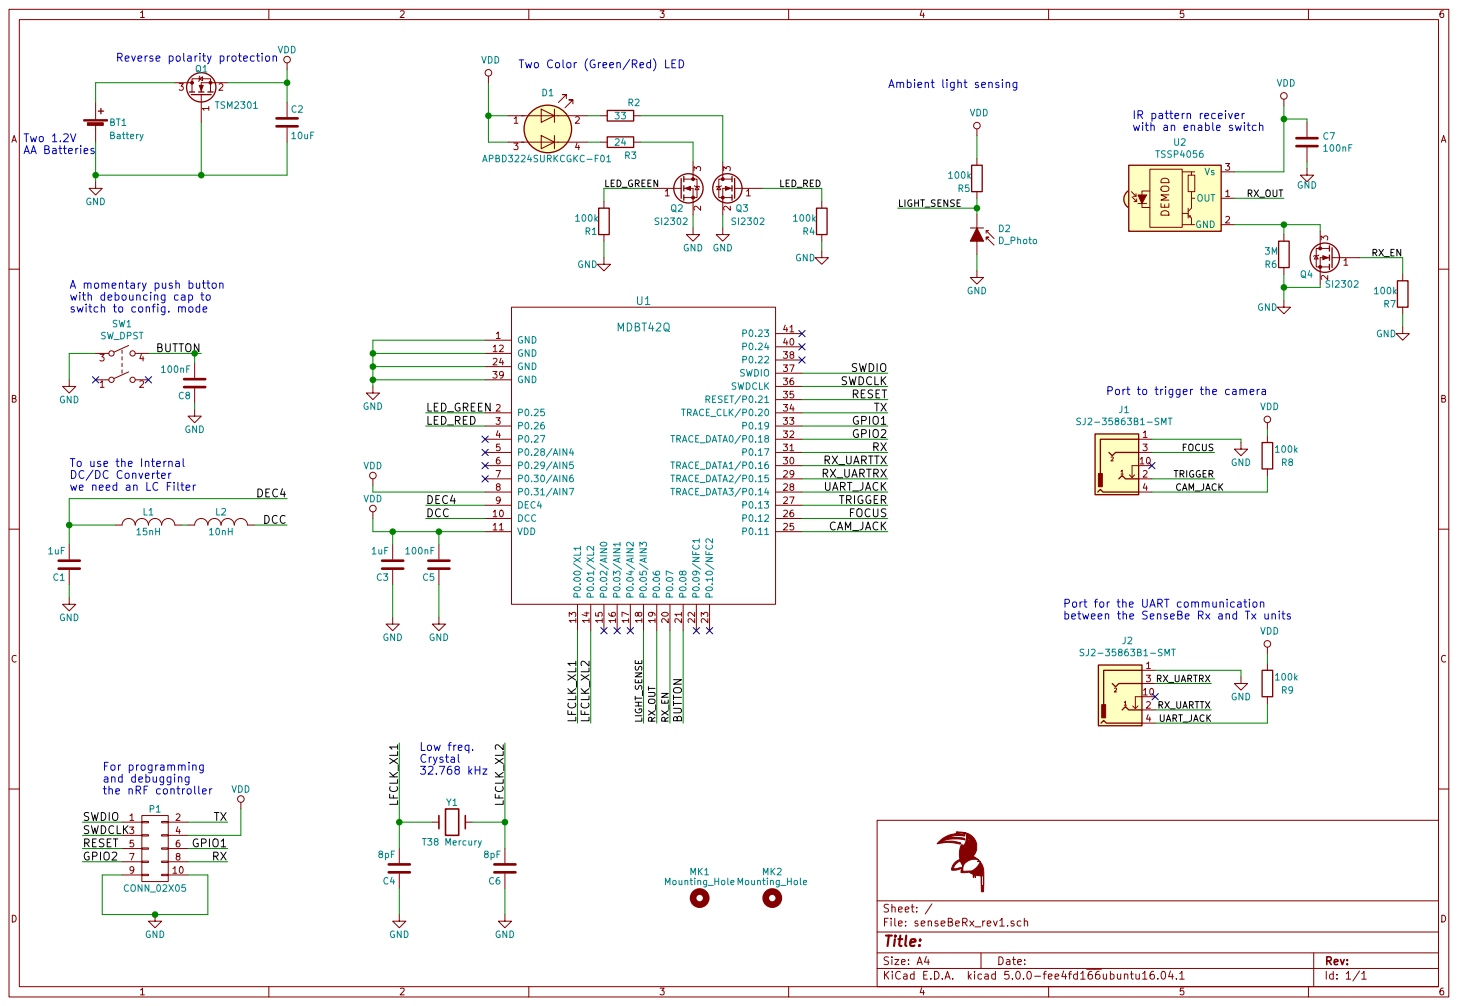
[picture p105: page 1]

IR pattern receiver with an enable switch Ambient light sensing

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

100k VDD Port to trigger the camera Port for the UART communication between the SenseBe Rx and Tx units
J1 SJ2-35863B1-SMT

we need an LC Filter
