Appiko/sense_snap_hw/sense_rev2/output/sense_rev2.pdf

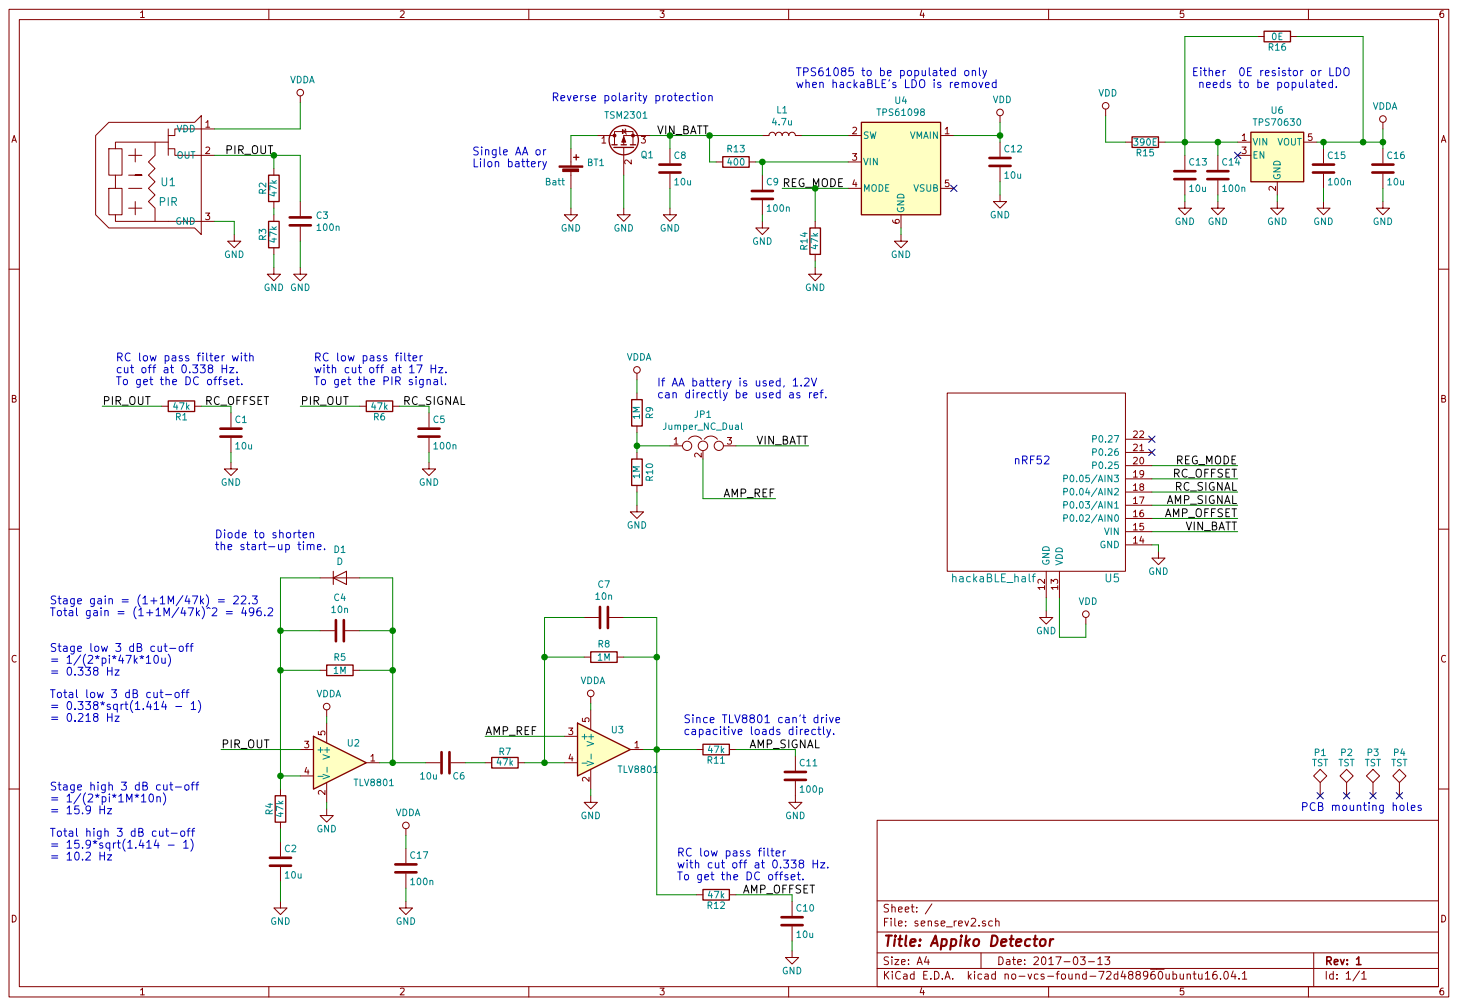
[picture p106: page 1]

VDDA Diode to shorten
VDD 1 OUT 2 GND 3 U1 PIR

2 EN 3 VOUT 5 U6 TPS70630 TPS61085 to be populated only
when hackaBLE's LDO is removed GND

VDDA Either 0E resistor or LDO

100n GND R14 47k GND Single AA or
LiIon battery

RC low pass filter with

RC low pass filter with cut off at 17 Hz. To get the PIR signal.

If AA battery is used, 1.2V

the start-up time.

Stage low 3 dB cut-off
= 1/(2*pi*47k*10u) = 0.338 Hz Total low 3 dB cut-off = 0.338*sqrt(1.414 - 1) = 0.218 Hz Stage high 3 dB cut-off

RC low pass filter with cut off at 0.338 Hz. To get the DC offset. R11

P1 TST P2 TST P3 TST P4 TST PCB mounting holes

= 1/(2*pi*1M*10n) = 15.9 Hz Total high 3 dB cut-off

File: sense_rev2.sch Sheet: /
Id: 1/1 Title: Appiko Detector
