Appiko/sense_snap_hw/senseBe_rev3/senseBe_rev3_daughter/Documents/senseBe_rev3_daughter.pdf

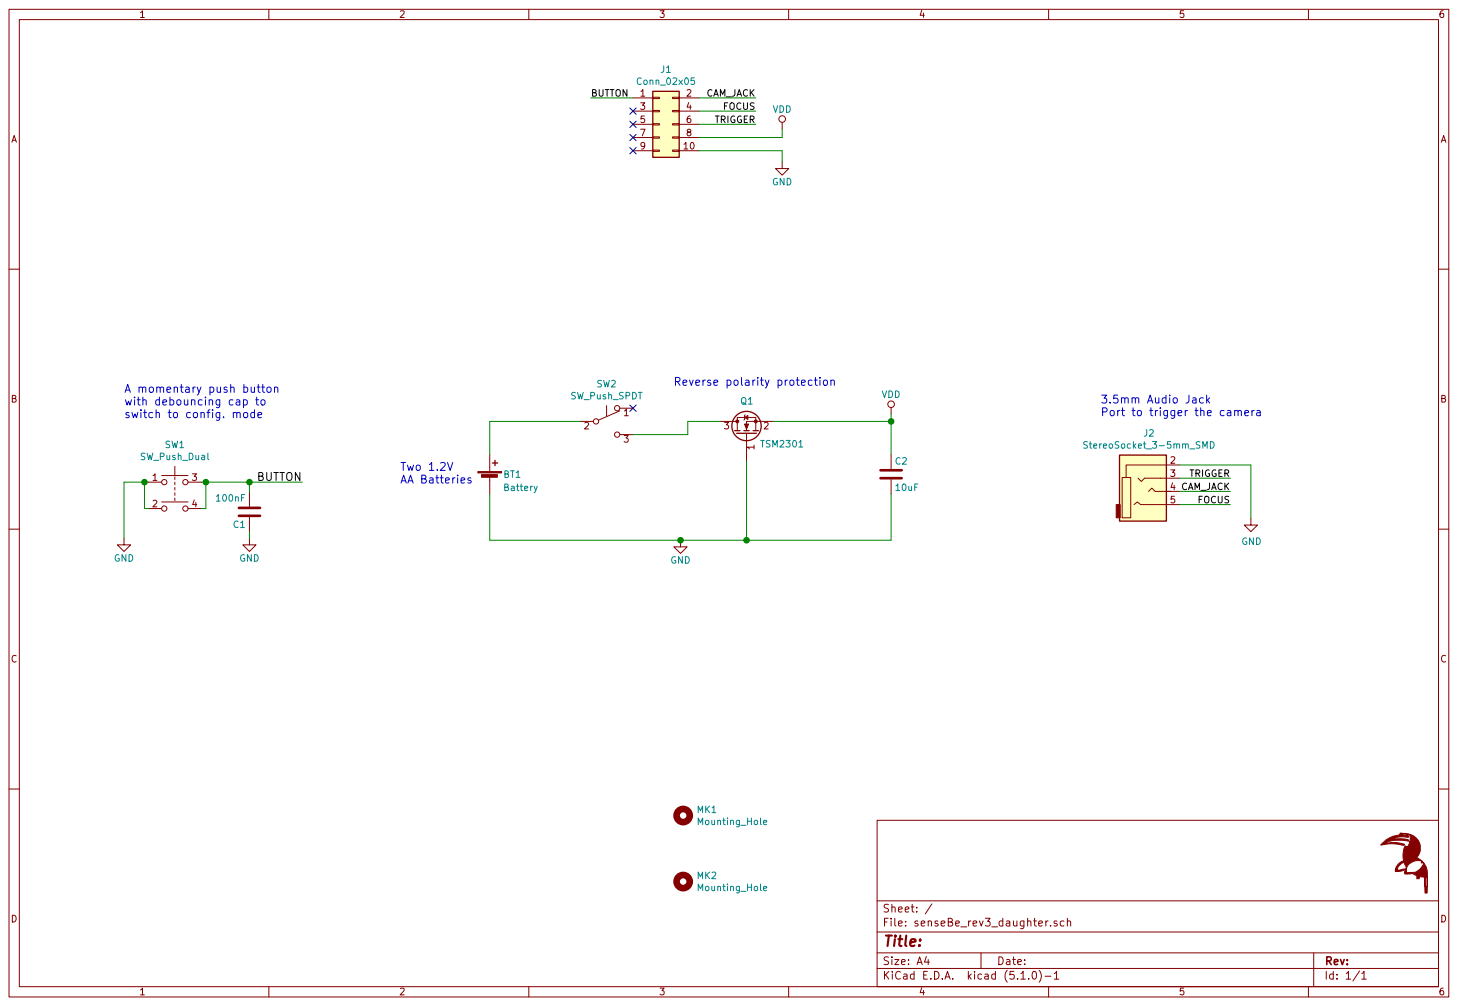
[picture p107: page 1]

with debouncing cap to
switch to config. modeC1
