Appiko/sense_snap_hw/senseBe_rev3/senseBe_rev3_main/Documents/senseBe_rev3_main.pdf

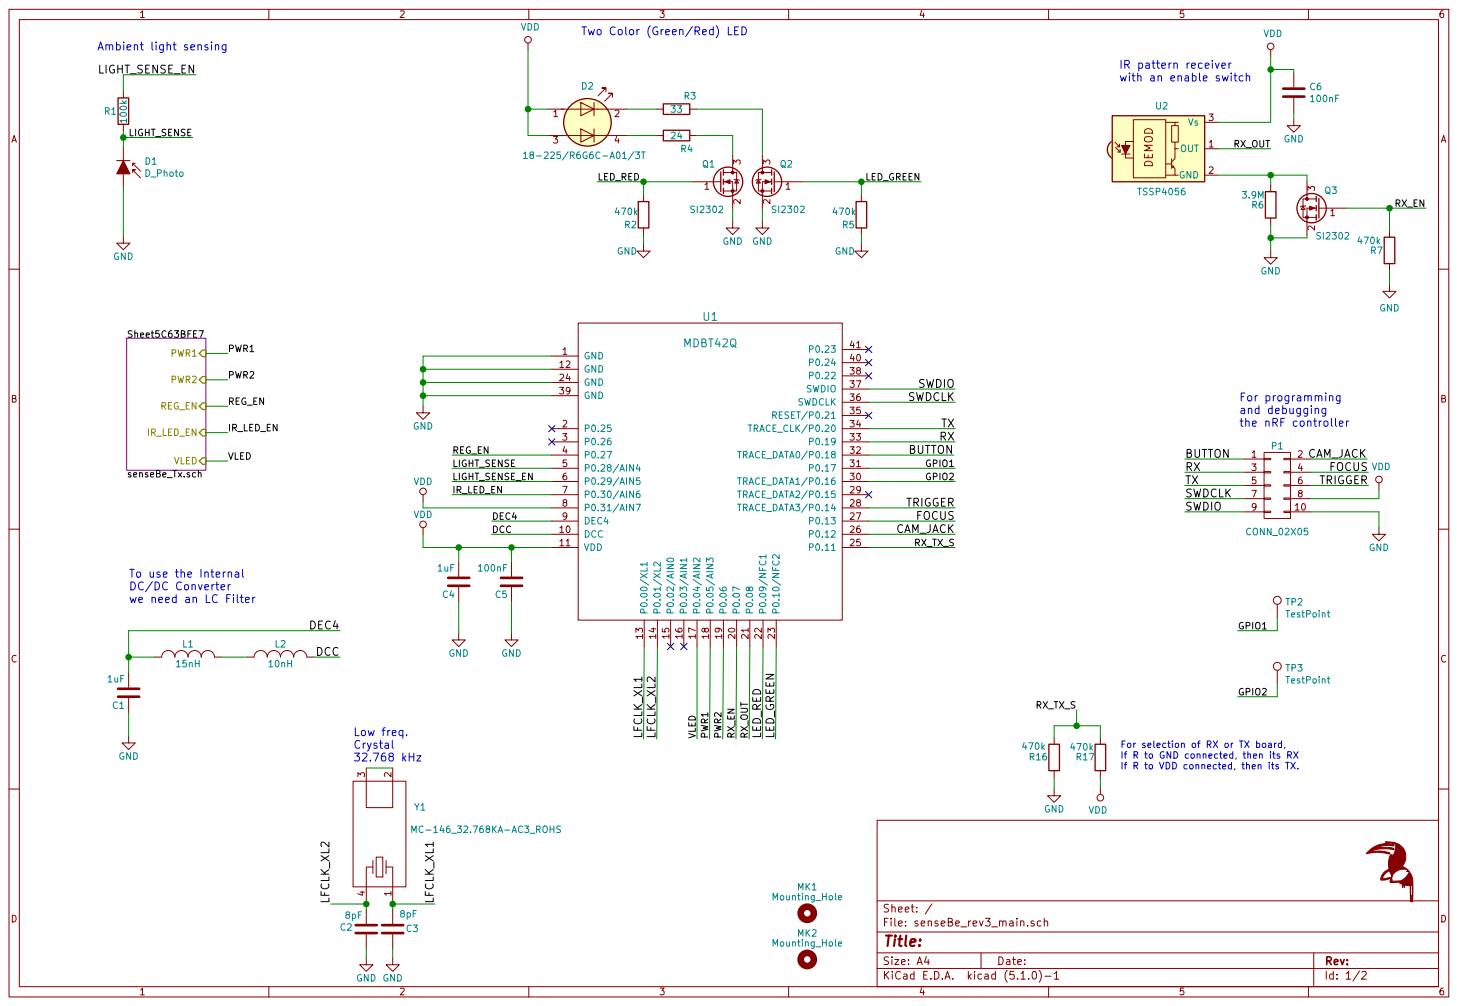
[picture p108: page 1]

IR pattern receiver with an enable switch Ambient light sensing
LIGHT_SENSE_EN
D1D_Photo R1 100k GND

4 Y1MC-146_32.768KA-AC3_ROHS VLED GND 1 DCC 10 VDD 11 GND 12 P0.00/XL1 13 P0.01/XL2 14 P0.02/AIN0 15 P0.03/AIN1 16 P0.04/AIN2 17 P0.05/AIN3 18 P0.06 19 P0.25 2 P0.07 20 P0.08 21 P0.09/NFC1 22 P0.10/NFC2 23 GND 24 P0.11 25 P0.12 26 P0.13 27 TRACE_DATA3/P0.14 28 TRACE_DATA2/P0.15 29 P0.26 3 TRACE_DATA1/P0.16 30 P0.17 31 TRACE_DATA0/P0.18 32 P0.19 33 TRACE_CLK/P0.20 34 RESET/P0.21 35 SWDCLK 36 SWDIO 37 P0.22 38 GND 39 P0.27 4 P0.24 40 P0.23 41 P0.28/AIN4 5 P0.29/AIN5 6 P0.30/AIN6 7 P0.31/AIN7 8 DEC4 9 U1 MDBT42Q

To use the Internal DC/DC Converter

we need an LC Filter

For selection of RX or TX board,
If R to GND connected, then its RX

If R to VDD connected, then its TX. 1

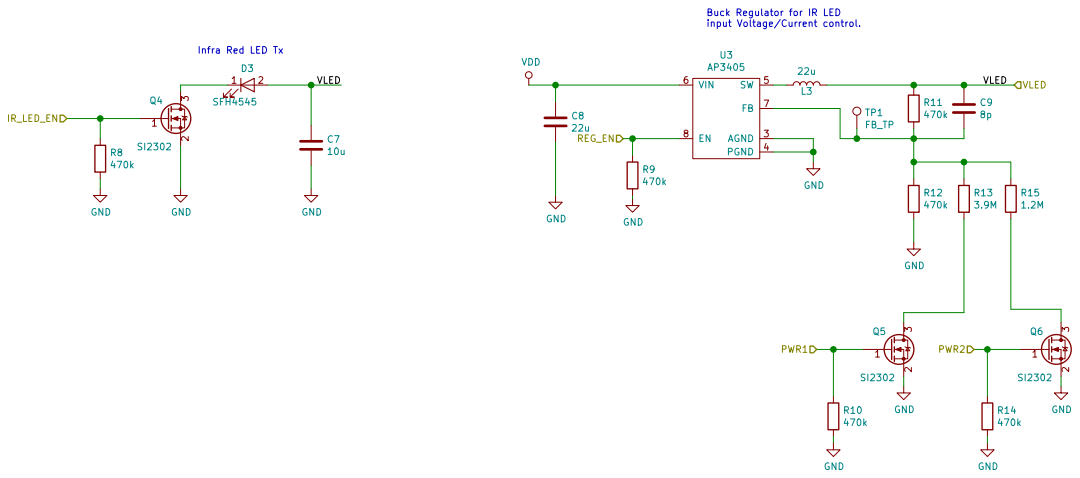
[picture p109: page 2]

Buck Regulator for IR LED

2 Q6 3 SI2302 AGND 3 PGND 4 SW 5 VIN 6 FB 7 EN 8 U3 AP3405 R9
