Appiko/sense_snap_hw/senseEle_PCB_Antenna_rev1/Documents/senseEle_PCB_Antenna_rev1.pdf

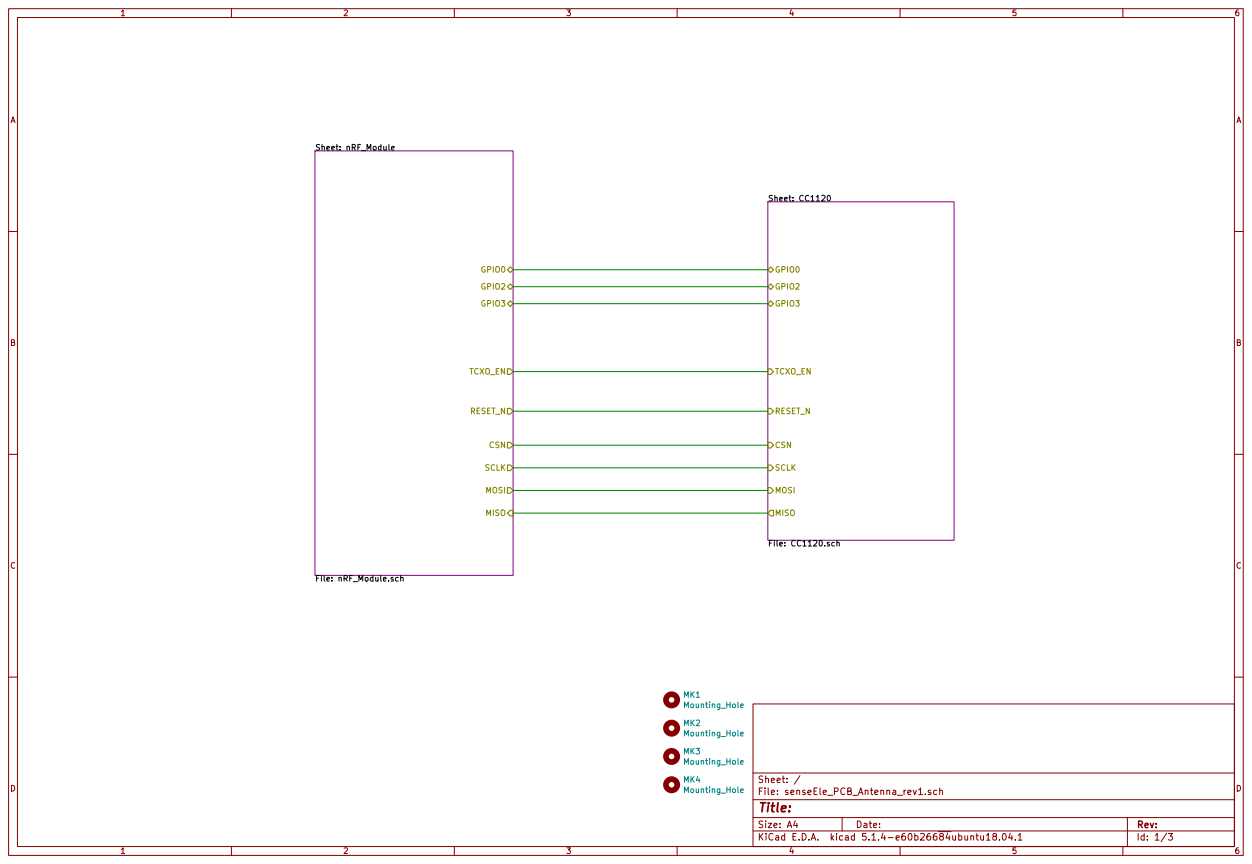
[picture p110: page 1]

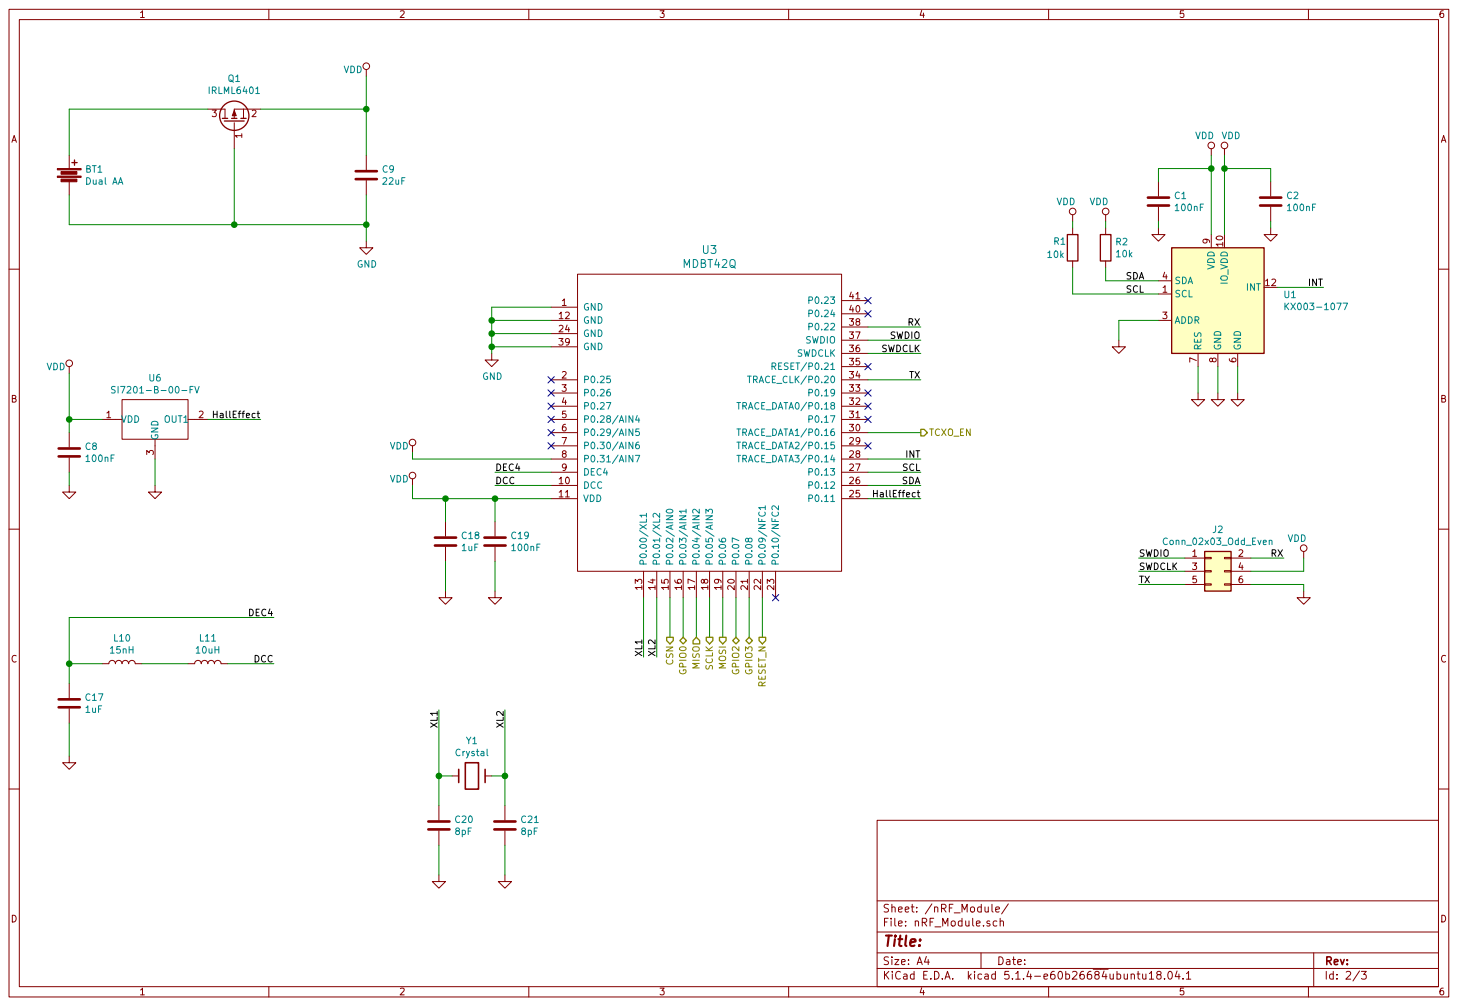
[picture p111: page 2]

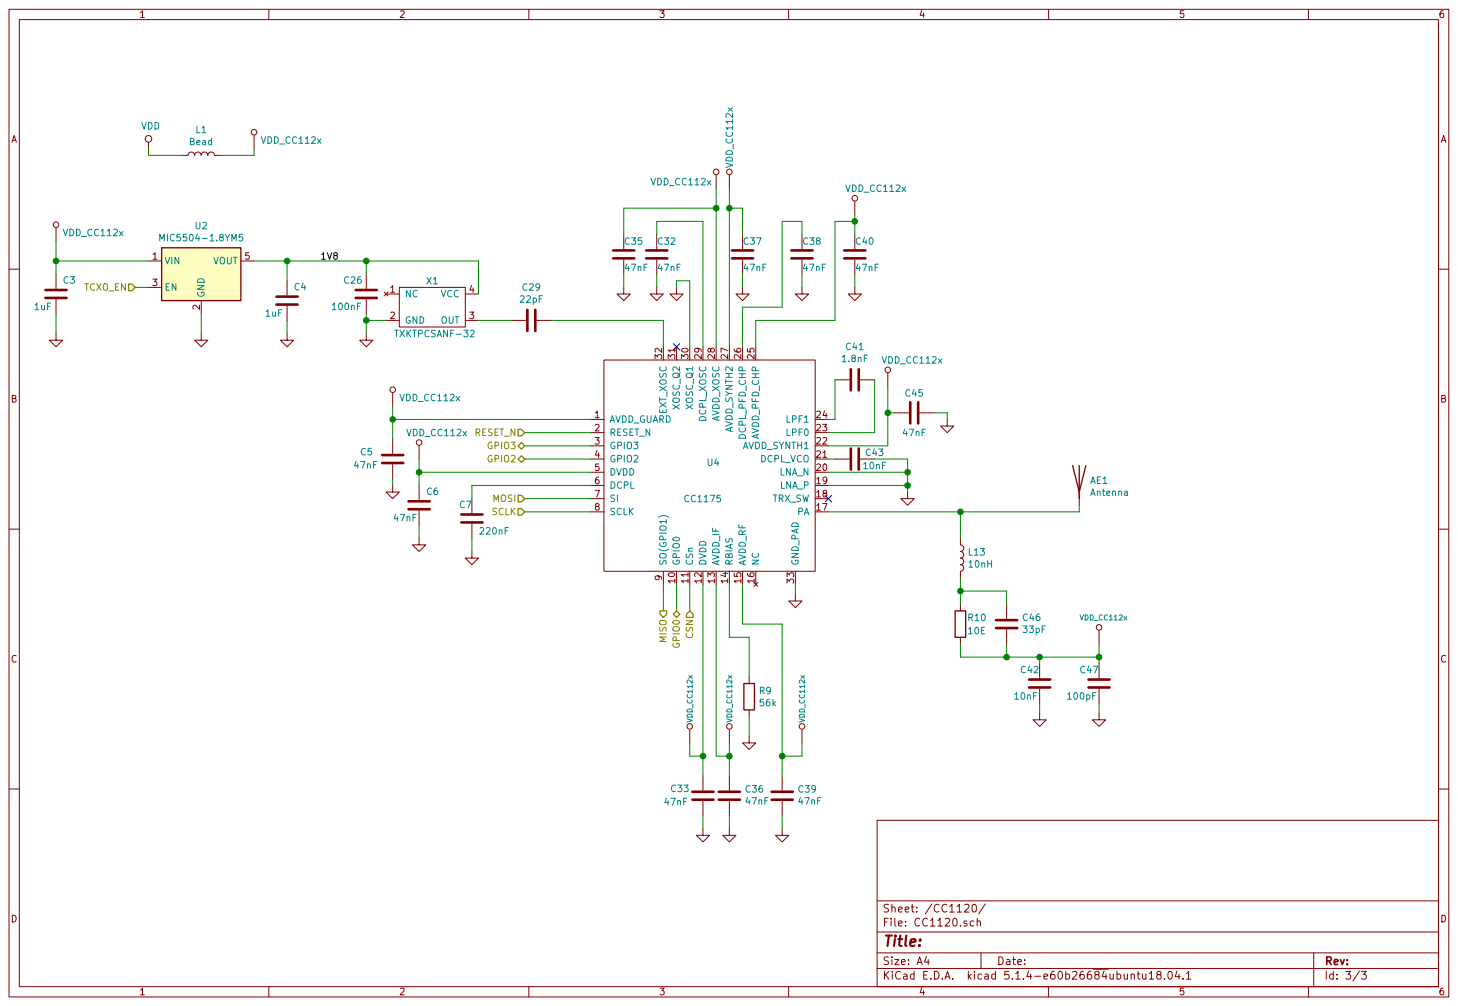
[picture p112: page 3]

Id: 3/3 Title: File: CC1120.sch Sheet: /CC1120/ VDD_CC112x C4
