Appiko/sense_snap_hw/sense_rev3/Documents/sense_rev3.pdf

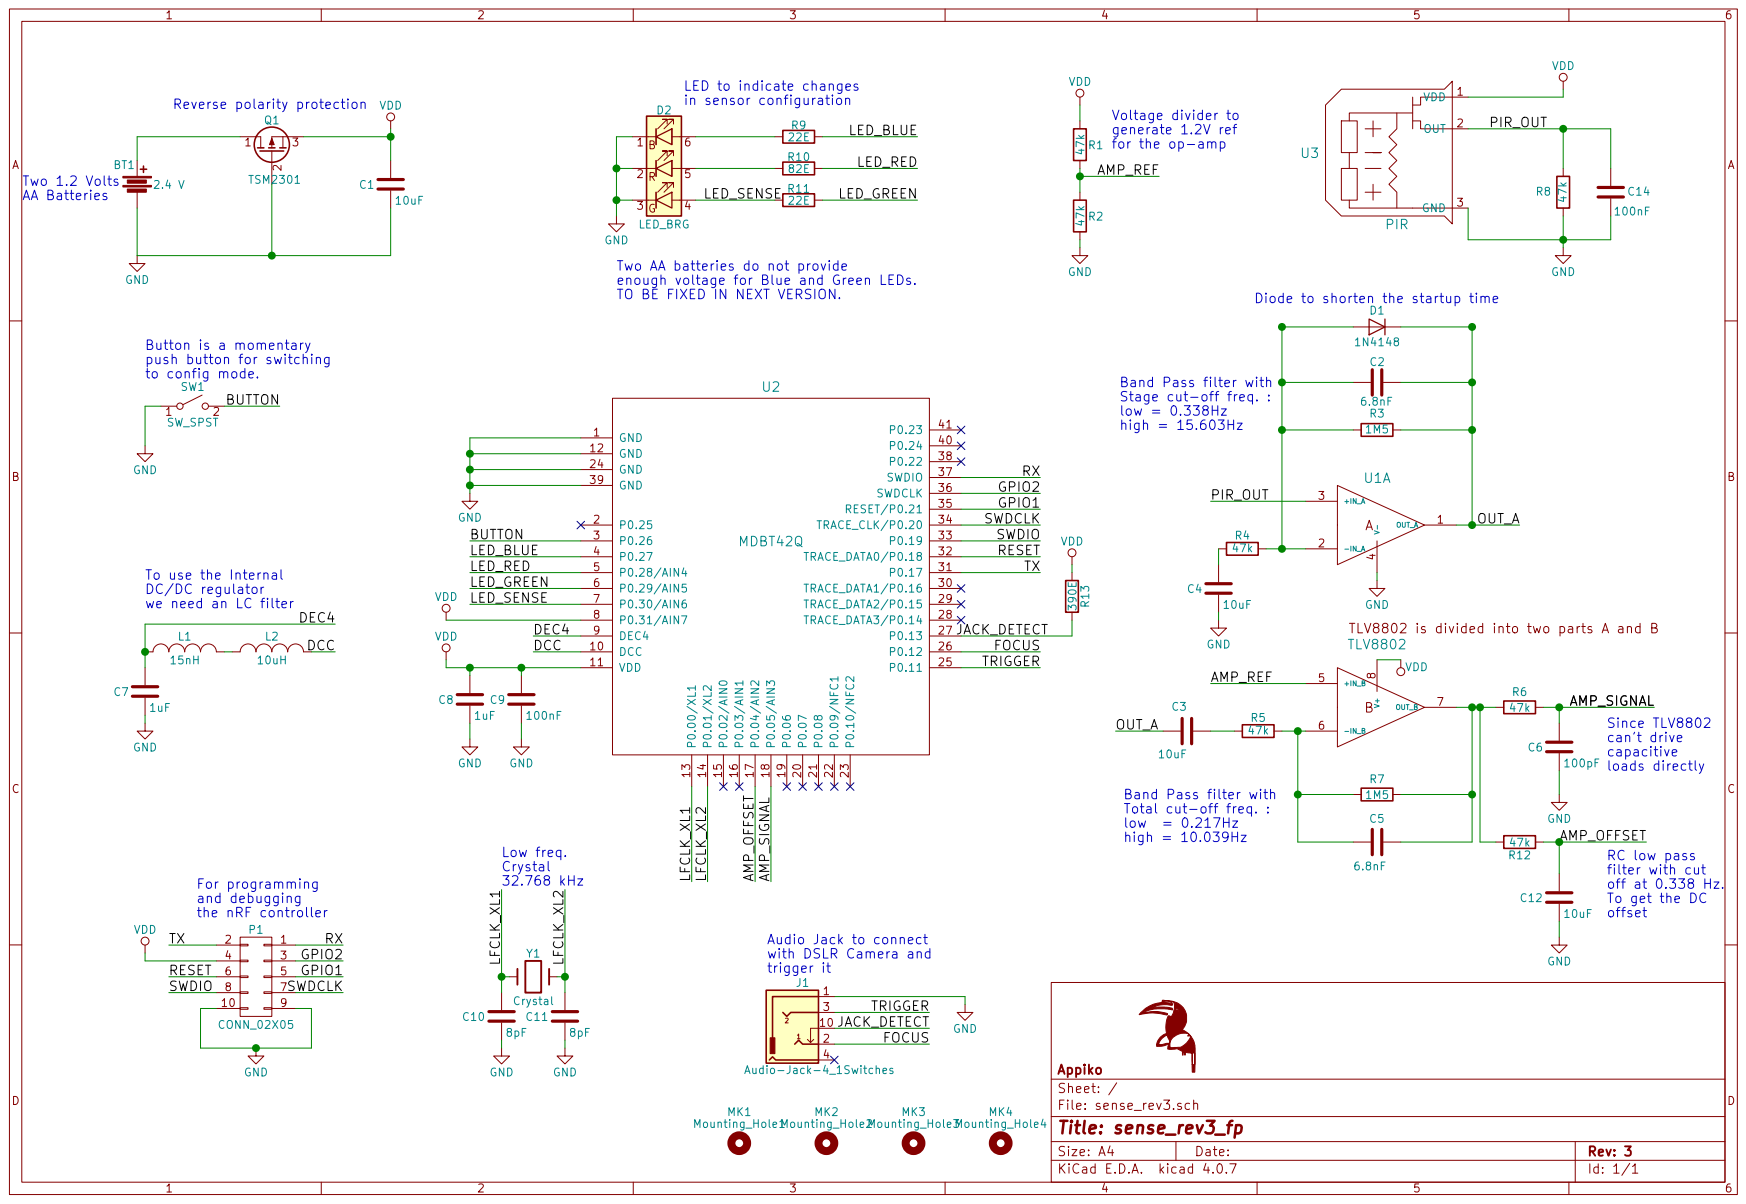
[picture p113: page 1]
