Appiko/sense_snap_hw/sense_rev3/Gerber/sense_rev3-B.Cu.pdf

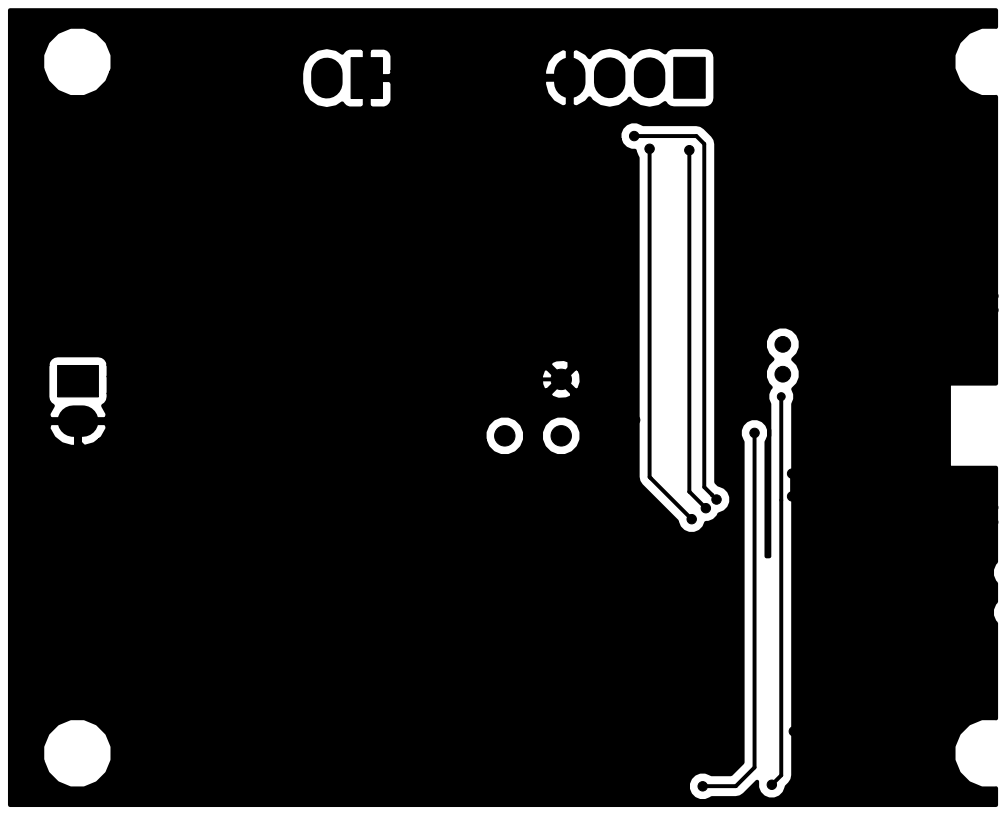
[picture p114: page 1]
