Appiko/sense_snap_hw/sense_rev3/Gerber/sense_rev3-B.Mask.pdf

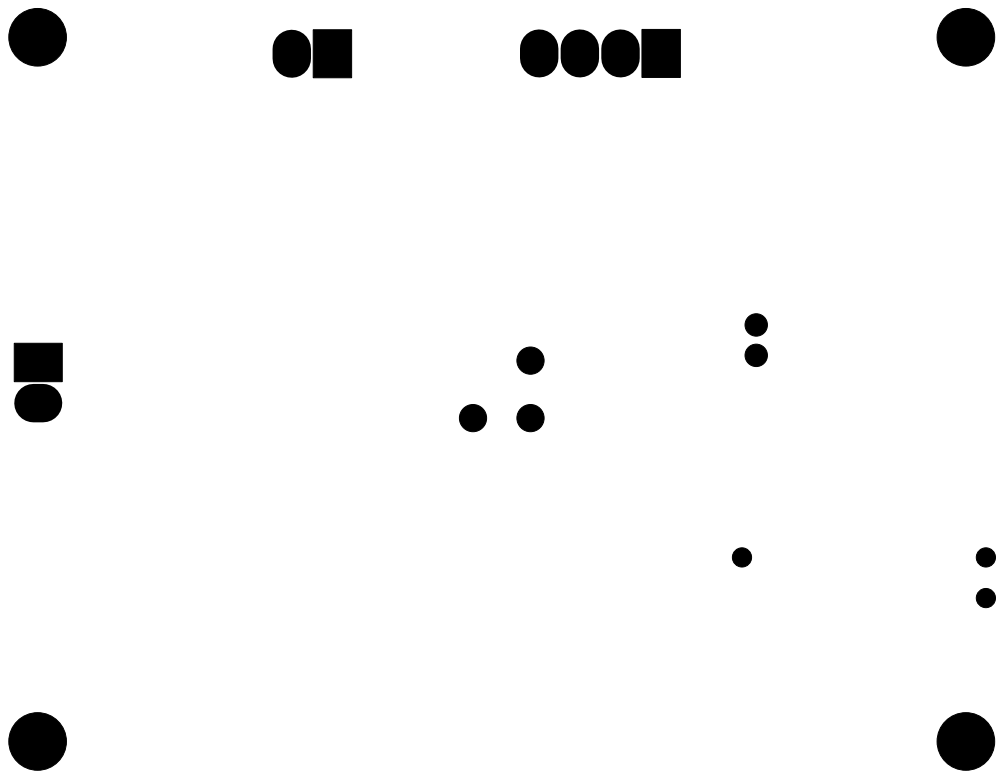
[picture p115: page 1]
