Appiko/sense_snap_hw/sense_rev3/Gerber/sense_rev3-B.SilkS.pdf

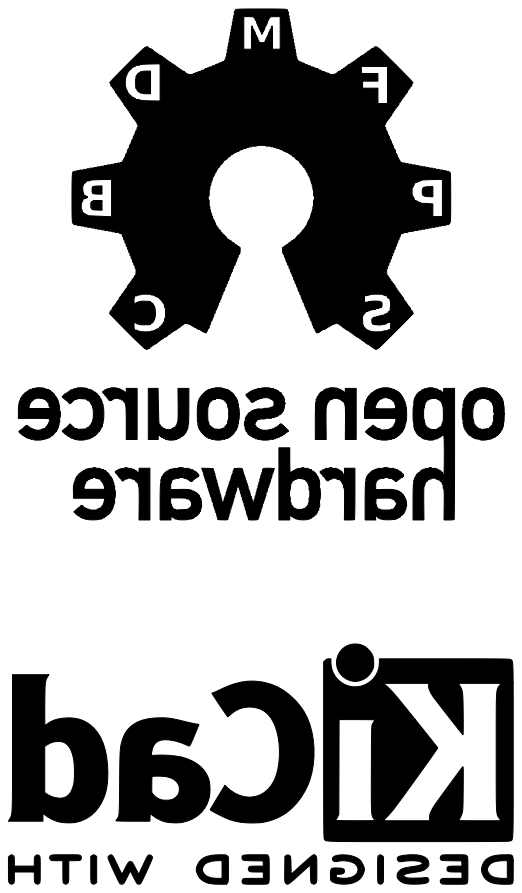
[picture p116: page 1]
