Appiko/sense_snap_hw/sense_rev3/Gerber/sense_rev3-F.Cu.pdf

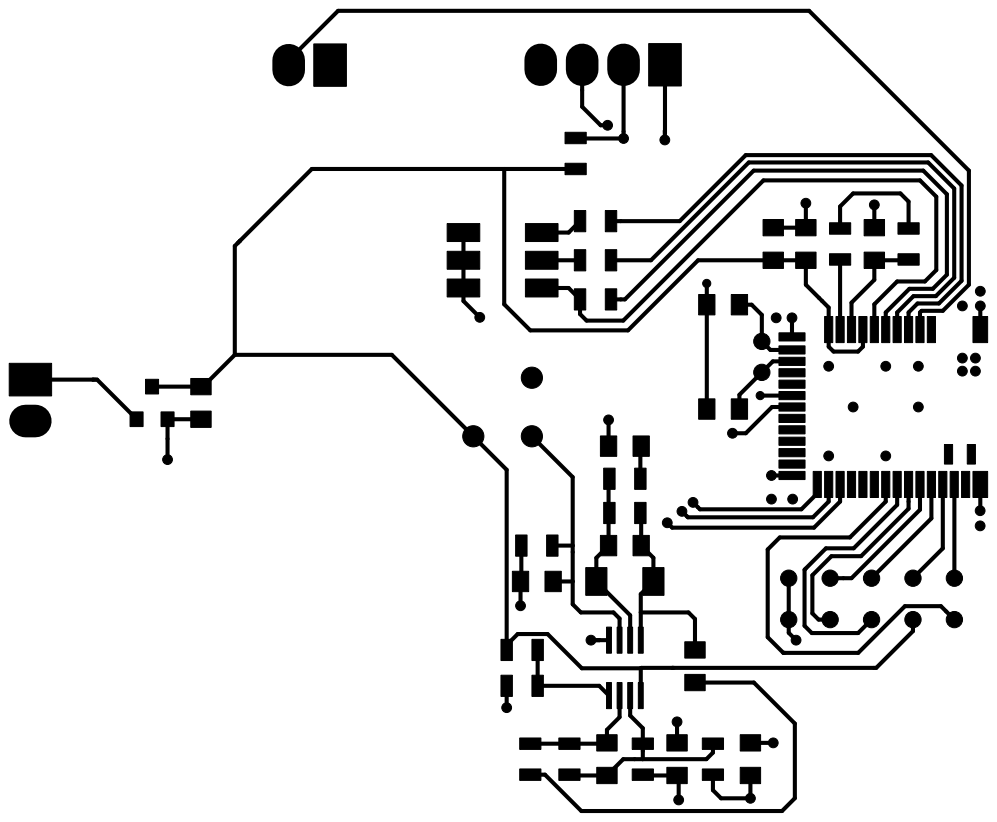
[picture p117: page 1]
