Appiko/sense_snap_hw/sense_rev3/Gerber/sense_rev3-F.Mask.pdf

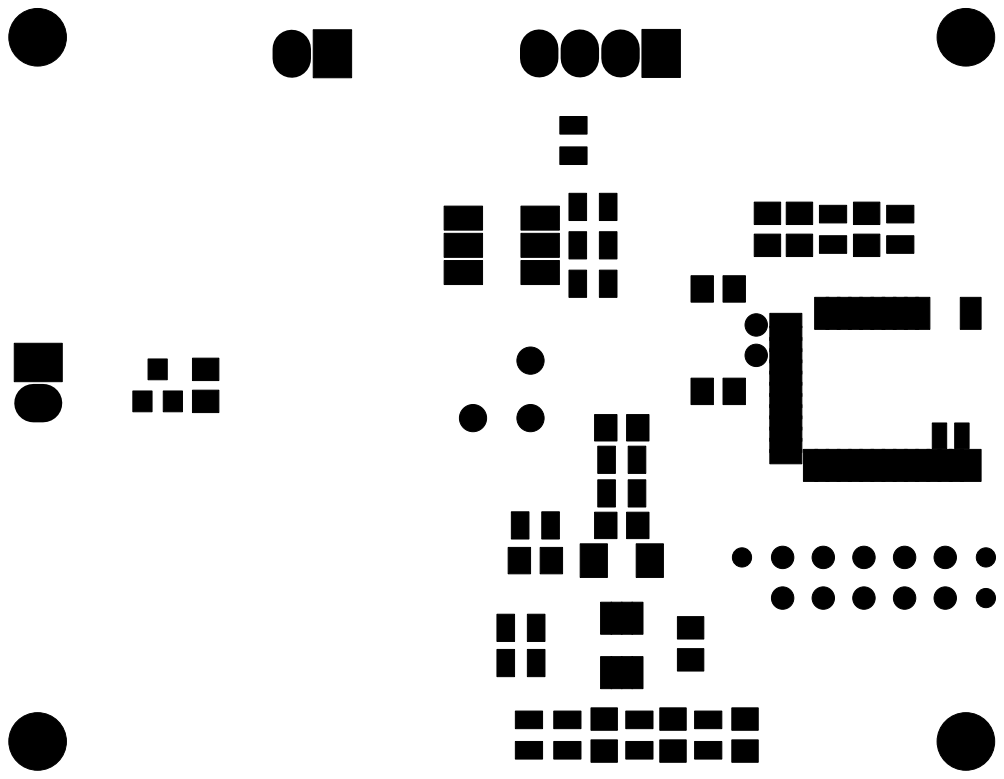
[picture p118: page 1]
