Appiko/sense_snap_hw/sense_rev3/Gerber/sense_rev3-F.SilkS.pdf

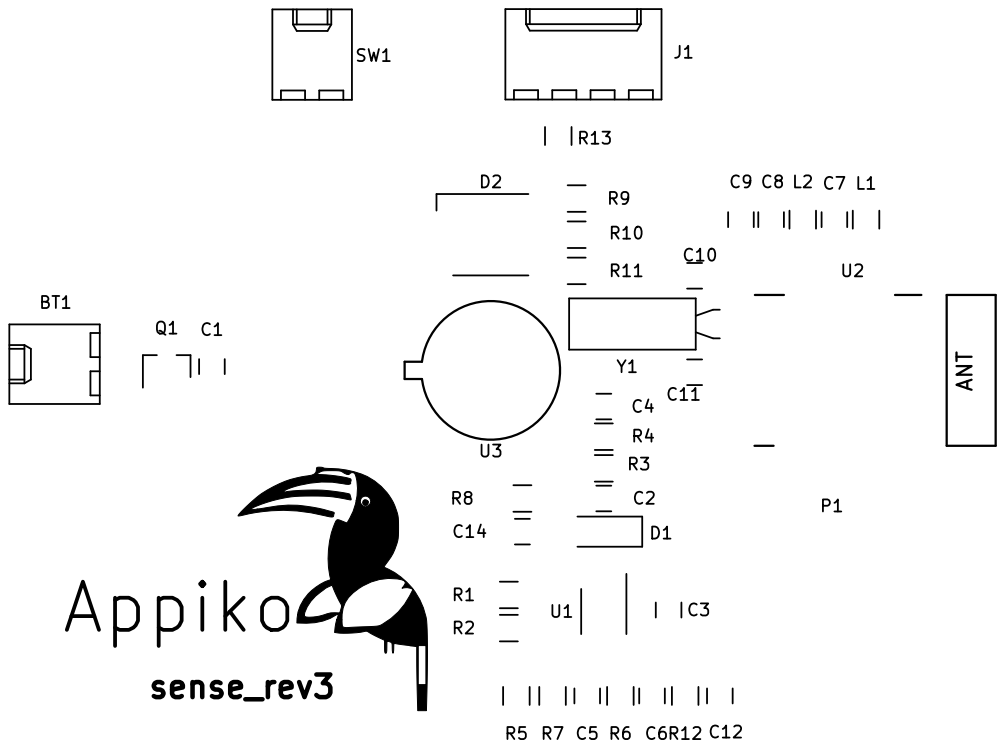
[picture p119: page 1]
