Appiko/sense_snap_hw/snap_rev1/output/snap_rev1.pdf

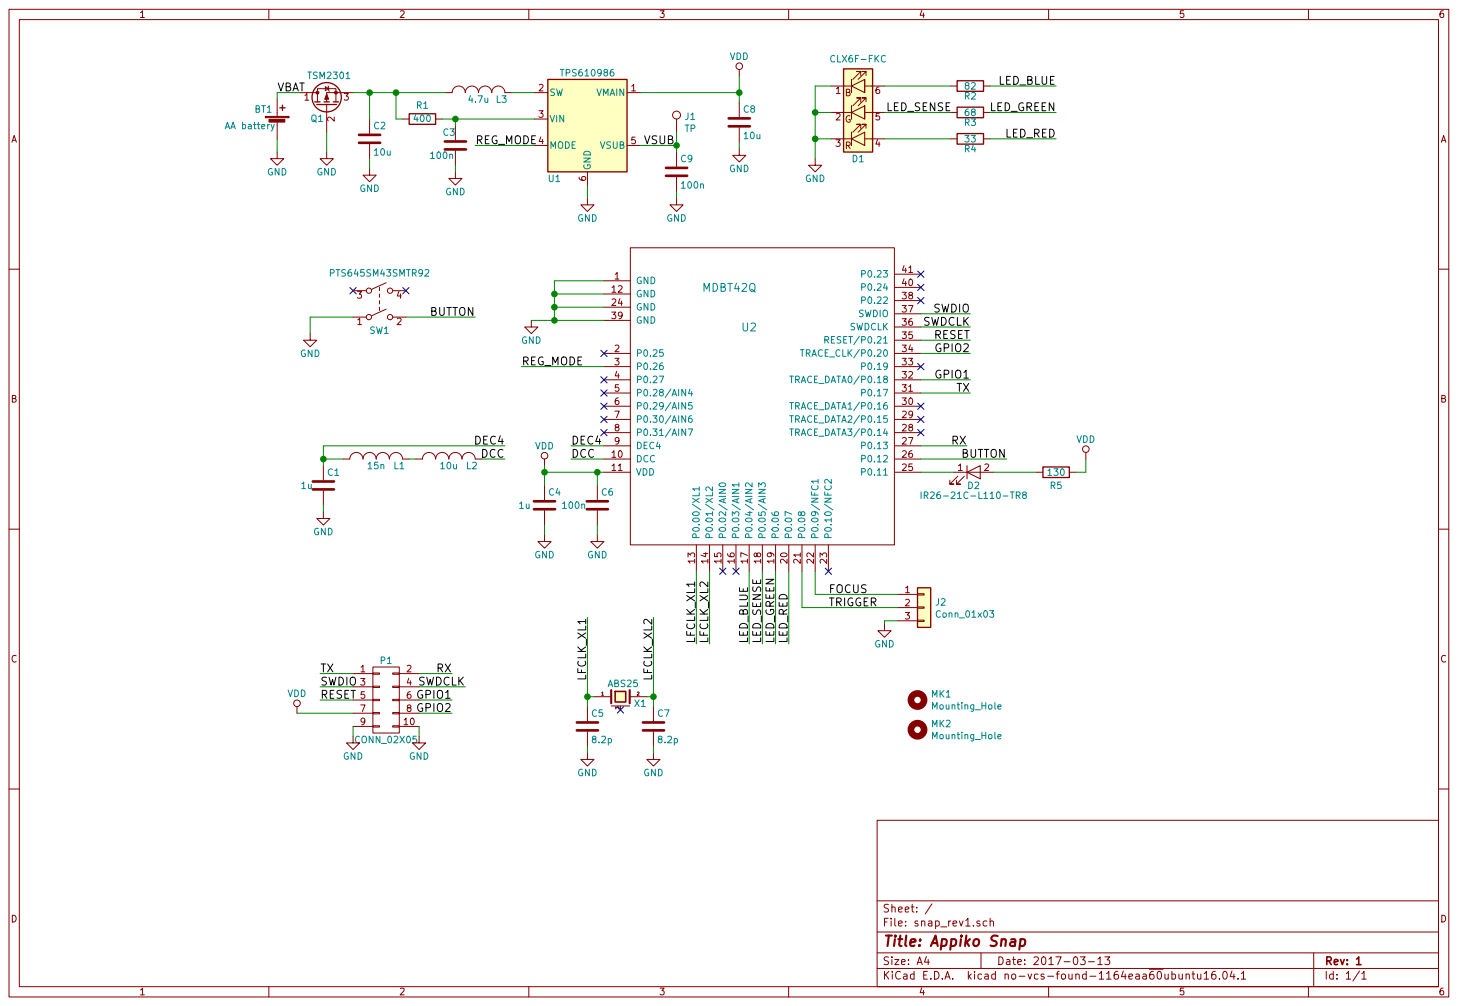
[picture p120: page 1]

File: snap_rev1.sch Sheet: /
Id: 1/1 Title: Appiko Snap
