Appiko/sense_snap_hw/(commit log)

2017-03-14 Don't ignore generated csv BOM
2017-03-14 Initial commit - detector rev 1 done
    [detect_rev1-B_Cu.gbl, detect_rev1-B_Mask.gbs, detect_rev1-B_SilkS.gbo, detect_rev1-Edge_Cuts.gbr, detect_rev1-F_Cu.gtl, detect_rev1-F_Mask.gts, detect_rev1-F_SilkS.gto, detect_rev1-NPTH.drl]
2017-03-15 Had missed vias in a couple of caps that needed to connect to ground. Fixed.
    [detect_rev1.kicad_pcb]
2017-03-15 Output after fixing the lack of two vias to connect caps to ground.
    [detect_rev1-B_Cu.gbl, detect_rev1-B_Mask.gbs, detect_rev1-B_SilkS.gbo, detect_rev1-Edge_Cuts.gbr, detect_rev1-F_Cu.gtl, detect_rev1-F_Mask.gts, detect_rev1-F_SilkS.gto, detect_rev1-NPTH.drl]
2017-09-15 Corrects the silkscreen present over pads
2017-09-15 Adds schematic library components needed for Snap rev1
2017-09-15 Adds layout footprints needed for snap rev1
2017-09-15 Snap rev 1 board's design
    [snap_rev1.kicad_pcb, snap_rev1.sch]
2017-09-15 Snap rev 1 board's output - schematic, BoM, gerbers, pics
    [snap_rev1-B.Cu.gbl, snap_rev1-B.Mask.gbs, snap_rev1-B.SilkS.gbo, snap_rev1-Edge.Cuts.gko, snap_rev1-F.Cu.gtl, snap_rev1-F.Mask.gts, snap_rev1-F.SilkS.gto, snap_rev1-NPTH.drl]
2017-10-11 Added errata for the first version of Snap rev 1 PCB
2017-10-11 Corrected the wrong labeling of the RGB Led pins in the schematic
    [snap_rev1.sch]
2017-10-17 Adds the issue of lack of means to measure the battery voltage
2017-10-20 Adds sense rev2 board design files
    [sense_rev2.kicad_pcb, sense_rev2.sch]
2017-10-20 Adds the full and half symbol and footprint of hackBLE
2017-10-20 Adds output of sense rev2 - gerber, schematic and 3D view
    [sense_rev2-B.Cu.gbl, sense_rev2-B.Mask.gbs, sense_rev2-B.SilkS.gbo, sense_rev2-Edge.Cuts.gko, sense_rev2-F.Cu.gtl, sense_rev2-F.Mask.gts, sense_rev2-F.SilkS.gto]
2017-10-22 Added the error of lack of correct ground planes for nRF52 module
2017-10-26 Adds a BoM to the output
    [sense_rev2_BoM.csv]
2017-10-26 Adds the datasheets the the symbols
    [sense_rev2.sch]
2017-11-01 New footprints needed for Snap rev2
2017-11-01 Audio jack 4 contact, 1 switch symbol added
2017-11-01 Updated TPS61098 to follow the KICAD convention
2017-11-01 Snap rev2's first revision containing only the schematic and component placements
    [snap_rev2.kicad_pcb, snap_rev2.sch]
2017-11-02 Added a BoM csv file
    [snap_rev2_BoM.csv]
2017-11-02 Adds a RGB LED with BRG sequence
2017-11-02 Snap rev2 updated with SMD switch, 5050 LED and bigger crystal
    [snap_rev2.kicad_pcb, snap_rev2.sch]
2017-11-03 Creates a spec document for the enclosure of Snap
2017-11-03 TPS boost regulator's filter's R value changed to common 390E and fixes the swapped out R and G's resistor value for the RGB LED.
    [snap_rev2.sch]
2017-11-03 Optimized the PCB to 55x22 mm^2
    [snap_rev2.kicad_pcb]
2017-11-03 Updated BoM. No 400E, but two 390E.
    [snap_rev2_BoM.csv]
2017-11-03 added _anool version
    [CapCeramic_0603.step, CapCeramic_0805.step, IR26.step, IR26_VSMB2020X01.step, IR26_VSMY2850RG.STEP, LED_SMD_APA102.step, MDBT42Q.step, PLCC_6_LED.step]
2017-11-03 Corrected the part number of the SMD tactile switch
    [snap_rev2.sch]
2017-11-03 changed RGB LED fp
    [battery_cover_AA_01.stl, battery_cover_AA_02.stl, sj2-35894b-smt.step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]
2017-11-03 changed push button fp
    [snap_rev2.kicad_pcb]
2017-11-04 added SMD switch 3D model
    [TL3304.step, snap_rev2.fcstd, snap_rev2.kicad_pcb, snap_rev2.sch, snap_rev2_pcb_BoM.csv, snap_rev2_sch_BoM.csv, sw_TL3304AFxxxQJ.stp]
2017-11-04 basic case sketch in fabricate folder
    [BATTERY_AA.step, snap_case.fcstd]
2017-11-04 enclosure WIP
    [snap_case.fcstd, snap_rev2.kicad_pcb]
2017-11-05 enclosure WIP2
    [nut_quarter_inch.stp, snap_case.fcstd]
2017-11-06 enclosure IR LED pending
    [LED-5-mm.step, snap_case.fcstd, snap_rev2.kicad_pcb]
2017-11-07 renamed rev2_anool to _rev3, shifted IR LED position
    [BATTERY_AA.step, CapCeramic_0603.step, CapCeramic_0805.step, IR26.step, IR26_VSMB2020X01.step, IR26_VSMY2850RG.STEP, LED-5-mm.step, LED_SMD_APA102.step]
2017-11-07 encloure WIP in fabricate folder
    [snap_case.fcstd]
2017-11-07 enclosure mods done. STL redy for printing
    [case_bot.stl, case_button.stl, case_mid.stl, case_top.stl, snap_case.fcstd, snap_rev3.kicad_pcb]
2017-11-10 Alligning contacts is different now in the programming connector
2017-11-10 Updated PCB with updated programming connector
    [snap_rev3.kicad_pcb]
2017-11-10 Gerber generated
    [snap_rev3-B.Cu.gbl, snap_rev3-B.Mask.gbs, snap_rev3-B.SilkS.gbo, snap_rev3-Edge.Cuts.gko, snap_rev3-F.Cu.gtl, snap_rev3-F.Mask.gts, snap_rev3-F.SilkS.gto]
2017-11-12 fixed errors in case design
    [case_bot.stl, case_button.stl, case_mid.stl, case_top.stl, snap_case.fcstd]
2017-11-30 New revision of Sense unit, sense_rev3
    [sense_rev3.kicad_pcb, sense_rev3.sch]
2017-12-01 Sense rev3's schematic is done
    [sense_rev3.sch]
2017-12-01 Adds datasheets to Sense rev3
    For AA holder, nRF52 MDBT42Q module, RGB LED, TL8802 OPAMP and TSM2301
2017-12-06 Created Logos for PCB files
    It includes .mod files for Appiko and Open Source Hardware logos to be used in PCB designs.
2017-12-06 Adds datasheets
    All datasheets added in their respective project folders.
    [MDBT42Q 2D Drawing-20170503.dwg, MDBT42Q 2D Drawing-20170503.dxf, MDBT42Q-P 2D Drawing-20170503.dwg, MDBT42Q-P 2D Drawing-20170503.dxf]
2017-12-06 Sense_rev3 PCB complete
    Completed the Schematics and PCB design for sense_rev3.
    Created project wise footprint and schematic libraries.
    [sense_rev3.kicad_pcb, sense_rev3.sch]
2017-12-08 Adds Gerber Files
    All Gerber files are ready to be sent to the PCB manufacturers.
    [sense_rev3-B.Cu.gbl, sense_rev3-B.Mask.gbs, sense_rev3-B.SilkS.gbo, sense_rev3-Edge.Cuts.gm1, sense_rev3-F.Cu.gtl, sense_rev3-F.Mask.gts, sense_rev3-F.SilkS.gto, sense_rev3-NPTH.drl]
2017-12-08 Updated footprints and other files
    .pretty files are updated as per the project.
    Added images of completed PCBs.
    Updated schematics (component names and values).
    [sense_rev3.kicad_pcb, sense_rev3.sch]
2017-12-08 Small changes in PCB
    Changed the crystal orientation,
    moved reference marking away from vias,
    moved the track too close to PIR_OUT in bottom layer.
    [sense_rev3-B.Cu.gbl, sense_rev3-B.Mask.gbs, sense_rev3-B.SilkS.gbo, sense_rev3-Edge.Cuts.gm1, sense_rev3-F.Cu.gtl, sense_rev3-F.Mask.gts, sense_rev3-F.SilkS.gto, sense_rev3-PTH.drl]
2017-12-14 Adds new datasheets & schematics
    -D204B PIR
    -KP506B PIR
    -T38G-32_768K12 Crystal
    -G366 enclosure
    -Sense_rev3 schematics files: with comments and explainations.
    [sense_rev3.sch]
2017-12-19 Adds new images
    New images for Enclosure Setup, Fresnel Lens and screenshots of Schematics.
2017-12-26 Updated BoM, Created gerber file pdf, renamed images
    [Sense_rev3_BoM.xlsx]
2018-01-06 revised enclosure design
    [snap_case2.fcstd, snap_rev2.kicad_pcb]
2018-01-18 snap_case_rev2 with changes and fresh STLs
    [case_bot.stl, case_button.stl, case_mid.stl, case_top.stl, snap_case.fcstd, snap_case2.fcstd, snap_case_rev2.fcstd, snap_case_rev2_bot.stl]
2018-01-18 snap_case_rev2 minor mod
    [snap_case_rev2.fcstd, snap_case_rev2_mid.stl]
2018-01-25 Adds Datasheets and Images
    Datasheets of PIR sensor and Fresnel Lenses
    Images of simulations and practical testing.
2018-02-20 Adds Sense_rev4 files
    [sense_rev4.kicad_pcb, sense_rev4.sch]
2018-02-21 Adds Schematics and PCB Layout files
    PCB routing completed.
    [sense_rev4.kicad_pcb, sense_rev4.sch]
2018-02-22 Updated PCB Routing
    PCB routing updated,
    Appiko, OSHW and KiCAD logos added.
    All component placement changed.
    [sense_rev4.kicad_pcb, sense_rev4.sch]
2018-02-27 Adds Datasheets
    Adding datasheets of all components used in sense_rev4.
    [MDBT42Q 2D Drawing-20170503.dwg, MDBT42Q 2D Drawing-20170503.dxf, MDBT42Q-P 2D Drawing-20170503.dwg, MDBT42Q-P 2D Drawing-20170503.dxf]
2018-02-27 Adds Library files
    Adding all schematic and footprint library files for all components used in sense_rev4
    [sense_rev4-2018-02-23-12-39-39.sch]
2018-02-27 Updates PCB files
    Added notes in schematic, and changes few references in PCB file.
    [sense_rev4.kicad_pcb, sense_rev4.sch]
2018-02-27 Adds Gerber files
    Generated all gerber and drill files for manufacturing.
    [sense_rev4-B.Cu.gbl, sense_rev4-B.Mask.gbs, sense_rev4-B.SilkS.gbo, sense_rev4-Edge.Cuts.gko, sense_rev4-F.Cu.gtl, sense_rev4-F.Mask.gts, sense_rev4-F.SilkS.gto, sense_rev4-NPTH.drl]
2018-02-28 Adds Images
    Adding images for documentation,
    also corrected a few reference values in the schematic.
    [sense_rev4.sch]
2018-03-01 Adds more Images
    Enclosure diagram, Block diagram, schematic update for Sense_rev4
2018-03-29 Fixes the interchanged CS and U/D pin connections between the nRF and MCP4012 in schematic
    [sense_rev4.sch]
2018-03-29 Corrects the missing schematic symbols and generates new pdf
    [sense_rev4.sch]
2018-04-10 Adds BOM
    created and added the BOM
    [sense_rev4_bom.csv]
2018-09-23 Inital commit of the SenseBe RX unit's schematic
    [senseBeRx_rev1.kicad_pcb, senseBeRx_rev1.sch]
2018-09-24 Update the part numbers of the components
    [senseBeRx_rev1.sch]
2018-09-25 Adds all necessary Footprint files and Datasheets, also completed Component placement on the PCB
    [MDBT42Q 2D Drawing-20170503.dwg, MDBT42Q 2D Drawing-20170503.dxf, MDBT42Q-P 2D Drawing-20170503.dwg, MDBT42Q-P 2D Drawing-20170503.dxf, senseBeRx_rev1.kicad_pcb, senseBeRx_rev1.sch]
2018-09-26 PCB Layout completed
    [senseBeRx_rev1.kicad_pcb]
2018-09-26 Silkscreen updated
    [senseBeRx_rev1.kicad_pcb]
2018-09-26 Adds Appiko Logo in the Silkscreen, and Gerber files for manufacturing
    [senseBeRx_rev1-B.Cu.gbr, senseBeRx_rev1-B.Mask.gbr, senseBeRx_rev1-B.Paste.gbr, senseBeRx_rev1-B.SilkS.gbr, senseBeRx_rev1-Edge.Cuts.gbr, senseBeRx_rev1-F.Cu.gbr, senseBeRx_rev1-F.Mask.gbr, senseBeRx_rev1-F.Paste.gbr]
2018-09-28 Add V1 label on silkscreen
    [senseBeRx_rev1.kicad_pcb]
2018-09-28 Generate the gerber according to Lion's format
    [senseBeRx_rev1-B.Cu.gbl, senseBeRx_rev1-B.Mask.gbs, senseBeRx_rev1-B.Paste.gbr, senseBeRx_rev1-B.SilkS.gbo, senseBeRx_rev1-Edge.Cuts.gko, senseBeRx_rev1-F.Cu.gtl, senseBeRx_rev1-F.Mask.gts, senseBeRx_rev1-F.Paste.gbr]
2018-10-03 Adds Schematic file in pdf format
2018-10-03 Adds 'senseBeTx_rev1' PCB design files, with seneBeTx_rev1 schematics completed.
    [senseBeTx_rev1.kicad_pcb, senseBeTx_rev1.sch]
2018-10-03 Adds Schematic file in pdf.
2018-10-03 Adds notes and proper labeling of Schematic smybols, and PCB Placement of components completed.
    [senseBeTx_rev1.kicad_pcb, senseBeTx_rev1.sch]
2018-10-04 Adds schematic files with minor changes, completed PCB files, and Gerber files for manufacturing
    [senseBeTx_rev1-B.Cu.gbl, senseBeTx_rev1-B.Mask.gbs, senseBeTx_rev1-B.Paste.gbp, senseBeTx_rev1-B.SilkS.gbo, senseBeTx_rev1-Edge.Cuts.gm1, senseBeTx_rev1-F.Cu.gtl, senseBeTx_rev1-F.Mask.gts, senseBeTx_rev1-F.Paste.gtp]
2018-10-04 LED in the design is changed to part no. KPTBD-3216SURKCGKC, updated in schematic and PCB
    [senseBeTx_rev1-B.Cu.gbl, senseBeTx_rev1-B.Mask.gbs, senseBeTx_rev1-B.Paste.gbp, senseBeTx_rev1-B.SilkS.gbo, senseBeTx_rev1-Edge.Cuts.gm1, senseBeTx_rev1-F.Cu.gtl, senseBeTx_rev1-F.Mask.gts, senseBeTx_rev1-F.Paste.gtp]
2018-10-17 Power Calculation related snaps.
    These snaps are supposed to be part of wiki page for senseRev4
2018-10-23 Do power calculations for trigger with LED feedback in proper mode
2018-10-25 Add user manual for STM32L0xx
2018-11-27 Adds Sense Beam rev2 folders
    [MDBT42Q 2D Drawing-20170503.dwg, MDBT42Q 2D Drawing-20170503.dxf, MDBT42Q-P 2D Drawing-20170503.dwg, MDBT42Q-P 2D Drawing-20170503.dxf, senseBeRx_rev2.kicad_pcb, senseBeRx_rev2.sch, senseBeTx_rev2.kicad_pcb, senseBeTx_rev2.sch]
2018-11-28 Adds Schematic and PCB Files of SenseBe rev2
    [senseBeRx_rev2.kicad_pcb, senseBeTx_rev2.kicad_pcb, senseBeTx_rev2.sch]
2018-11-29 Adds all SenseBe_RX and _TX updated PCB, Schematic and Gerber files
    [senseBeRx_rev2-B.Cu.gbl, senseBeRx_rev2-B.Mask.gbs, senseBeRx_rev2-B.SilkS.gbo, senseBeRx_rev2-Edge.Cuts.gm1, senseBeRx_rev2-F.Cu.gtl, senseBeRx_rev2-F.Mask.gts, senseBeRx_rev2-F.SilkS.gto, senseBeRx_rev2.drl]
2018-12-01 Adds SenseBe_RX gerber files, with discussed updates
    [senseBeRx_rev2-B.Cu.gbl, senseBeRx_rev2-B.Mask.gbs, senseBeRx_rev2-B.SilkS.gbo, senseBeRx_rev2-Edge.Cuts.gm1, senseBeRx_rev2-F.Cu.gtl, senseBeRx_rev2-F.Mask.gts, senseBeRx_rev2-F.SilkS.gto, senseBeRx_rev2.drl]
2018-12-01 Adds SenseBe_TX gerber files, with discussed updates
    [senseBeTx_rev2-B.Cu.gbl, senseBeTx_rev2-B.Mask.gbs, senseBeTx_rev2-B.Paste.gbp, senseBeTx_rev2-B.SilkS.gbo, senseBeTx_rev2-Edge.Cuts.gm1, senseBeTx_rev2-F.Cu.gtl, senseBeTx_rev2-F.Mask.gts, senseBeTx_rev2-F.Paste.gtp]
2018-12-03 Changes UART TX, RX pins, and routing corrections
    [senseBeRx_rev2.kicad_pcb, senseBeRx_rev2.sch]
2018-12-03 Changes Appiko Logo Position
    [senseBeRx_rev2.kicad_pcb]
2018-12-03 Update the PCB to reduce the number of vias and add top layer copper
    [senseBeTx_rev2.kicad_pcb]
2018-12-03 Updated gerber generated
    [senseBeTx_rev2-B.Cu.gbl, senseBeTx_rev2-B.Mask.gbs, senseBeTx_rev2-B.Paste.gbp, senseBeTx_rev2-B.SilkS.gbo, senseBeTx_rev2-Edge.Cuts.gko, senseBeTx_rev2-F.Cu.gtl, senseBeTx_rev2-F.Mask.gts, senseBeTx_rev2-F.Paste.gtp]
2018-12-03 Removes R10(pull up for audio jack), and Adds updated Gerber files
    [senseBeRx_rev2-B.Cu.gbl, senseBeRx_rev2-B.Mask.gbs, senseBeRx_rev2-B.SilkS.gbo, senseBeRx_rev2-Edge.Cuts.gm1, senseBeRx_rev2-F.Cu.gtl, senseBeRx_rev2-F.Mask.gts, senseBeRx_rev2-F.SilkS.gto, senseBeRx_rev2.drl]
2018-12-03 Adds GND Keepout layer on Cu.F in nRF footprint
    [senseBeRx_rev2-B.Cu.gbl, senseBeRx_rev2-B.Mask.gbs, senseBeRx_rev2-B.SilkS.gbo, senseBeRx_rev2-Edge.Cuts.gm1, senseBeRx_rev2-F.Cu.gtl, senseBeRx_rev2-F.Mask.gts, senseBeRx_rev2-F.SilkS.gto, senseBeRx_rev2.drl]
2018-12-28 Corrected Pogo Prog GND pin connections
    [senseBeRx_rev2.kicad_pcb, senseBeRx_rev2.sch]
2018-12-28 Adds SenseBeam Rx rev3 files
    [MDBT42Q 2D Drawing-20170503.dwg, MDBT42Q 2D Drawing-20170503.dxf, MDBT42Q-P 2D Drawing-20170503.dwg, MDBT42Q-P 2D Drawing-20170503.dxf]
2018-12-31 Schematic of the AP3403 test circuitry is done
    [Ap3403_LED_test.kicad_pcb, Ap3403_LED_test.sch]
2019-01-02 PCB Files completed, ready to manufacture.
    [Ap3403_LED_test-B.Cu.gbl, Ap3403_LED_test-B.Mask.gbs, Ap3403_LED_test-B.Paste.gbp, Ap3403_LED_test-B.SilkS.gbo, Ap3403_LED_test-Edge.Cuts.gm1, Ap3403_LED_test-F.Cu.gtl, Ap3403_LED_test-F.Mask.gts, Ap3403_LED_test-F.Paste.gtp]
2019-01-07 Adds SenseBeRx_rev3 PCB files, with 3D STEP files included.
    [Button_TC-1101T-C-A-B.step, C5404_AAx2_Battery_Holder.step, KPTBD-3216SURKCGKC.step, PJ-32434_3-5mmAudioJack.step, RX_TSSP4056.step, nRF-MDBT42Q.step, senseBeRx_rev3.kicad_pcb, senseBeRx_rev3.sch]
2019-01-10 Changes PCB Placement, and Adds connector for AA batteries and On-Off Switch.
    [SenseBeRx_3DModel.fcstd, SlideSwitch_1P2T_RightAngle.step, senseBeRx_rev3.kicad_pcb, senseBeRx_rev3.sch]
2019-01-16 3D .STEP files updated as per PCB placement.
    [SenseBeRx_3DModel.fcstd]
2019-01-24 Adds updated PCB 3D files
    [SenseBeRx_3DModel.fcstd]
2019-01-24 Adds senseBeTx_rev3 PCB design files.
    [senseBeTx_rev3.kicad_pcb, senseBeTx_rev3.sch]
2019-01-25 Adds SenseBeTx_rev2 schematic symbol library.
2019-01-25 Done corrections in schematic.
    [senseBeTx_rev3.sch]
2019-01-28 Updates PCB placement.
    [Button_TC-1101T-C-A-B.step, C5404_AAx2_Battery_Holder.step, SlideSwitch_1P2T_RightAngle.step, senseBeTx_rev3.kicad_pcb, senseBeTx_rev3.sch]
2019-01-30 Updates the local libraries.
    [18-225_R6G6C-A01_3T.step, senseBeRx_rev3.kicad_pcb, senseBeRx_rev3.sch, senseBeTx_rev3.kicad_pcb, senseBeTx_rev3.sch]
2019-01-31 Updates Schematic libraries.
    [senseBeRx_rev3.sch]
2019-02-05 Adds senseBe_rev1 Design files.
    [18-225_R6G6C-A01_3T.step, Button_TC-1101T-C-A-B.step, C5404_AAx2_Battery_Holder.step, KPTBD-3216SURKCGKC.step, MDBT42Q 2D Drawing-20170503.dwg, MDBT42Q 2D Drawing-20170503.dxf, MDBT42Q-P 2D Drawing-20170503.dwg, MDBT42Q-P 2D Drawing-20170503.dxf]
2019-02-05 Completes Schematic and PCB Design.
    [senseBe_Tx.sch, senseBe_rev1.kicad_pcb, senseBe_rev1.sch]
2019-02-05 SenseBe rev1 gerber files
    [senseBe_rev1-B.Cu.gbl, senseBe_rev1-B.Mask.gbs, senseBe_rev1-B.SilkS.gbo, senseBe_rev1-Edge.Cuts.gko, senseBe_rev1-F.Cu.gtl, senseBe_rev1-F.Mask.gts, senseBe_rev1-F.SilkS.gto, senseBe_rev1-NPTH.drl]
2019-02-05 Remove pins for battery as switch is connecting point
2019-02-05 Change dual LED pin connection, battery symbol now pinless
    [senseBe_rev1.sch]
2019-02-05 Device battery to SenseBe library
2019-02-05 Ref designators, keepouts, pour gnd, switch gnd corrected. Dual LED overlapping now.
    [senseBe_rev1.kicad_pcb]
2019-02-05 Minor changes after gerber creation
    [senseBe_rev1.kicad_pcb]
2019-02-06 Adds 3D STEP file of the PCB.
2019-02-19 Adds New project senseBe_rev2
    [18-225_R6G6C-A01_3T.step, Button_TC-1101T-C-A-B.step, C5404_AAx2_Battery_Holder.step, MDBT42Q 2D Drawing-20170503.dwg, MDBT42Q 2D Drawing-20170503.dxf, MDBT42Q-P 2D Drawing-20170503.dwg, MDBT42Q-P 2D Drawing-20170503.dxf, PJ-32434_3-5mmAudioJack.step]
2019-02-20 Adds PCB Design and Gerber files.
    [senseBe_Tx.sch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]
2019-02-20 Gerber file location corrected.
    [senseBe_rev2-B.Cu.gbl, senseBe_rev2-B.Mask.gbs, senseBe_rev2-B.Paste.gbp, senseBe_rev2-B.SilkS.gbo, senseBe_rev2-Edge.Cuts.gm1, senseBe_rev2-F.Cu.gtl, senseBe_rev2-F.Mask.gts, senseBe_rev2-F.Paste.gtp]
2019-02-21 senseBe_rev2 PCB and Gerber files modified.
    [senseBe_Tx.sch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]
2019-02-22 Swap the 1 and 2 pin of Molex connector
2019-02-22 Minor changes of fixing the power Molex connector and traces to Dual MOSFET's SOT963 package.
    [senseBe_Tx.sch, senseBe_rev2.kicad_pcb, senseBe_rev2.sch]
2019-02-22 Rev 2 gerber files
    [senseBe_rev2-B.Cu.gbl, senseBe_rev2-B.Mask.gbs, senseBe_rev2-B.Paste.gbp, senseBe_rev2-B.SilkS.gbo, senseBe_rev2-Edge.Cuts.gko, senseBe_rev2-F.Cu.gtl, senseBe_rev2-F.Mask.gts, senseBe_rev2-F.Paste.gtp]
2019-04-11 Adds senseBe_rev3
    senseBe_rev3 PCB design files added
    [18-225_R6G6C-A01_3T.step, 5mm_LED.step, Button_TC-1101T-C-A-B.step, C5404_AAx2_Battery_Holder.step, JTAG Conn 2x5 F.step, JTAG Conn 2x5.step, MDBT42Q 2D Drawing-20170503.dwg, MDBT42Q 2D Drawing-20170503.dxf]
2019-04-11 Add marking for Tx and Rx regions, add Appiko Logo and revision name
    [senseBe_rev3_main.kicad_pcb]
2019-04-11 Added OSHW logo and moved Appiko Logo
    [senseBe_rev3_main.kicad_pcb]
2019-04-11 Gerber files generated
    Ready to manufacture.
    [JTAG Conn 2x5.step, RIght Angle_Tactile_Push_Button.step, Stereo Socket 3.5mm SMD.step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]
2019-06-24 Schematic and Footprint Libraries Updated
    Use the following .lib file for all schematic designs of Appiko: Appiko\sense_snap_hw\kicad_lib\sense_sch\sense.lib
    And, use Footprints from the folder:
    Appiko\sense_snap_hw\kicad_lib\sense_fp.pretty
2019-06-24 senseBe_rev4 and sense_rev5 project started
    [MDBT42Q 2D Drawing-20170503.dwg, MDBT42Q 2D Drawing-20170503.dxf, MDBT42Q-P 2D Drawing-20170503.dwg, MDBT42Q-P 2D Drawing-20170503.dxf, SensePi_rev5_main.kicad_pcb, SensePi_rev5_main.sch, senseBe_Tx.sch, senseBe_rev4_daughter.kicad_pcb]
2019-06-24 senseEle_rev1 project started
    Contains hardware design files for long distance RF Communication Alert system.
    [CC1120.sch, CC1190.sch, Power Supply.sch, nRF_Module.sch, senseEle_rev1.kicad_pcb, senseEle_rev1.sch]
2019-07-01 PJ_611_5A_Audio Jack footprint added
2019-07-01 sense_rev5 PCB Design files completed.
    [SensePi_rev5_main.kicad_pcb, SensePi_rev5_main.sch]
2019-07-01 senseBe_rev4 Schematic files completed.
    [senseBe_Tx.sch, senseBe_rev4_daughter.kicad_pcb, senseBe_rev4_daughter.sch, senseBe_rev4_main.sch]
2019-07-17 "AR0135_adapter_rev1" PCB Files
    AR0135_adapter_rev1 is an adapter board connecting OpenMV board with ArduCam image sensor.
    [541323062.stp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]
2019-07-18 Appiko logo added on Silk screen
    [AR0135_adapter_rev1-B_Cu.gbl, AR0135_adapter_rev1-B_Mask.gbs, AR0135_adapter_rev1-B_Paste.gbp, AR0135_adapter_rev1-B_SilkS.gbo, AR0135_adapter_rev1-Edge_Cuts.gm1, AR0135_adapter_rev1-F_Cu.gtl, AR0135_adapter_rev1-F_Mask.gts, AR0135_adapter_rev1-F_Paste.gtp]
2019-07-31 renamed "AR0135_adapter_rev1" to "AR0135_OpenMV_adapter_rev1"
    [541323062.stp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]
2019-07-31 AR0135_STM32F746G-DISCO_adapter_rev1
    AR0135_STM32F746G-DISCO_adapter_rev1 PCB Design Files
    [AR0135_STM32F746G-DISCO_adapter_rev1.kicad_pcb, AR0135_STM32F746G-DISCO_adapter_rev1.sch]
2019-07-31 Gerber files generated
    [AR0135_STM32F746G-DISCO_adapter_rev1-B.Cu.gbl, AR0135_STM32F746G-DISCO_adapter_rev1-B.Mask.gbs, AR0135_STM32F746G-DISCO_adapter_rev1-B.Paste.gbp, AR0135_STM32F746G-DISCO_adapter_rev1-B.SilkS.gbo, AR0135_STM32F746G-DISCO_adapter_rev1-Edge.Cuts.gm1, AR0135_STM32F746G-DISCO_adapter_rev1-F.Cu.gtl, AR0135_STM32F746G-DISCO_adapter_rev1-F.Mask.gts, AR0135_STM32F746G-DISCO_adapter_rev1-F.Paste.gtp]
2019-08-01 updated J2 footprint
    [AR0135_STM32F746G-DISCO_adapter_rev1-B_Cu.gbl, AR0135_STM32F746G-DISCO_adapter_rev1-B_Mask.gbs, AR0135_STM32F746G-DISCO_adapter_rev1-B_Paste.gbp, AR0135_STM32F746G-DISCO_adapter_rev1-B_SilkS.gbo, AR0135_STM32F746G-DISCO_adapter_rev1-Edge_Cuts.gm1, AR0135_STM32F746G-DISCO_adapter_rev1-F_Cu.gtl, AR0135_STM32F746G-DISCO_adapter_rev1-F_Mask.gts, AR0135_STM32F746G-DISCO_adapter_rev1-F_Paste.gtp]
2019-08-12 STC2SA_driver_rev1
    STC2SA_driver_rev1 PCB Files created.
    [STCS2A_driver_rev1.kicad_pcb, STCS2A_driver_rev1.sch]
2019-08-13 Add symbols for parts of XHP70.2, 2-jumper-open, PMOS, Didoe, connectors and capacitors
2019-08-13 Add pin 11 for pad
2019-08-13 Finished STCS2A driver board
    [STCS2A_driver_rev1.kicad_pcb, STCS2A_driver_rev1.sch]
2019-08-13 Gerber files for STCS2A board
    [STCS2A_driver_rev1-B_Cu.gbl, STCS2A_driver_rev1-B_Mask.gbs, STCS2A_driver_rev1-B_SilkS.gbo, STCS2A_driver_rev1-Edge_Cuts.gm1, STCS2A_driver_rev1-F_Cu.gtl, STCS2A_driver_rev1-F_Mask.gts, STCS2A_driver_rev1-F_SilkS.gto, STCS2A_driver_rev1-NPTH.drl]
2019-08-13 XGP70.2 breakout board added
    [XHP70.2_breakout-B_Cu.gbr, XHP70.2_breakout-B_Mask.gbr, XHP70.2_breakout-B_SilkS.gbr, XHP70.2_breakout-Edge_Cuts.gbr, XHP70.2_breakout-F_Cu.gbr, XHP70.2_breakout-F_Mask.gbr, XHP70.2_breakout-F_SilkS.gbr, XHP70.2_breakout-NPTH.drl]
2019-08-13 Add footprints to the sense_fp pretty
2019-08-16 SFH4715AS_breakout PCB Files
    [SFH4715AS_breakout-B_Cu.gbl, SFH4715AS_breakout-B_Mask.gbs, SFH4715AS_breakout-B_Paste.gbp, SFH4715AS_breakout-B_SilkS.gbo, SFH4715AS_breakout-Edge_Cuts.gm1, SFH4715AS_breakout-F_Cu.gtl, SFH4715AS_breakout-F_Mask.gts, SFH4715AS_breakout-F_Paste.gtp]
2019-08-16 Update PCB and gerber files with moved silk screen designators, board name and thicker traces
    [SFH4715AS_breakout-B_Cu.gbl, SFH4715AS_breakout-B_Mask.gbs, SFH4715AS_breakout-B_Paste.gbp, SFH4715AS_breakout-B_SilkS.gbo, SFH4715AS_breakout-Edge_Cuts.gm1, SFH4715AS_breakout-F_Cu.gtl, SFH4715AS_breakout-F_Mask.gts, SFH4715AS_breakout-F_Paste.gtp]
2019-08-19 First commit of the Xenon flash circuitry
    [Xenon_flash_5V.kicad_pcb, Xenon_flash_5V.sch]
2019-08-19 Unsaved changes to flash circuitry updated
    [Xenon_flash_5V.sch]
2019-08-20 senseCam_Adapter_rev1
    senseCam_Adapter_rev1 schematics and PCB files.
    [senseCam_Adapter_rev1.kicad_pcb, senseCam_Adapter_rev1.sch]
2019-08-23 XHP70.2_breakout_rev2 PCB files
    [XHP70.2_breakout_rev2-B_Cu.gbl, XHP70.2_breakout_rev2-B_Mask.gbs, XHP70.2_breakout_rev2-B_Paste.gbp, XHP70.2_breakout_rev2-B_SilkS.gbo, XHP70.2_breakout_rev2-Edge_Cuts.gm1, XHP70.2_breakout_rev2-F_Cu.gtl, XHP70.2_breakout_rev2-F_Mask.gts, XHP70.2_breakout_rev2-F_Paste.gtp]
2019-08-23 Update the Gerbers of v2 XHP70.2 breakout with continuous thermal pad
    [XHP70.2_breakout_rev2-B_Cu.gbl, XHP70.2_breakout_rev2-B_Mask.gbs, XHP70.2_breakout_rev2-B_Paste.gbp, XHP70.2_breakout_rev2-B_SilkS.gbo, XHP70.2_breakout_rev2-Edge_Cuts.gm1, XHP70.2_breakout_rev2-F_Cu.gtl, XHP70.2_breakout_rev2-F_Mask.gts, XHP70.2_breakout_rev2-F_Paste.gtp]
2019-08-27 Update the schematic with local library's parts
    [AR0135_STM32F746G-DISCO_adapter_rev1.sch]
2019-08-27 New footprints added to local library
2019-08-27 SenseCam adapter board done
    [senseCam_Adapter_rev1.kicad_pcb]
2019-08-27 Gerber files for SenseCam adapter
    [senseCam_Adapter_rev1-B_Cu.gbl, senseCam_Adapter_rev1-B_Mask.gbs, senseCam_Adapter_rev1-B_Paste.gbp, senseCam_Adapter_rev1-B_SilkS.gbo, senseCam_Adapter_rev1-Edge_Cuts.gm1, senseCam_Adapter_rev1-F_Cu.gtl, senseCam_Adapter_rev1-F_Mask.gts, senseCam_Adapter_rev1-F_Paste.gtp]
2019-08-27 Update the PCB with change in
    - battery connector, buffer cap and reverse polarity protection MOSFET
    - SenseBe connector orientation
    [senseCam_Adapter_rev1-B_Cu.gbl, senseCam_Adapter_rev1-B_Mask.gbs, senseCam_Adapter_rev1-B_Paste.gbp, senseCam_Adapter_rev1-B_SilkS.gbo, senseCam_Adapter_rev1-Edge_Cuts.gm1, senseCam_Adapter_rev1-F_Cu.gtl, senseCam_Adapter_rev1-F_Mask.gts, senseCam_Adapter_rev1-F_Paste.gtp]
2019-08-27 Increase the size of PAD for STCS2A to cover the through hole vias
2019-08-27 Move the LED connector a bit to the corner
    [senseCam_Adapter_rev1-B_Cu.gbl, senseCam_Adapter_rev1-B_Mask.gbs, senseCam_Adapter_rev1-B_Paste.gbp, senseCam_Adapter_rev1-B_SilkS.gbo, senseCam_Adapter_rev1-Edge_Cuts.gm1, senseCam_Adapter_rev1-F_Cu.gtl, senseCam_Adapter_rev1-F_Mask.gts, senseCam_Adapter_rev1-F_Paste.gtp]
2019-08-28 Add the pdf of the schematic
2019-08-28 Update the schematic with documentation
    [senseCam_Adapter_rev1.sch]
2019-09-03 Add power regulators, STM32H750VB and pwr pins
2019-09-03 Initial commit of SenseCam Rev1. Only power and main stm32 placement is done.
    [SenseCam_rev1.kicad_pcb, SenseCam_rev1.sch]
2019-09-04 Hierarchical schematic design in progress
    [ArduCam_SDcard.sch, H7_pins.sch, SenseCam_rev1.sch, power.sch]
2019-09-06 Lots of footprints added for SenseCam
2019-09-08 80% routing done on Sense Cam rev1
    [ArduCam_SDcard.sch, H7_pins.sch, SenseCam_rev1.kicad_pcb, SenseCam_rev1.sch, power.sch]
2019-09-09 Final PCB for production
    [H7_pins.sch, SenseCam_rev1.kicad_pcb]
2019-09-09 Gerbers sent for production
    [SenseCam_rev1-B_Cu.gbl, SenseCam_rev1-B_Mask.gbs, SenseCam_rev1-B_Paste.gbp, SenseCam_rev1-B_SilkS.gbo, SenseCam_rev1-Edge_Cuts.gm1, SenseCam_rev1-F_Cu.gtl, SenseCam_rev1-F_Mask.gts, SenseCam_rev1-F_Paste.gtp]
2019-09-11 Board for the flash driver of SenseCam
    [SenseCam_STCS2A_rev1.kicad_pcb, SenseCam_STCS2A_rev1.sch]
2019-09-11 SenseCam_XHP70.2_rev1 PCB design files
    [SenseCam_XHP70.2_rev1.kicad_pcb, SenseCam_XHP70.2_rev1.sch]
2019-09-12 Add gerbers
    [SenseCam_XHP70.2_rev1-B_Cu.gbl, SenseCam_XHP70.2_rev1-B_Mask.gbs, SenseCam_XHP70.2_rev1-B_SilkS.gbo, SenseCam_XHP70.2_rev1-Edge_Cuts.gm1, SenseCam_XHP70.2_rev1-F_Cu.gtl, SenseCam_XHP70.2_rev1-F_Mask.gts, SenseCam_XHP70.2_rev1-F_SilkS.gto, SenseCam_XHP70.2_rev1-NPTH.drl]
2019-09-12 SenseCam_SFH4715AS_rev1 PCB design files
    [SenseCam_SFH4715AS_rev1-B_Cu.gbl, SenseCam_SFH4715AS_rev1-B_Mask.gbs, SenseCam_SFH4715AS_rev1-B_Paste.gbp, SenseCam_SFH4715AS_rev1-B_SilkS.gbo, SenseCam_SFH4715AS_rev1-Edge_Cuts.gm1, SenseCam_SFH4715AS_rev1-F_Cu.gtl, SenseCam_SFH4715AS_rev1-F_Mask.gts, SenseCam_SFH4715AS_rev1-F_Paste.gtp]
2019-09-12 Add silkscreen stuff and fix a copper pour
    [SenseCam_SFH4715AS_rev1-B_Cu.gbl, SenseCam_SFH4715AS_rev1-B_Mask.gbs, SenseCam_SFH4715AS_rev1-B_Paste.gbp, SenseCam_SFH4715AS_rev1-B_SilkS.gbo, SenseCam_SFH4715AS_rev1-Edge_Cuts.gm1, SenseCam_SFH4715AS_rev1-F_Cu.gtl, SenseCam_SFH4715AS_rev1-F_Mask.gts, SenseCam_SFH4715AS_rev1-F_Paste.gtp]
2019-09-24 Added NCs for non connected pins and clarified the ref designators
    [H7_pins.sch]
2019-09-24 Added the pdf of the schematic
2019-10-02 senseBe_rev4 and sense_rev5 schematic and PCB placement done.
    PCB placement for all major components that affect the mechanical enclosure design is done, and locked.
    [SensePi_rev5_main.kicad_pcb, SensePi_rev5_main.sch, senseBe_Tx.sch, senseBe_rev4_main.kicad_pcb, senseBe_rev4_main.sch]
2019-10-03 BOM updated
    [SensePi_rev5_main.xlsx, senseBe_rev4_main.xlsx]
2019-10-14 Rev 5 of SensePi board final
    [SensePi_rev5_main.kicad_pcb]
2019-10-14 Gerber of SensePi rev5
    [SensePi_rev5_main-B_Cu.gbl, SensePi_rev5_main-B_Mask.gbs, SensePi_rev5_main-B_SilkS.gbo, SensePi_rev5_main-Edge_Cuts.gm1, SensePi_rev5_main-F_Cu.gtl, SensePi_rev5_main-F_Mask.gts, SensePi_rev5_main-F_SilkS.gto, SensePi_rev5_main-NPTH.drl]
2019-10-16 senseBe_rev4 PCB layout done.
    [senseBe_Tx.sch, senseBe_rev4_main.kicad_pcb, senseBe_rev4_main.sch, senseBe_rev4_main.xlsx]
2019-10-16 Gerbers sent for manuf
    [senseBe_rev4_main-B_Cu.gbl, senseBe_rev4_main-B_Mask.gbs, senseBe_rev4_main-B_SilkS.gbo, senseBe_rev4_main-Edge_Cuts.gm1, senseBe_rev4_main-F_Cu.gtl, senseBe_rev4_main-F_Mask.gts, senseBe_rev4_main-F_SilkS.gto, senseBe_rev4_main-NPTH.drl]
2019-10-16 Add the RTC in the schematic and PCB
    [senseBe_rev4_main.kicad_pcb]
2019-10-16 Update schematic pdf
2019-10-17 fix in schematic and gerber files regenerated.
    VDD to Buck regulator connection was missing.
    [senseBe_Tx.sch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]
2019-10-17 Schematic updated.
    [senseBe_Tx.sch, senseBe_rev4_main.sch]
2019-10-22 LED and LDR positions changed on PCB.
    [senseBe_Tx.sch, senseBe_rev4_main.kicad_pcb, senseBe_rev4_main.sch]
2019-10-23 SenseEle Schematic finished
2019-10-23 Updated schematic with VDD control for PIR and LDR, and additional test points
    [SensePi_rev5_main.sch]
2019-10-23 Updated PCB with VDD control of LDR and PIR circuitry
    [SensePi_rev5_main.kicad_pcb]
2019-10-23 Updated Gerber files
    [SensePi_rev5_main-B_Cu.gbl, SensePi_rev5_main-B_Mask.gbs, SensePi_rev5_main-B_SilkS.gbo, SensePi_rev5_main-Edge_Cuts.gm1, SensePi_rev5_main-F_Cu.gtl, SensePi_rev5_main-F_Mask.gts, SensePi_rev5_main-F_SilkS.gto, SensePi_rev5_main-NPTH.drl]
2019-10-24 PCB antenna
2019-10-25 senseEle_rev1 and senseEle_PCB_Antenna_rev1 PCB Designs updated.
    [CC1120.sch, CC1190.sch, Power Supply.sch, nRF_Module.sch, senseEle_PCB_Antenna_rev1.kicad_pcb, senseEle_PCB_Antenna_rev1.sch]
2019-10-26 routing done.
    [senseEle_PCB_Antenna_rev1.kicad_pcb]
2019-10-30 Update gerbers of SenseBe_rev4
    [senseBe_rev4_main-B_Cu.gbl, senseBe_rev4_main-B_Mask.gbs, senseBe_rev4_main-B_SilkS.gbo, senseBe_rev4_main-Edge_Cuts.gm1, senseBe_rev4_main-F_Cu.gtl, senseBe_rev4_main-F_Mask.gts, senseBe_rev4_main-F_SilkS.gto, senseBe_rev4_main-NPTH.drl]
2019-10-30 Revamped SenseBe rev4 with fixes to the LED LDR placement
    [senseBe_Tx.sch, senseBe_rev4_main.kicad_pcb, senseBe_rev4_main.sch]
2019-10-30 First version of SenseEle SMA PCB
    [CC1120.sch, Power Supply.sch, nRF_Module.sch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]
2019-10-30 Removed the generic SenseEle Project
    [CC1120.sch, CC1190.sch, Power Supply.sch, nRF_Module.sch, senseEle_rev1.kicad_pcb, senseEle_rev1.sch]
2019-11-05 senseEle_SMA_rev1 BoM updated
    [senseEle_SMA_rev1.xlsx]
2019-11-06 Add the DN024 antenna with taper
2019-11-06 Correct component values
    [senseBe_Tx.sch]
2019-11-06 Update SenseEle PCB antenna design with tapered antenna
    [CC1120.sch, nRF_Module.sch, senseEle_PCB_Antenna_rev1.kicad_pcb, senseEle_PCB_Antenna_rev1.sch]
2019-11-09 Gerber of PCB antenna SenseEle
    [senseEle_PCB_Antenna_rev1-B_Cu.gbl, senseEle_PCB_Antenna_rev1-B_Mask.gbs, senseEle_PCB_Antenna_rev1-B_SilkS.gbo, senseEle_PCB_Antenna_rev1-Edge_Cuts.gm1, senseEle_PCB_Antenna_rev1-F_Cu.gtl, senseEle_PCB_Antenna_rev1-F_Mask.gts, senseEle_PCB_Antenna_rev1-F_SilkS.gto, senseEle_PCB_Antenna_rev1-NPTH.drl]
2019-11-09 Updated the Schematic
2019-11-09 Update of the PCB
    [senseEle_PCB_Antenna_rev1.kicad_pcb]
2019-11-11 senseEle_PCB_Antenna_rev1 Gerber files ready.
    [nRF_Module.sch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]
2019-11-14 Remove the solder mask from the antenna part
2019-11-14 Update gerbers of SenseBe rev4
    [senseBe_rev4_main-B_Cu.gbl, senseBe_rev4_main-B_Mask.gbs, senseBe_rev4_main-B_SilkS.gbo, senseBe_rev4_main-Edge_Cuts.gm1, senseBe_rev4_main-F_Cu.gtl, senseBe_rev4_main-F_Mask.gts, senseBe_rev4_main-F_SilkS.gto, senseBe_rev4_main-NPTH.drl]
2019-11-14 Update SenseBe rev4 with minor fixes
    [senseBe_Tx.sch, senseBe_rev4_main.kicad_pcb, senseBe_rev4_main.sch]
2019-11-14 Gerber after Fix of power switch GND connection and other minor fixes
    [SensePi_rev5_main-B_Cu.gbl, SensePi_rev5_main-B_Mask.gbs, SensePi_rev5_main-B_SilkS.gbo, SensePi_rev5_main-Edge_Cuts.gm1, SensePi_rev5_main-F_Cu.gtl, SensePi_rev5_main-F_Mask.gts, SensePi_rev5_main-F_SilkS.gto, SensePi_rev5_main-NPTH.drl]
2019-11-14 Fix power switch GND conn and other minor fixes
    [SensePi_rev5_main.kicad_pcb, SensePi_rev5_main.sch]
2019-11-19 senseBe_rev4 and sense_rev5 gerber files updated.
    senseBe_rev4 and sense_rev5 Slider switch footprint updated, sense_rev5 LDR resister position changed.
    [SensePi_rev5_main-B_Cu.gbl, SensePi_rev5_main-B_Mask.gbs, SensePi_rev5_main-B_SilkS.gbo, SensePi_rev5_main-Edge_Cuts.gm1, SensePi_rev5_main-F_Cu.gtl, SensePi_rev5_main-F_Mask.gts, SensePi_rev5_main-F_SilkS.gto, SensePi_rev5_main-NPTH.drl]
2019-11-19 Changed the missed RX pin reassignment in schematic
    [nRF_Module.sch]
2019-11-19 SensePi design for two digit quantity order
    [SensePi_rev5_main-B_Cu.gbl, SensePi_rev5_main-B_Mask.gbs, SensePi_rev5_main-B_Paste.gbp, SensePi_rev5_main-B_SilkS.gbo, SensePi_rev5_main-Edge_Cuts.gm1, SensePi_rev5_main-F_Cu.gtl, SensePi_rev5_main-F_Mask.gts, SensePi_rev5_main-F_Paste.gtp]
2019-11-19 Design sent for rev5_2 maufacturing
    [SensePi_rev5_main.kicad_pcb]
2019-11-19 SenseBe manuf gerber files
    [senseBe_rev4_main-B_Cu.gbl, senseBe_rev4_main-B_Mask.gbs, senseBe_rev4_main-B_Paste.gbp, senseBe_rev4_main-B_SilkS.gbo, senseBe_rev4_main-Edge_Cuts.gm1, senseBe_rev4_main-F_Cu.gtl, senseBe_rev4_main-F_Mask.gts, senseBe_rev4_main-F_Paste.gtp]
2019-11-19 SenseBe rev4 manufacturing files
    [senseBe_rev4_main.kicad_pcb, senseBe_rev4_main.sch]
2019-11-21 senseBe_rev4_main BoMs updated
    There are 3 separate BoMs for Rx, Tx and both units together.
    [senseBe_rev4_main.xlsx, senseBe_rev4_main_Rx.xlsx, senseBe_rev4_main_Tx.xlsx]
2019-12-18 pogo connector pcb V1
    [pogo connector pcb-B_Cu.gbl, pogo connector pcb-B_Mask.gbs, pogo connector pcb-B_Paste.gbp, pogo connector pcb-B_SilkS.gbo, pogo connector pcb-Edge_Cuts.gm1, pogo connector pcb-F_Cu.gtl, pogo connector pcb-F_Mask.gts, pogo connector pcb-F_Paste.gtp]
2019-12-19 adds senseble_rev1 PCB design and gerber files
    [senseble_rev1-B_Cu.gbl, senseble_rev1-B_Mask.gbs, senseble_rev1-B_Paste.gbp, senseble_rev1-B_SilkS.gbo, senseble_rev1-Edge_Cuts.gm1, senseble_rev1-F_Cu.gtl, senseble_rev1-F_Mask.gts, senseble_rev1-F_Paste.gtp]
2019-12-20 modified silkscreen and pin naming.
    [senseble_rev1-B_Cu.gbl, senseble_rev1-B_Mask.gbs, senseble_rev1-B_Paste.gbp, senseble_rev1-B_SilkS.gbo, senseble_rev1-Edge_Cuts.gm1, senseble_rev1-F_Cu.gtl, senseble_rev1-F_Mask.gts, senseble_rev1-F_Paste.gtp]
2019-12-20 adds prog pin labling in silkscreen.
    [senseble_rev1-B_Cu.gbl, senseble_rev1-B_Mask.gbs, senseble_rev1-B_Paste.gbp, senseble_rev1-B_SilkS.gbo, senseble_rev1-Edge_Cuts.gm1, senseble_rev1-F_Cu.gtl, senseble_rev1-F_Mask.gts, senseble_rev1-F_Paste.gtp]
2020-01-09 Initial commit of the 2nd Rev of SenseEle Node PCB
    [CC1120.sch, nRF_Module.sch, senseEle_PCB_Antenna_rev2.kicad_pcb, senseEle_PCB_Antenna_rev2.sch]
2020-01-15 Added outputs of SenseEle PCB antenna rev 2
    [senseEle_PCB_Antenna_rev2-B_Cu.gbl, senseEle_PCB_Antenna_rev2-B_Mask.gbs, senseEle_PCB_Antenna_rev2-B_Paste.gbp, senseEle_PCB_Antenna_rev2-B_SilkS.gbo, senseEle_PCB_Antenna_rev2-Edge_Cuts.gm1, senseEle_PCB_Antenna_rev2-F_Cu.gtl, senseEle_PCB_Antenna_rev2-F_Mask.gts, senseEle_PCB_Antenna_rev2-F_Paste.gtp]
2020-01-15 Updated the design of PCB antenna SenseEle rev 2 with correct battery orientation
    [nRF_Module.sch, senseEle_PCB_Antenna_rev2.kicad_pcb]
2020-02-07 Update gerber files in SenseBle board
    [senseble_rev1-B_Cu.gbl, senseble_rev1-B_Mask.gbs, senseble_rev1-B_Paste.gbp, senseble_rev1-B_SilkS.gbo, senseble_rev1-Edge_Cuts.gm1, senseble_rev1-F_Cu.gtl, senseble_rev1-F_Mask.gts, senseble_rev1-F_Paste.gtp]
2020-02-07 Update net identifiers in schematic
    [senseble_rev1.kicad_pcb, senseble_rev1.sch]
2020-02-07 Update SenseEle PCB rev2
    [nRF_Module.sch, senseEle_PCB_Antenna_rev2.kicad_pcb]
2020-02-14 GPS adapter board sent for manufacturing
    [SenseEle_GPS_adapter-B_Cu.gbl, SenseEle_GPS_adapter-B_Mask.gbs, SenseEle_GPS_adapter-B_SilkS.gbo, SenseEle_GPS_adapter-Edge_Cuts.gm1, SenseEle_GPS_adapter-F_Cu.gtl, SenseEle_GPS_adapter-F_Mask.gts, SenseEle_GPS_adapter-F_SilkS.gto, SenseEle_GPS_adapter-NPTH.drl]
2020-03-19 Parts - symbols and footprints added for senseRx rev1
2020-03-19 First commit of the senseRx rev1 board sent for mauf
    [Teensy_gsm.sch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]
2020-03-23 First commit of L80 GPS module adapter for SenseEle
    [L80_adapter-B_Cu.gbr, L80_adapter-B_Mask.gbr, L80_adapter-B_SilkS.gbr, L80_adapter-Edge_Cuts.gbr, L80_adapter-F_Cu.gbr, L80_adapter-F_Mask.gbr, L80_adapter-F_SilkS.gbr, L80_adapter-NPTH.drl]
2020-03-23 Added L80 and 3mm Inductor footprint
2024-11-12 PCB for SensePi for Yashpal with BoM
    [SensePi_yashpal-B_Cu.gbr, SensePi_yashpal-B_Mask.gbr, SensePi_yashpal-B_Paste.gbr, SensePi_yashpal-B_Silkscreen.gbr, SensePi_yashpal-Edge_Cuts.gbr, SensePi_yashpal-F_Cu.gbr, SensePi_yashpal-F_Mask.gbr, SensePi_yashpal-F_Paste.gbr]
